torok-samuel/Digital-synthesizer-project/README.md

# Digital-synthesizer-project
Digital synthesizer project for university thesis.
