torok-samuel/Digital-synthesizer-project/freecad/8720efe9-da5f-489d-a8d7-8e3d5238dedc.91f98a0f974cae4ed9347f34f55e257e.webp

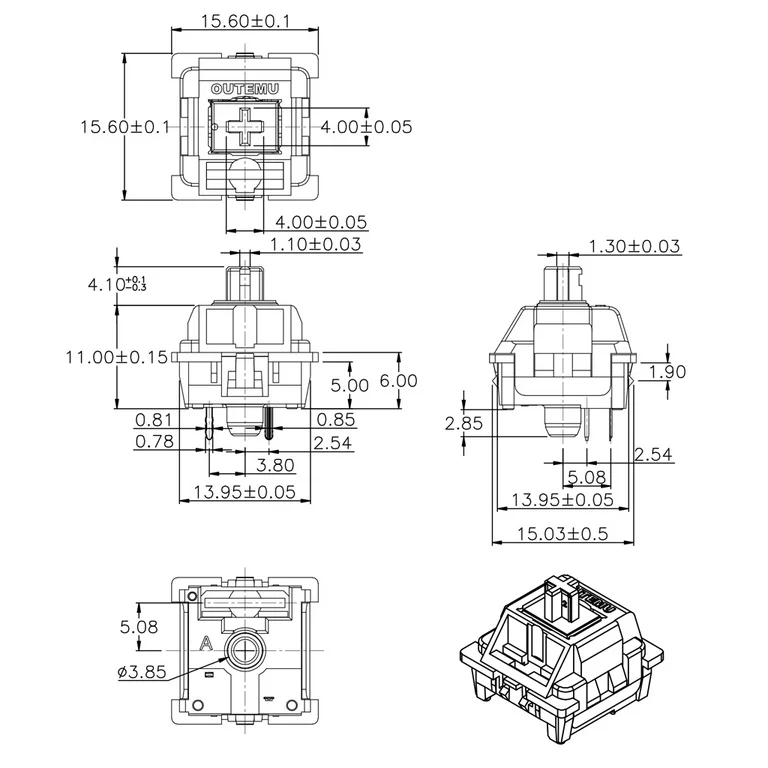
freecad/8720efe9-da5f-489d-a8d7-8e3d5238dedc.91f98a0f974cae4ed9347f34f55e257e.webp
