torok-samuel/Digital-synthesizer-project/freecad/black key/BlackKey.FCStd

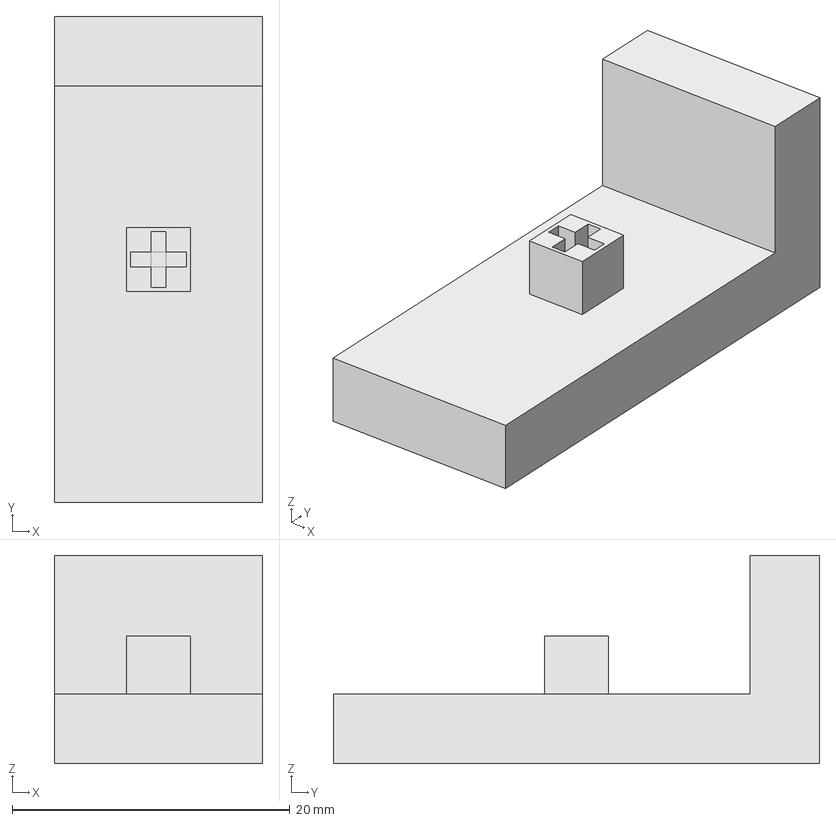
[picture p2: CAD file, 2023-10-30]
freecad/black key/BlackKey.FCStd
15.0 x 35.0 x 15.0 mm
