torok-samuel/Digital-synthesizer-project/freecad/key keyboard plate/KeyPlate.FCStd

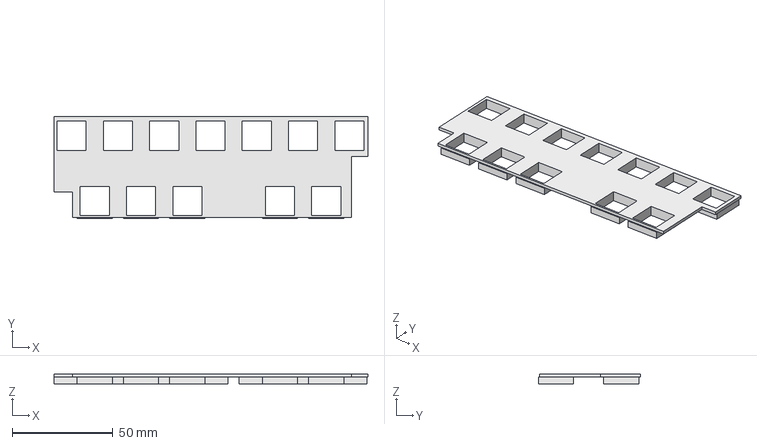
[picture p3: CAD file, 2023-11-30]
freecad/key keyboard plate/KeyPlate.FCStd
156.0 x 50.9 x 5.00 mm
