torok-samuel/Digital-synthesizer-project/freecad/pot keyboard plate/PotKeyPlate.FCStd

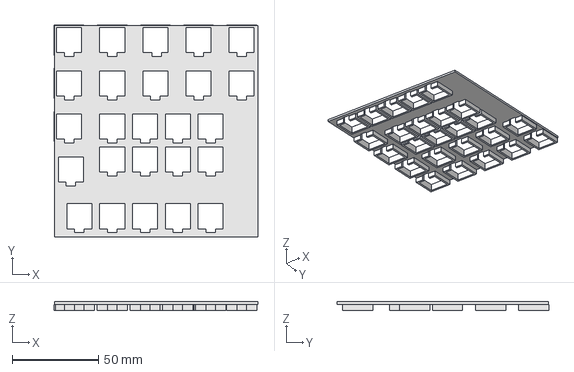
[picture p4: CAD file, 2023-11-30]
freecad/pot keyboard plate/PotKeyPlate.FCStd
118.2 x 122.7 x 5.00 mm
