torok-samuel/Digital-synthesizer-project/freecad/white key/WhiteKey-Body.stl

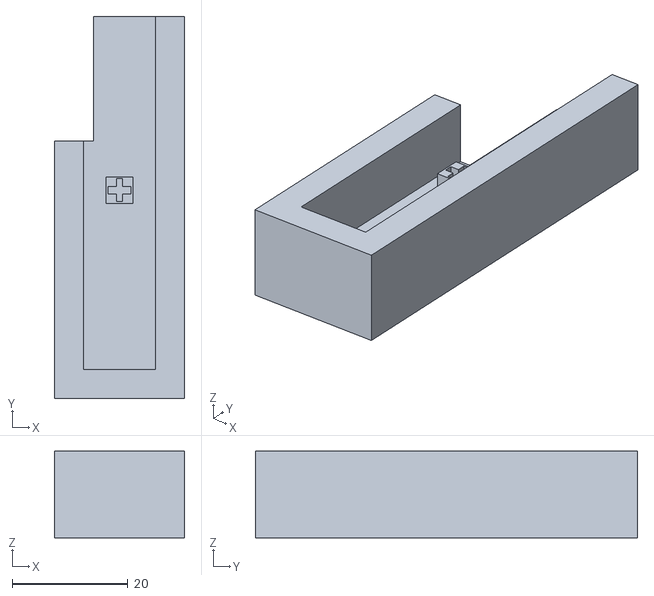
[picture p5: CAD file, 2023-10-30]
freecad/white key/WhiteKey-Body.stl
22.5 x 66.0 x 15.0
