torok-samuel/Digital-synthesizer-project/freecad/white key3/WhiteKey3.FCStd

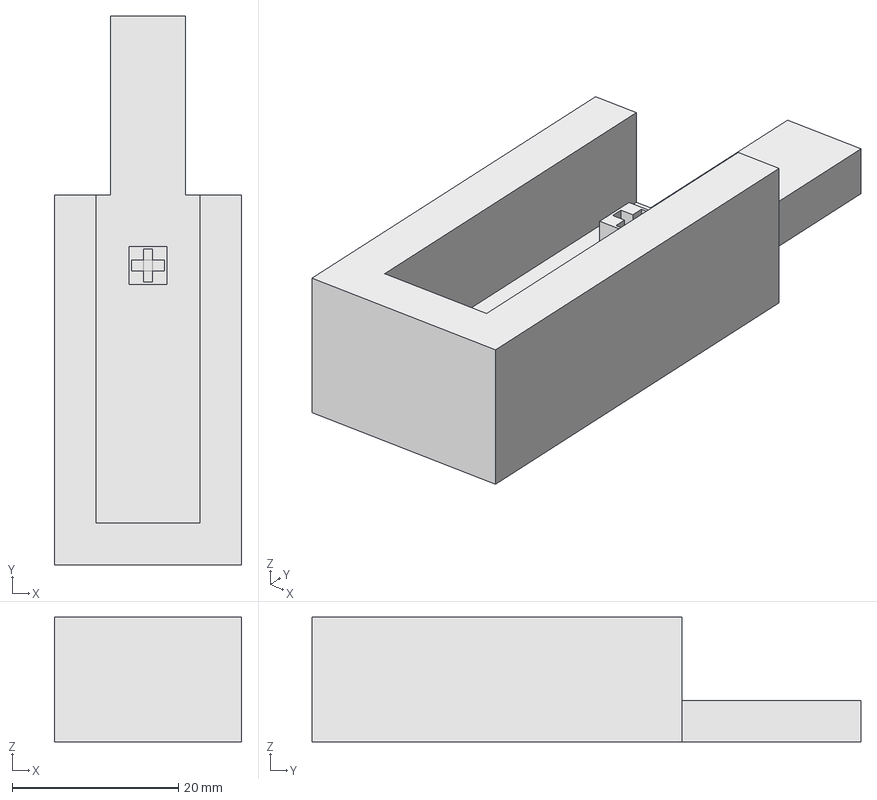
[picture p6: CAD file, 2023-10-30]
freecad/white key3/WhiteKey3.FCStd
22.5 x 66.0 x 15.0 mm
