torok-samuel/Digital-synthesizer-project/(list of files, cad)

Other CAD files:
freecad/white key2/WhiteKey2-Body.stl
freecad/black key/BlackKey-Body.stl
freecad/key keyboard plate/KeyPlate-Body.stl
freecad/pot keyboard plate/PotKeyPlate-Body.stl
freecad/white key/WhiteKey.FCStd
freecad/white key2/WhiteKey2.FCStd
freecad/white key3/WhiteKey3-Body.stl
