torok-samuel/Digital-synthesizer-project/Keyboard/keyboard/pdf/keyboard.pdf

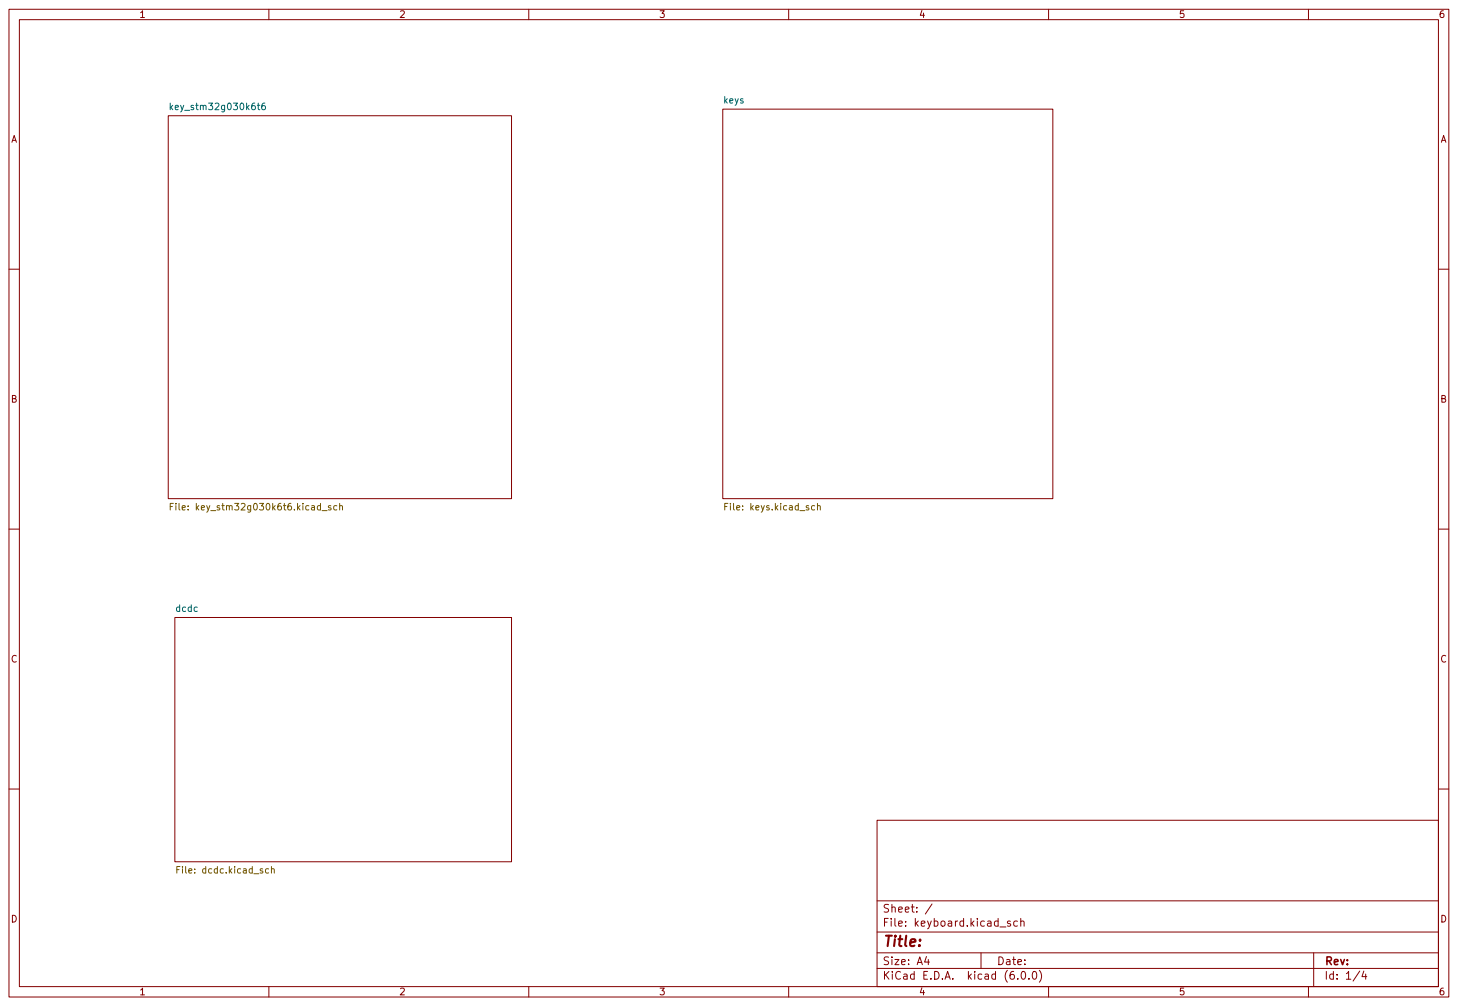
[picture p7: page 1]

File: keyboard.kicad_sch Sheet: / dcdc File: dcdc.kicad_sch

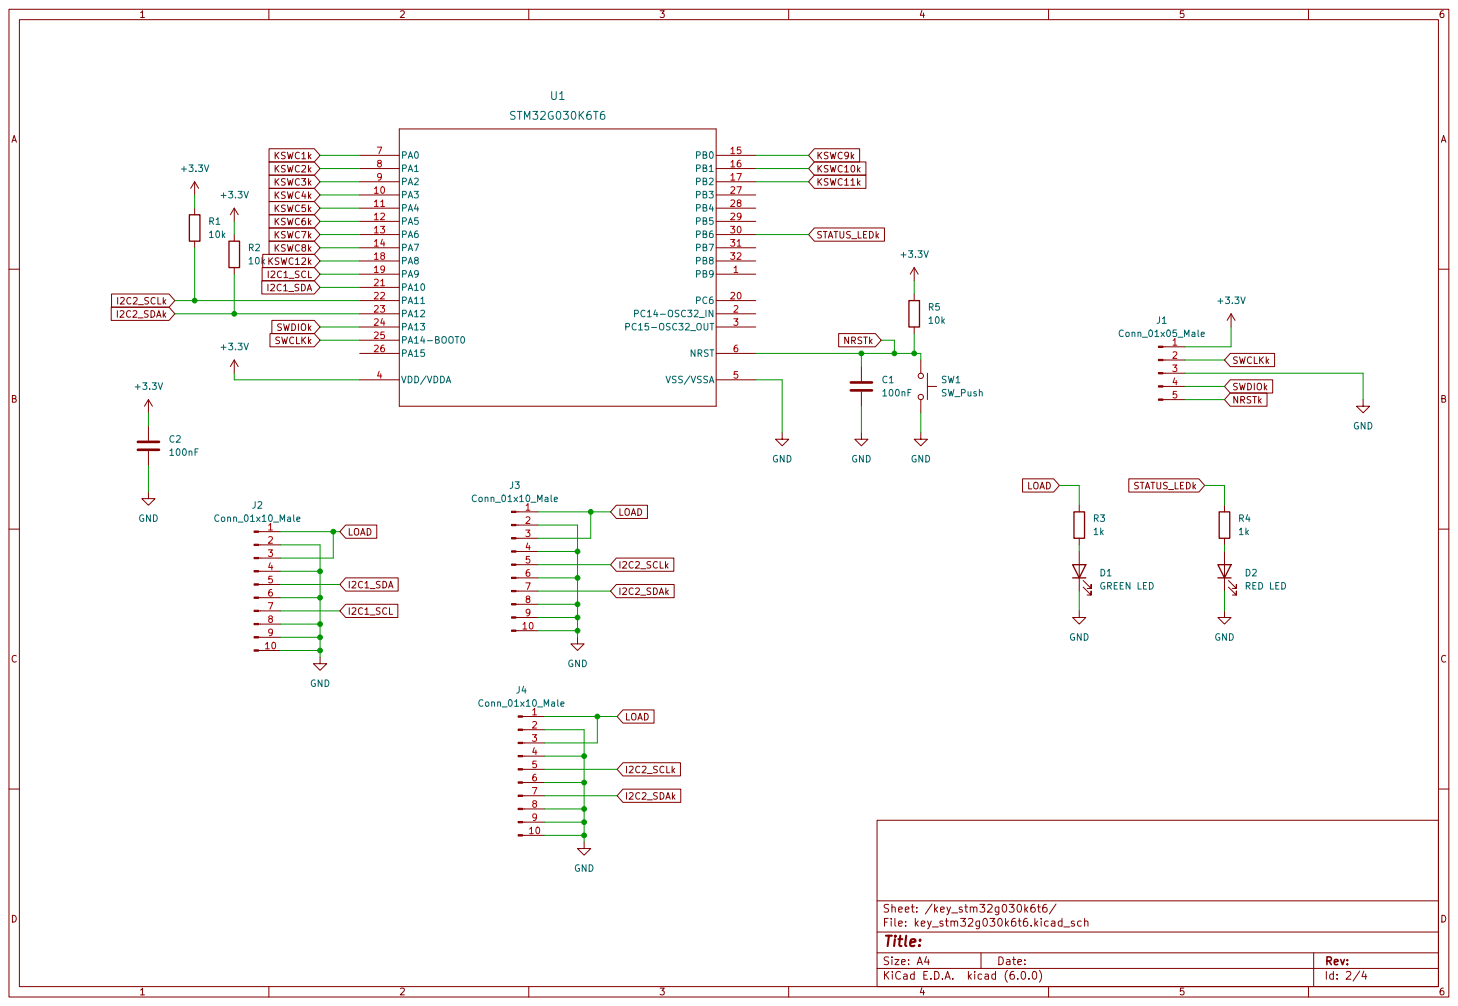
[picture p8: page 2]

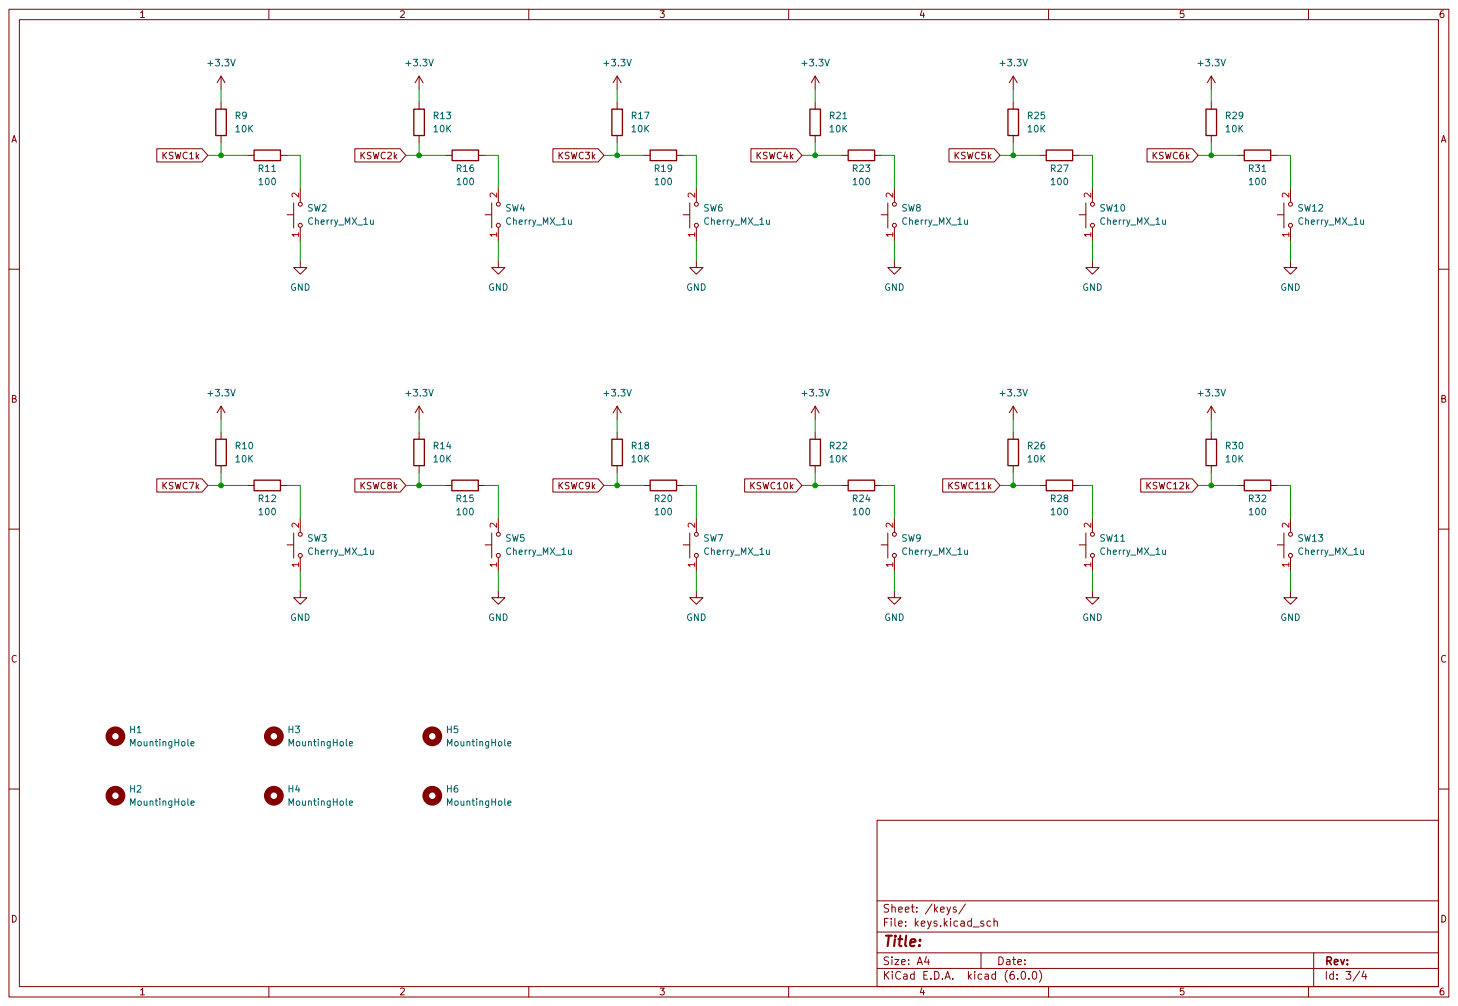
[picture p9: page 3]

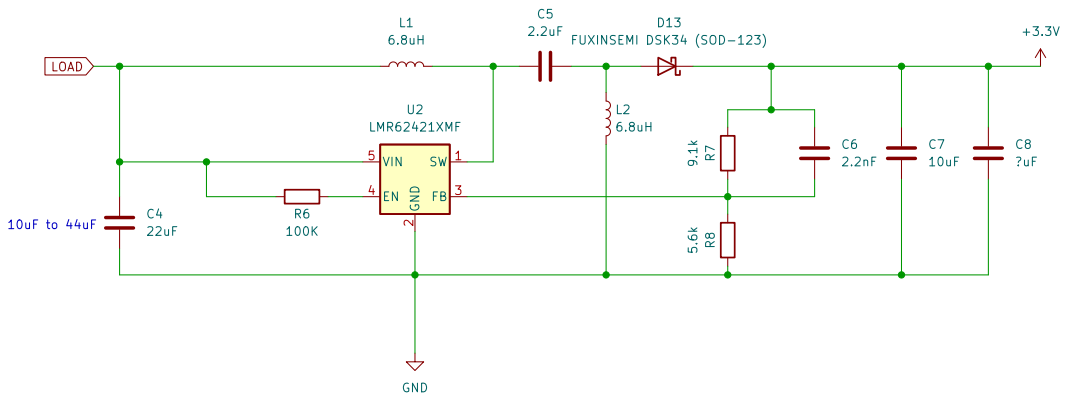
[picture p10: page 4]

File: dcdc.kicad_sch Sheet: /dcdc/
Id: 4/4 Title:
