torok-samuel/Digital-synthesizer-project/main_func/main_func/pdf/main_func.pdf

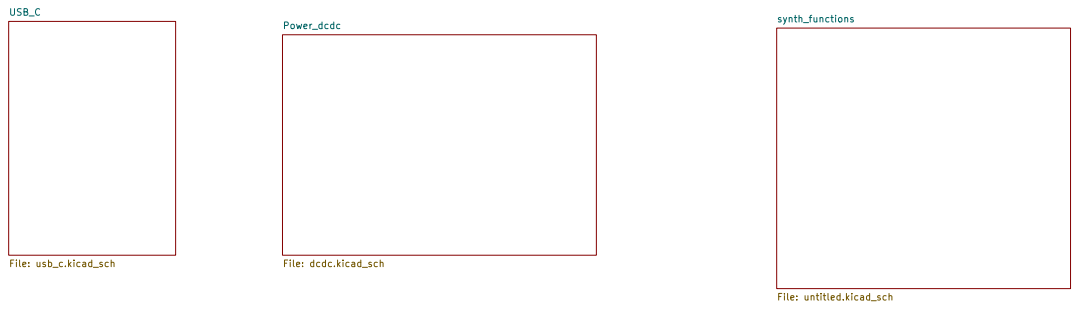
[picture p11: page 1]

synth_functions File: untitled.kicad_sch Power_dcdc File: dcdc.kicad_sch USB_C

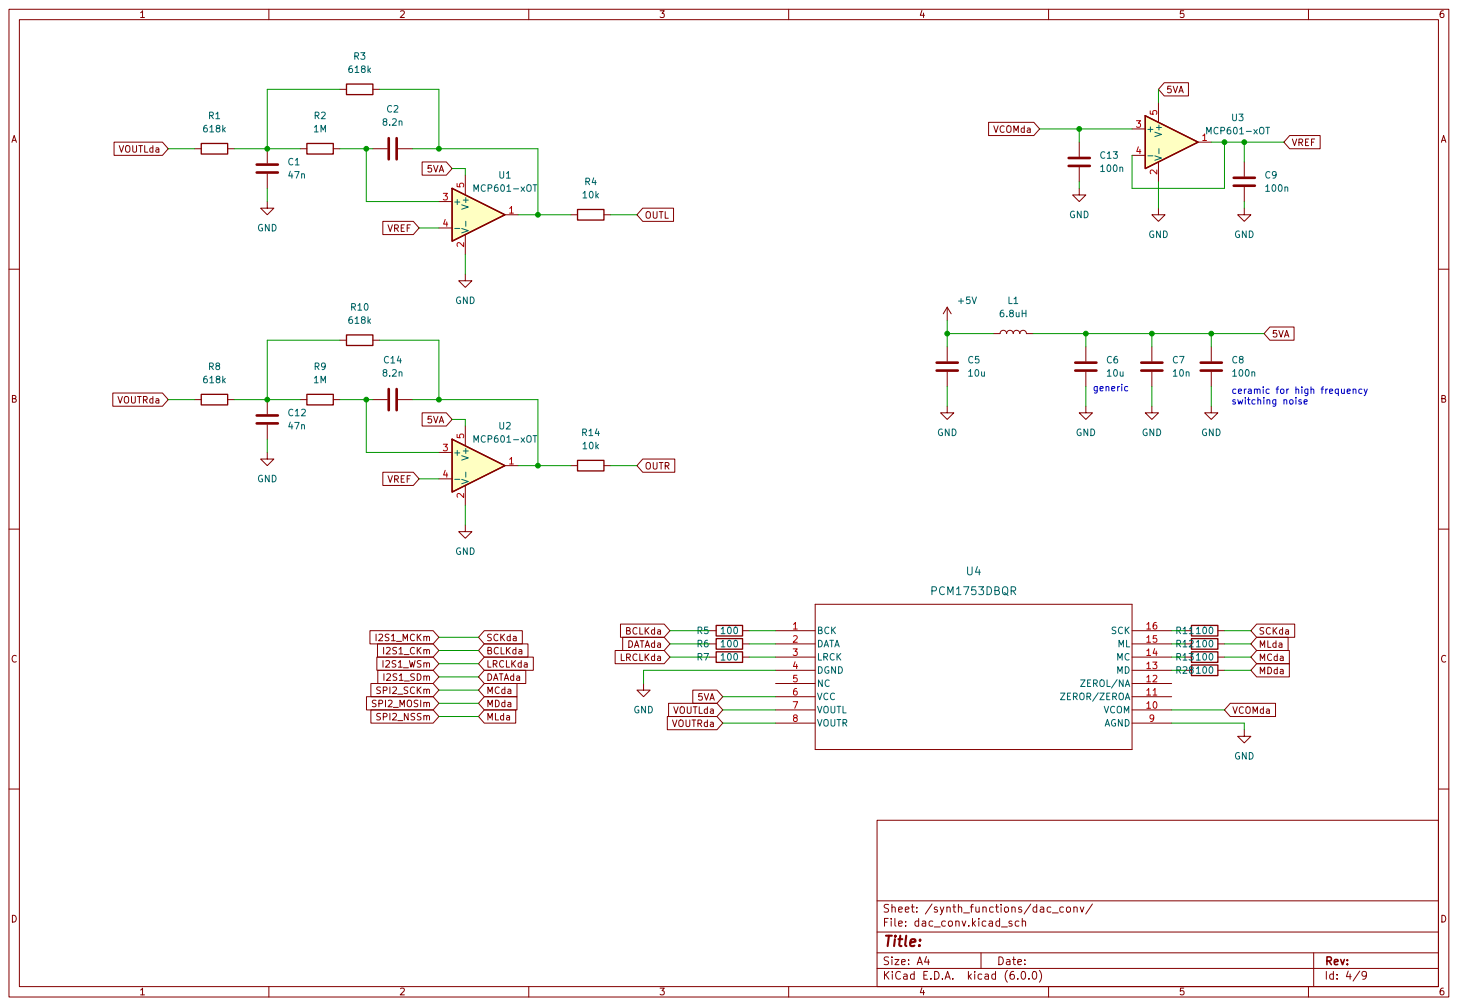
[picture p12: page 2]

ceramic for high frequency
switching noise

MDda VCOMda DATAda BCLKda VOUTRda

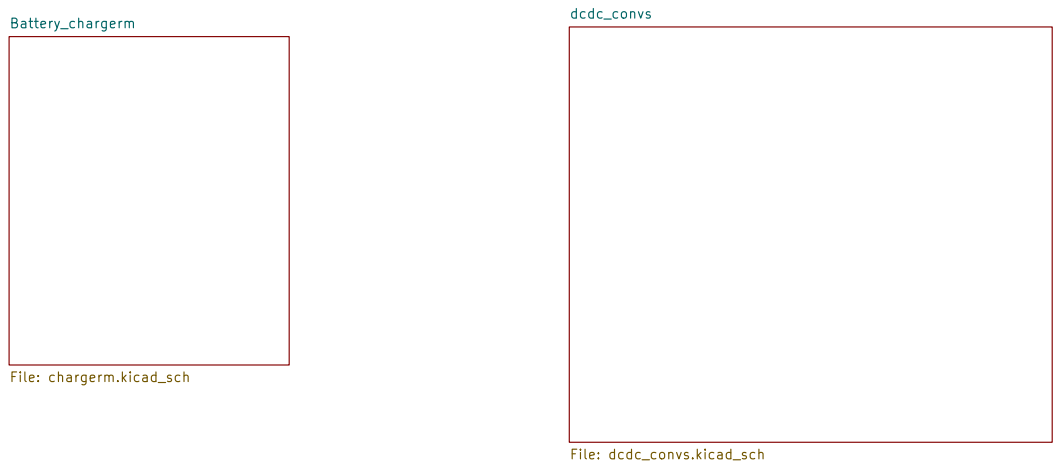
[picture p13: page 3]

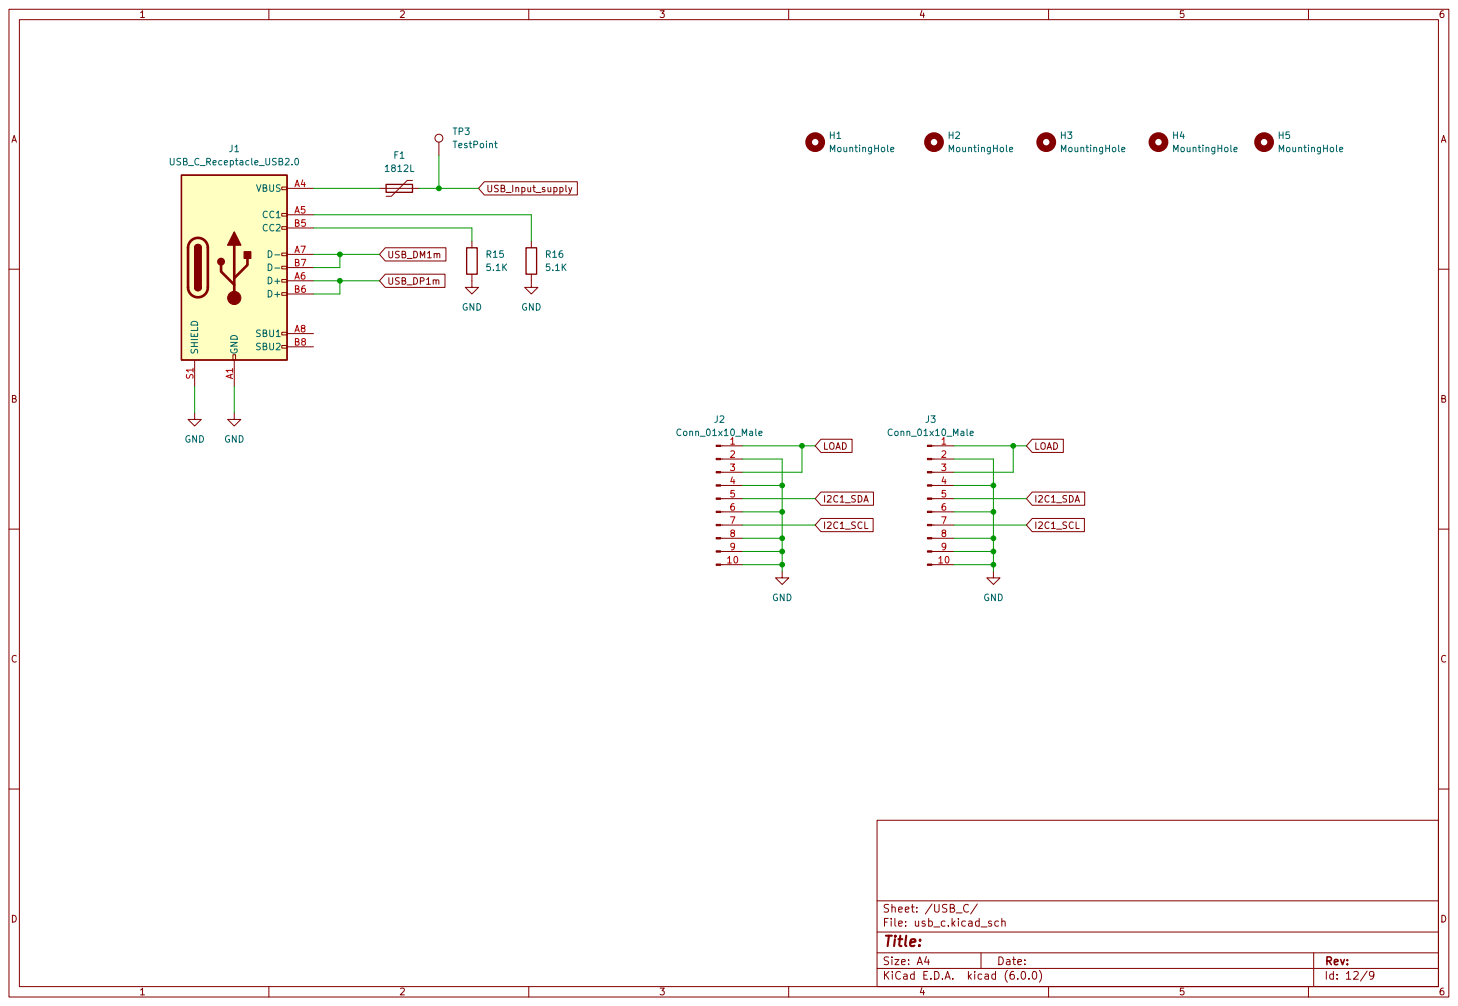
[picture p14: page 4]

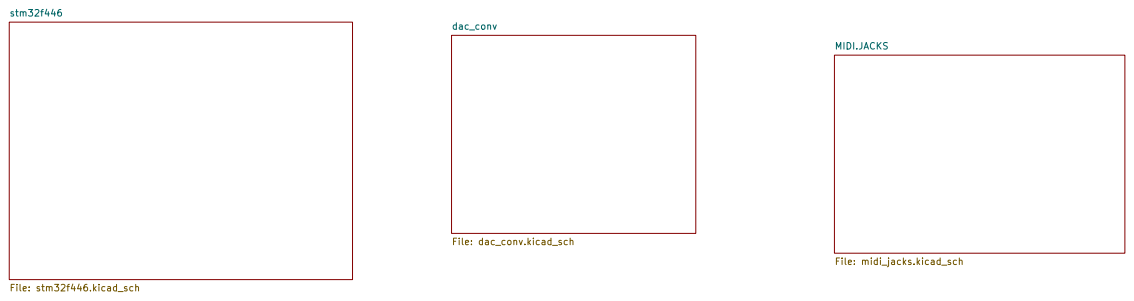
[picture p15: page 5]

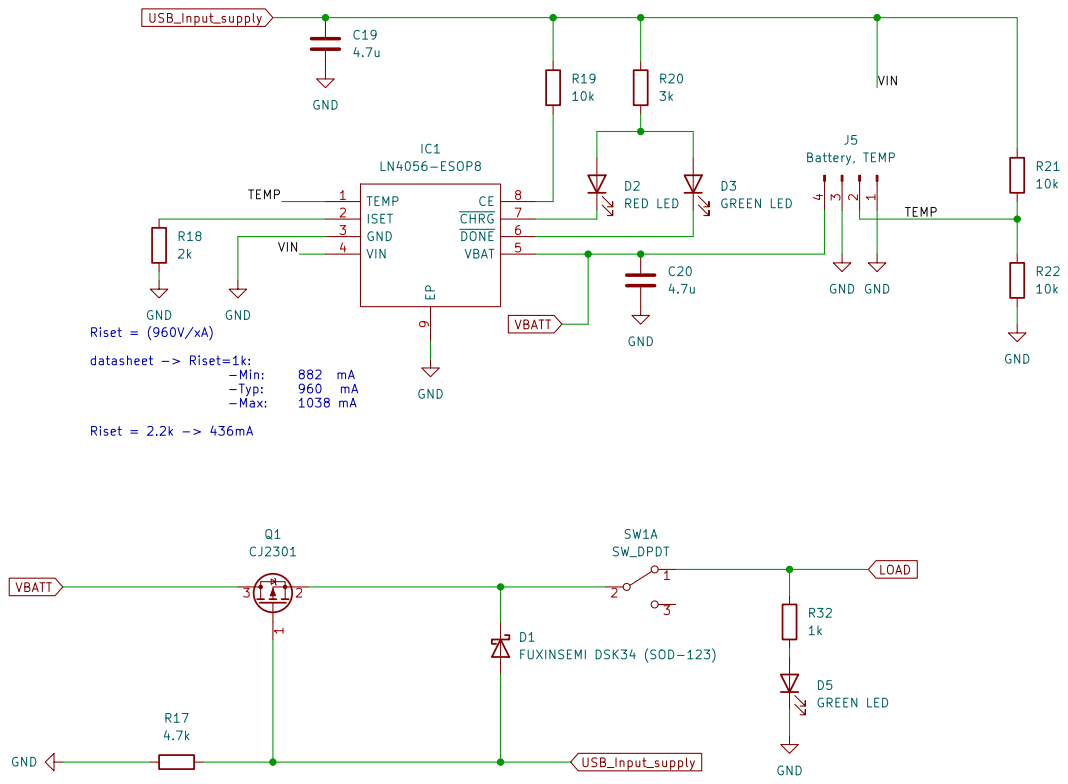
[picture p16: page 6]

TEMP Riset = (960V/xA) datasheet -> Riset=1k:

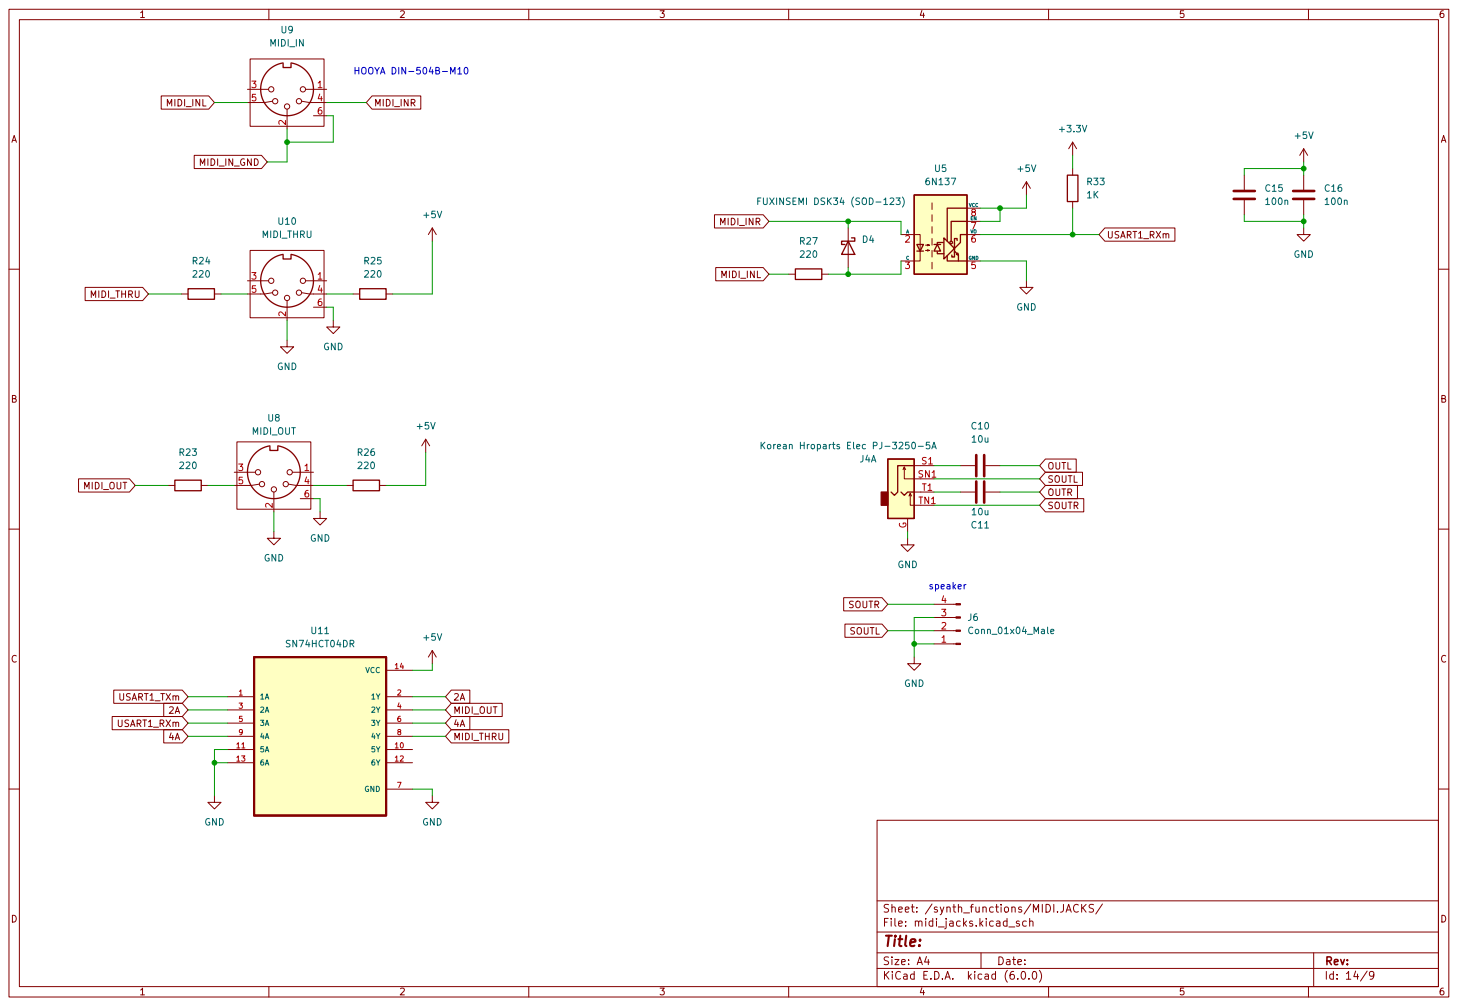
[picture p17: page 7]

Korean Hroparts Elec PJ-3250-5A GND

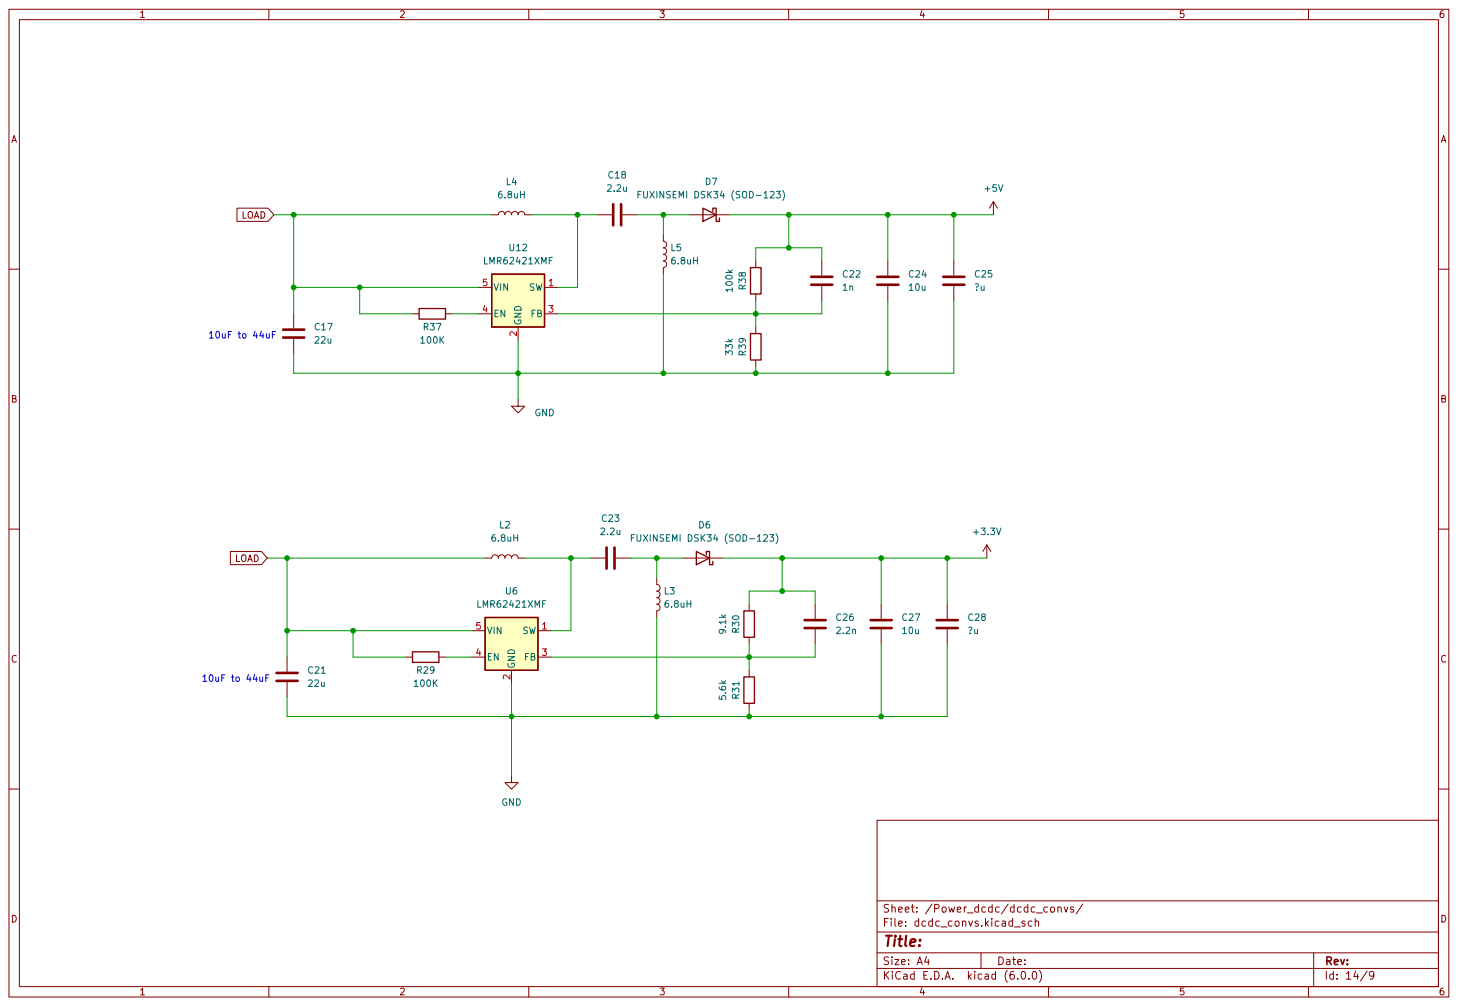
[picture p18: page 8]

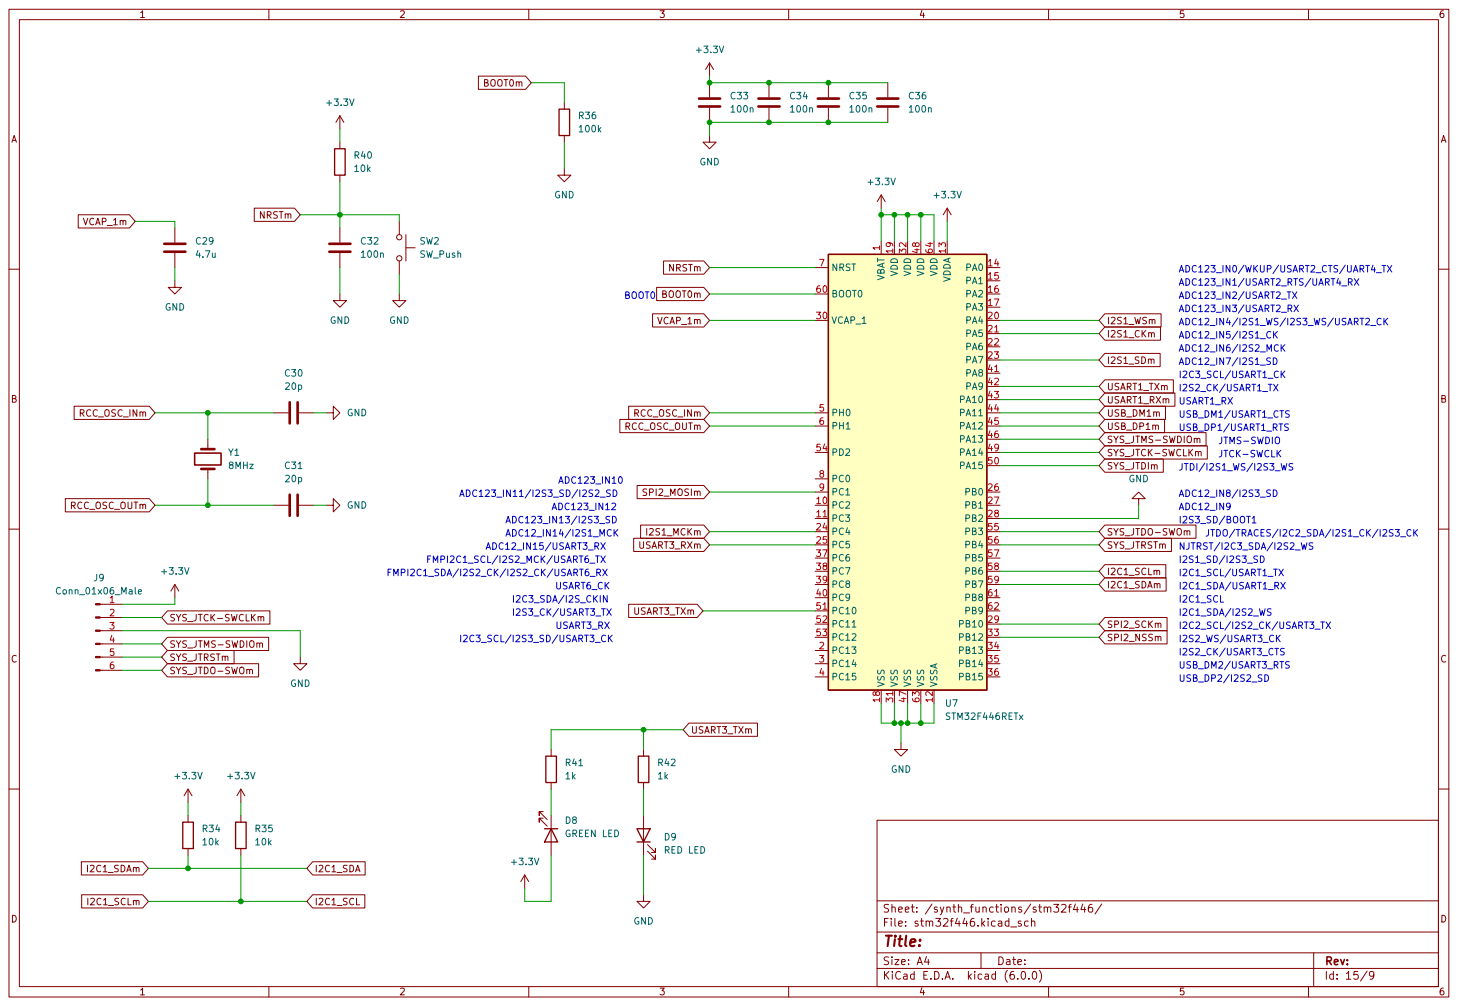
[picture p19: page 9]

1 PC2 10 PC3 11 VSSA 12 VDDA 13 PA0 14 PA1 15 PA2 16 PA3 17 VSS 18 VDD 19 PC13 2 PA4 20 PA5 21 PA6 22 PA7 23 PC4 24 PC5 25 PB0 26 PB1 27 PB2 28 PB10 29 PC14 3 VCAP_1 30 VSS 31 VDD 32 PB12 33 PB13 34 PB14 35 PB15 36 PC6 37 PC7 38 PC8 39 PC15 4 PC9 40 PA8 41 PA9 42 PA10 43 PA11 44 PA12 45 PA13 46 VSS 47 VDD 48 PA14 49 PH0 5 PA15 50 PC10 51 PC11 52 PC12 53 PD2 54 PB3 55 PB4 56 PB5 57 PB6 58 PB7 59 PH1 6 BOOT0 60 PB8 61 PB9 62 VSS 63 VDD 64 NRST 7 PC0 8 PC1 9 U7STM32F446RETx C30
