torok-samuel/Digital-synthesizer-project/Pot.butt_pcb/Pot.butt_pcb/pdf/Pot.butt_pcb.pdf

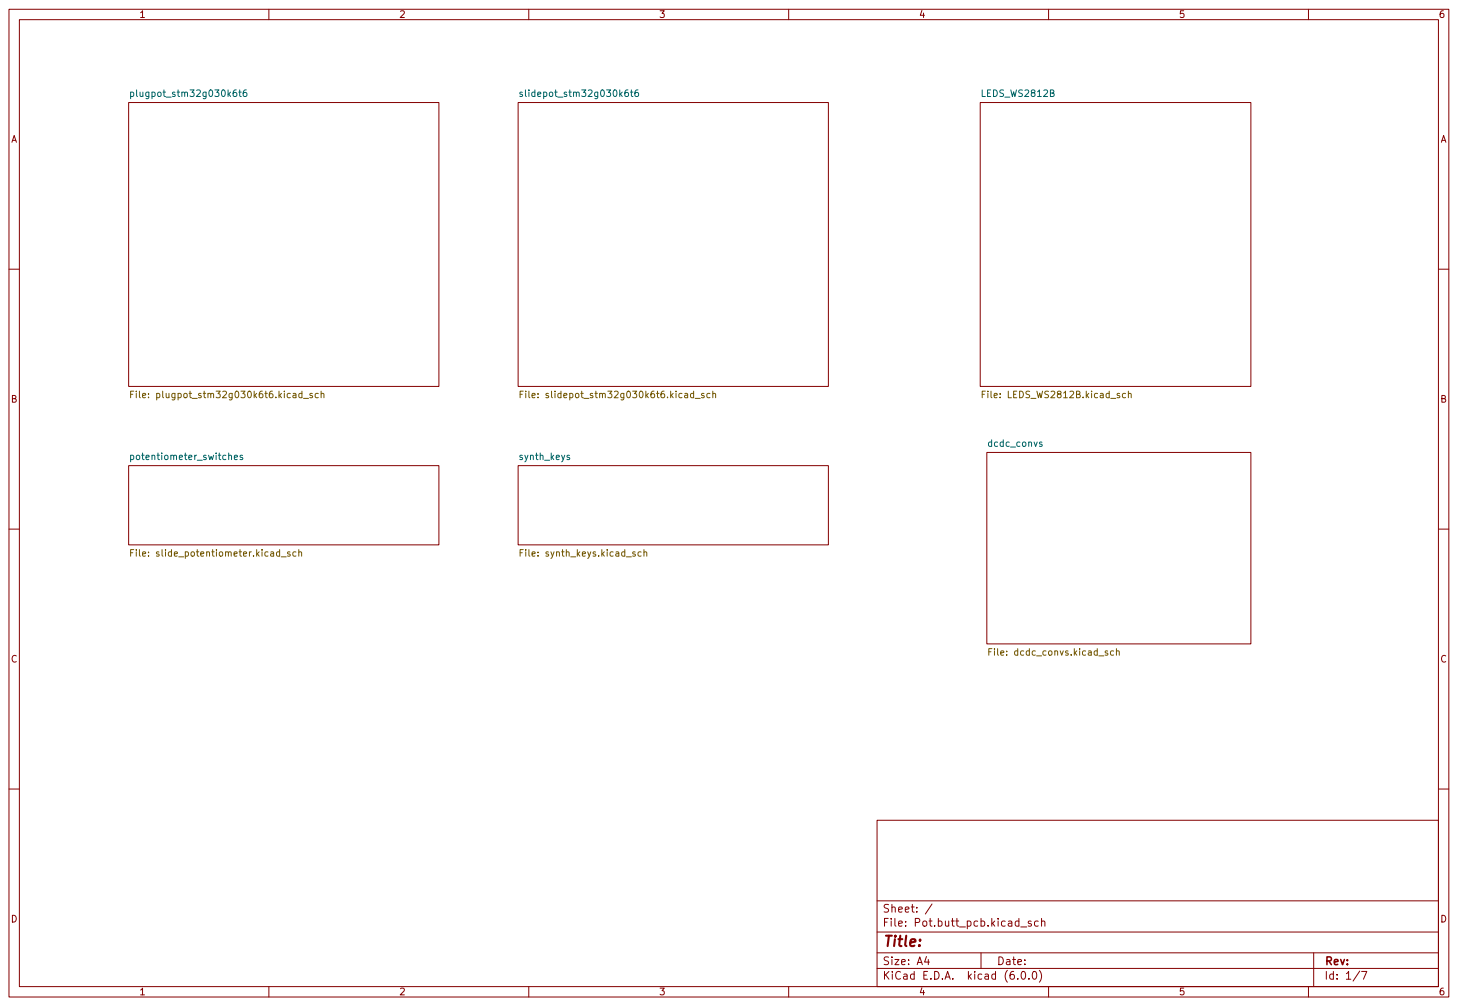
[picture p20: page 1]

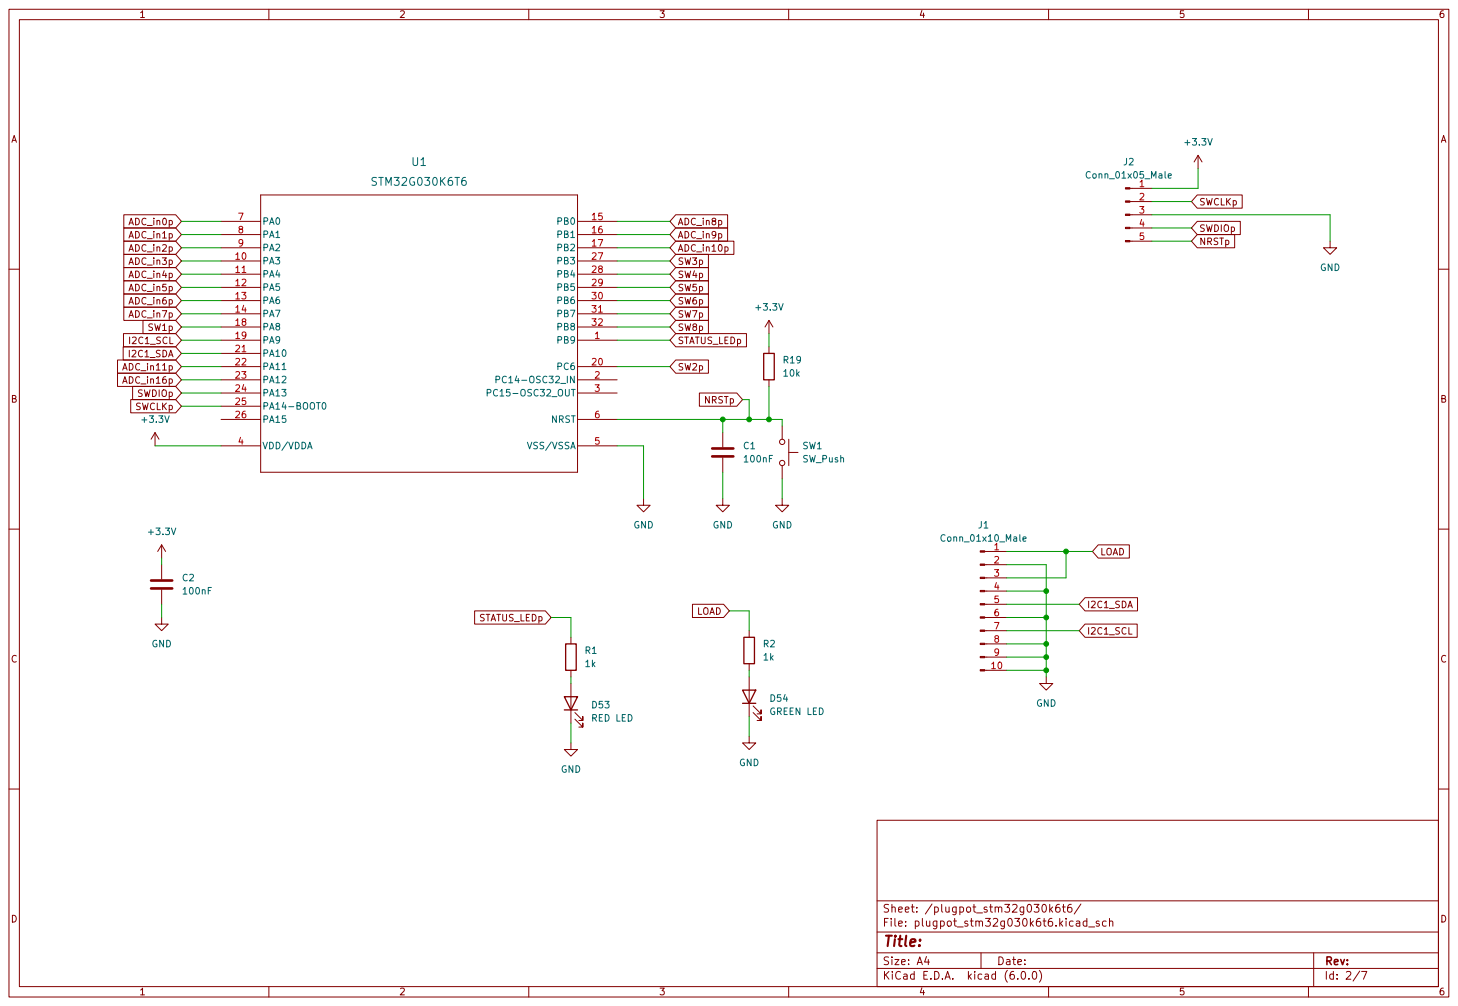
[picture p21: page 2]

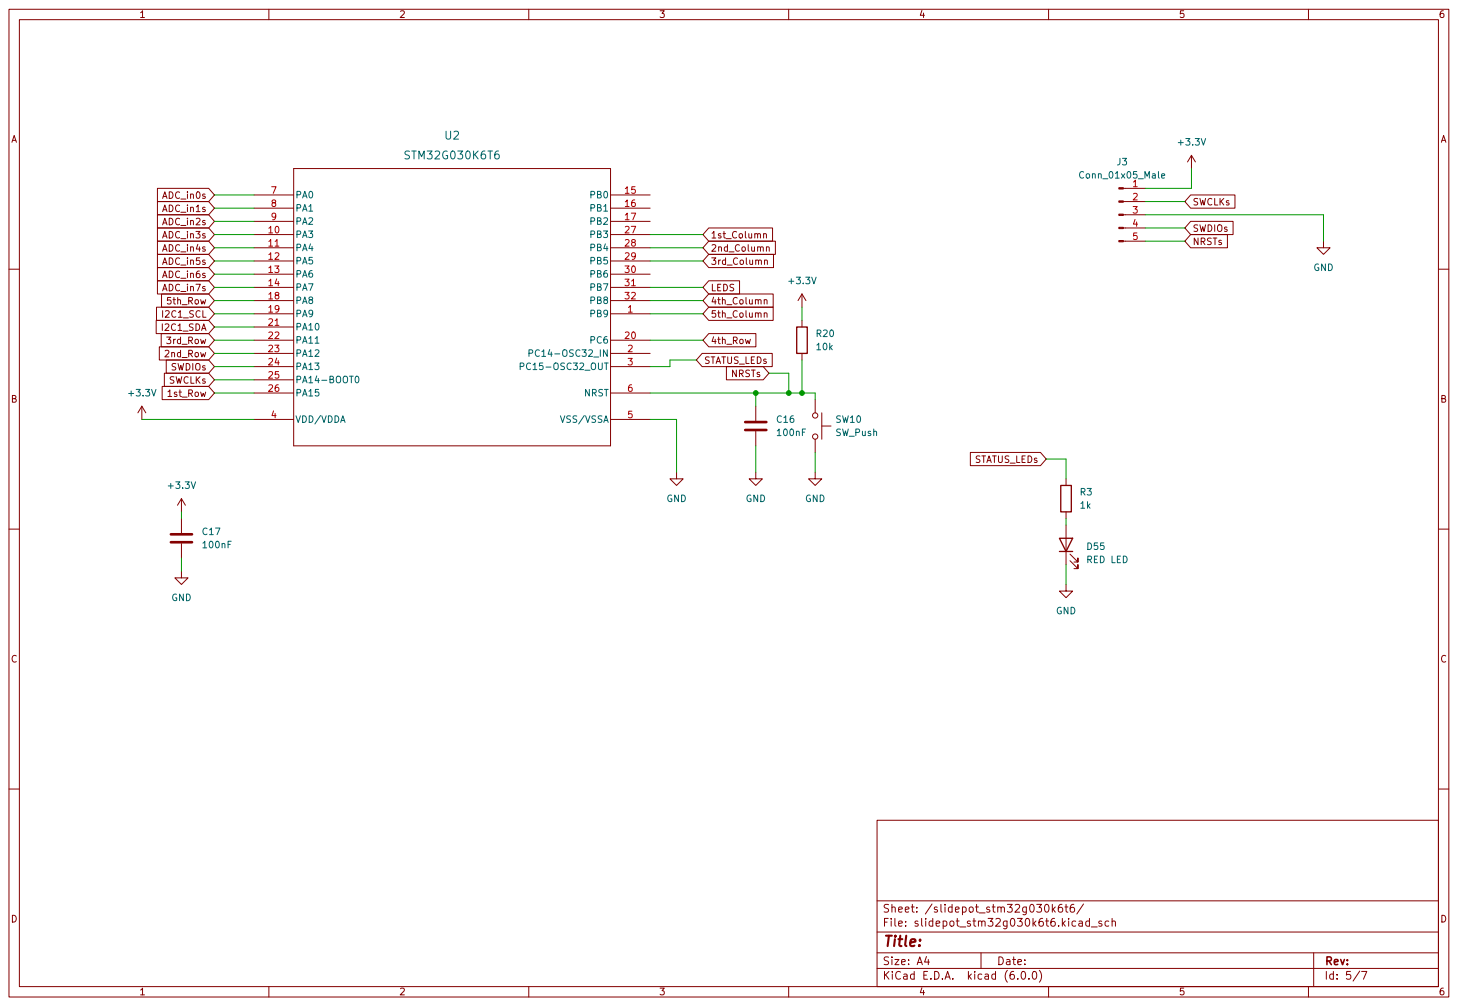
[picture p22: page 3]

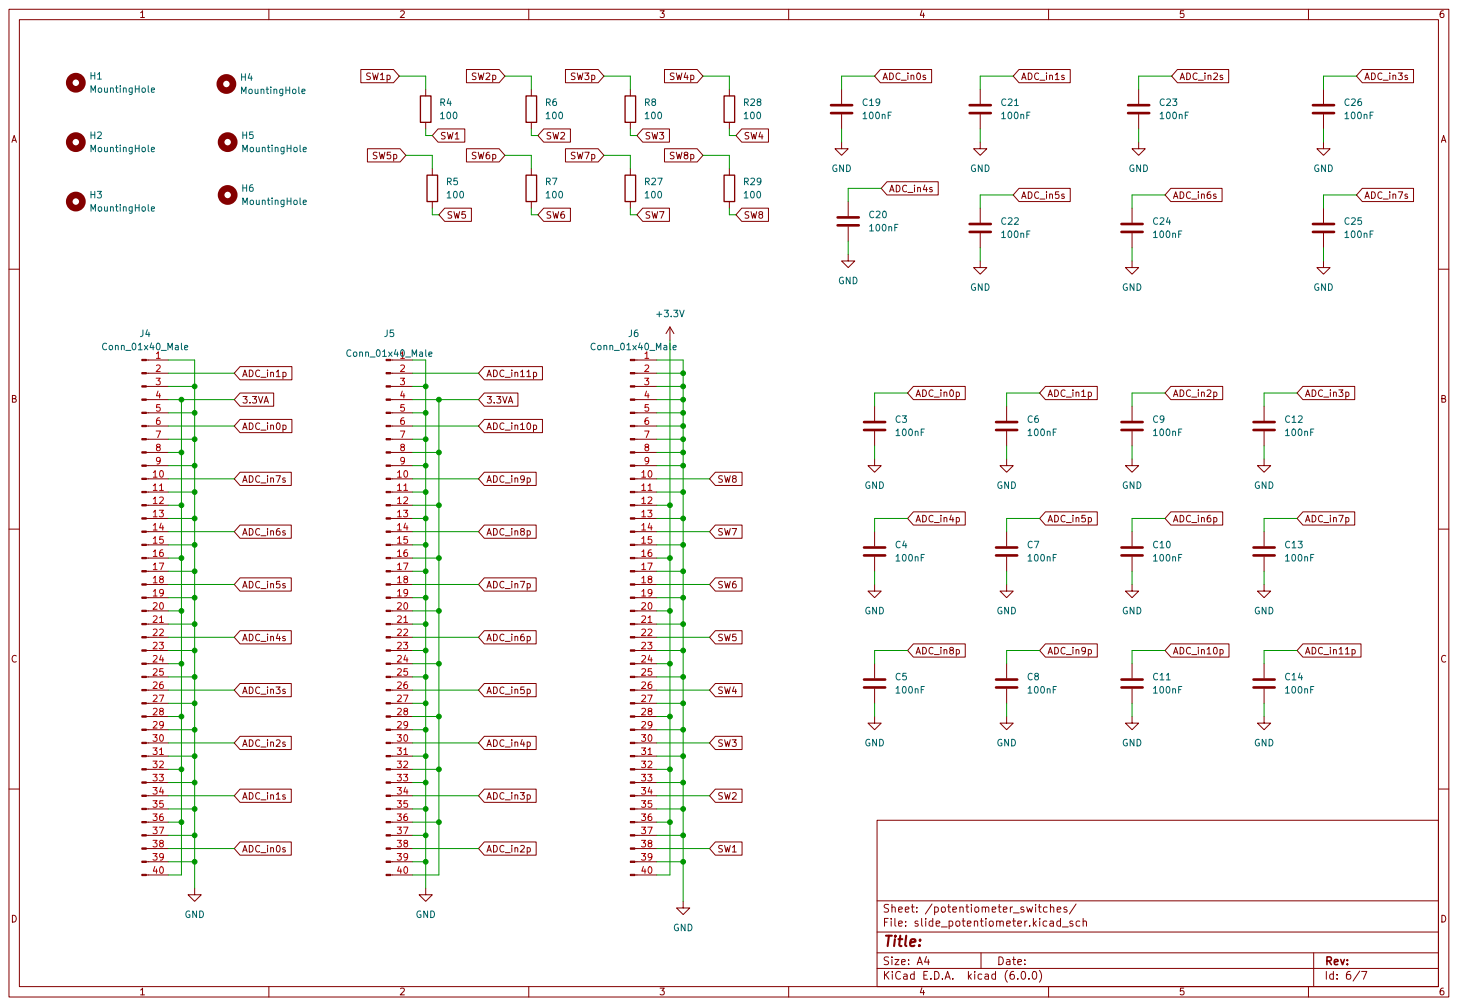
[picture p23: page 4]

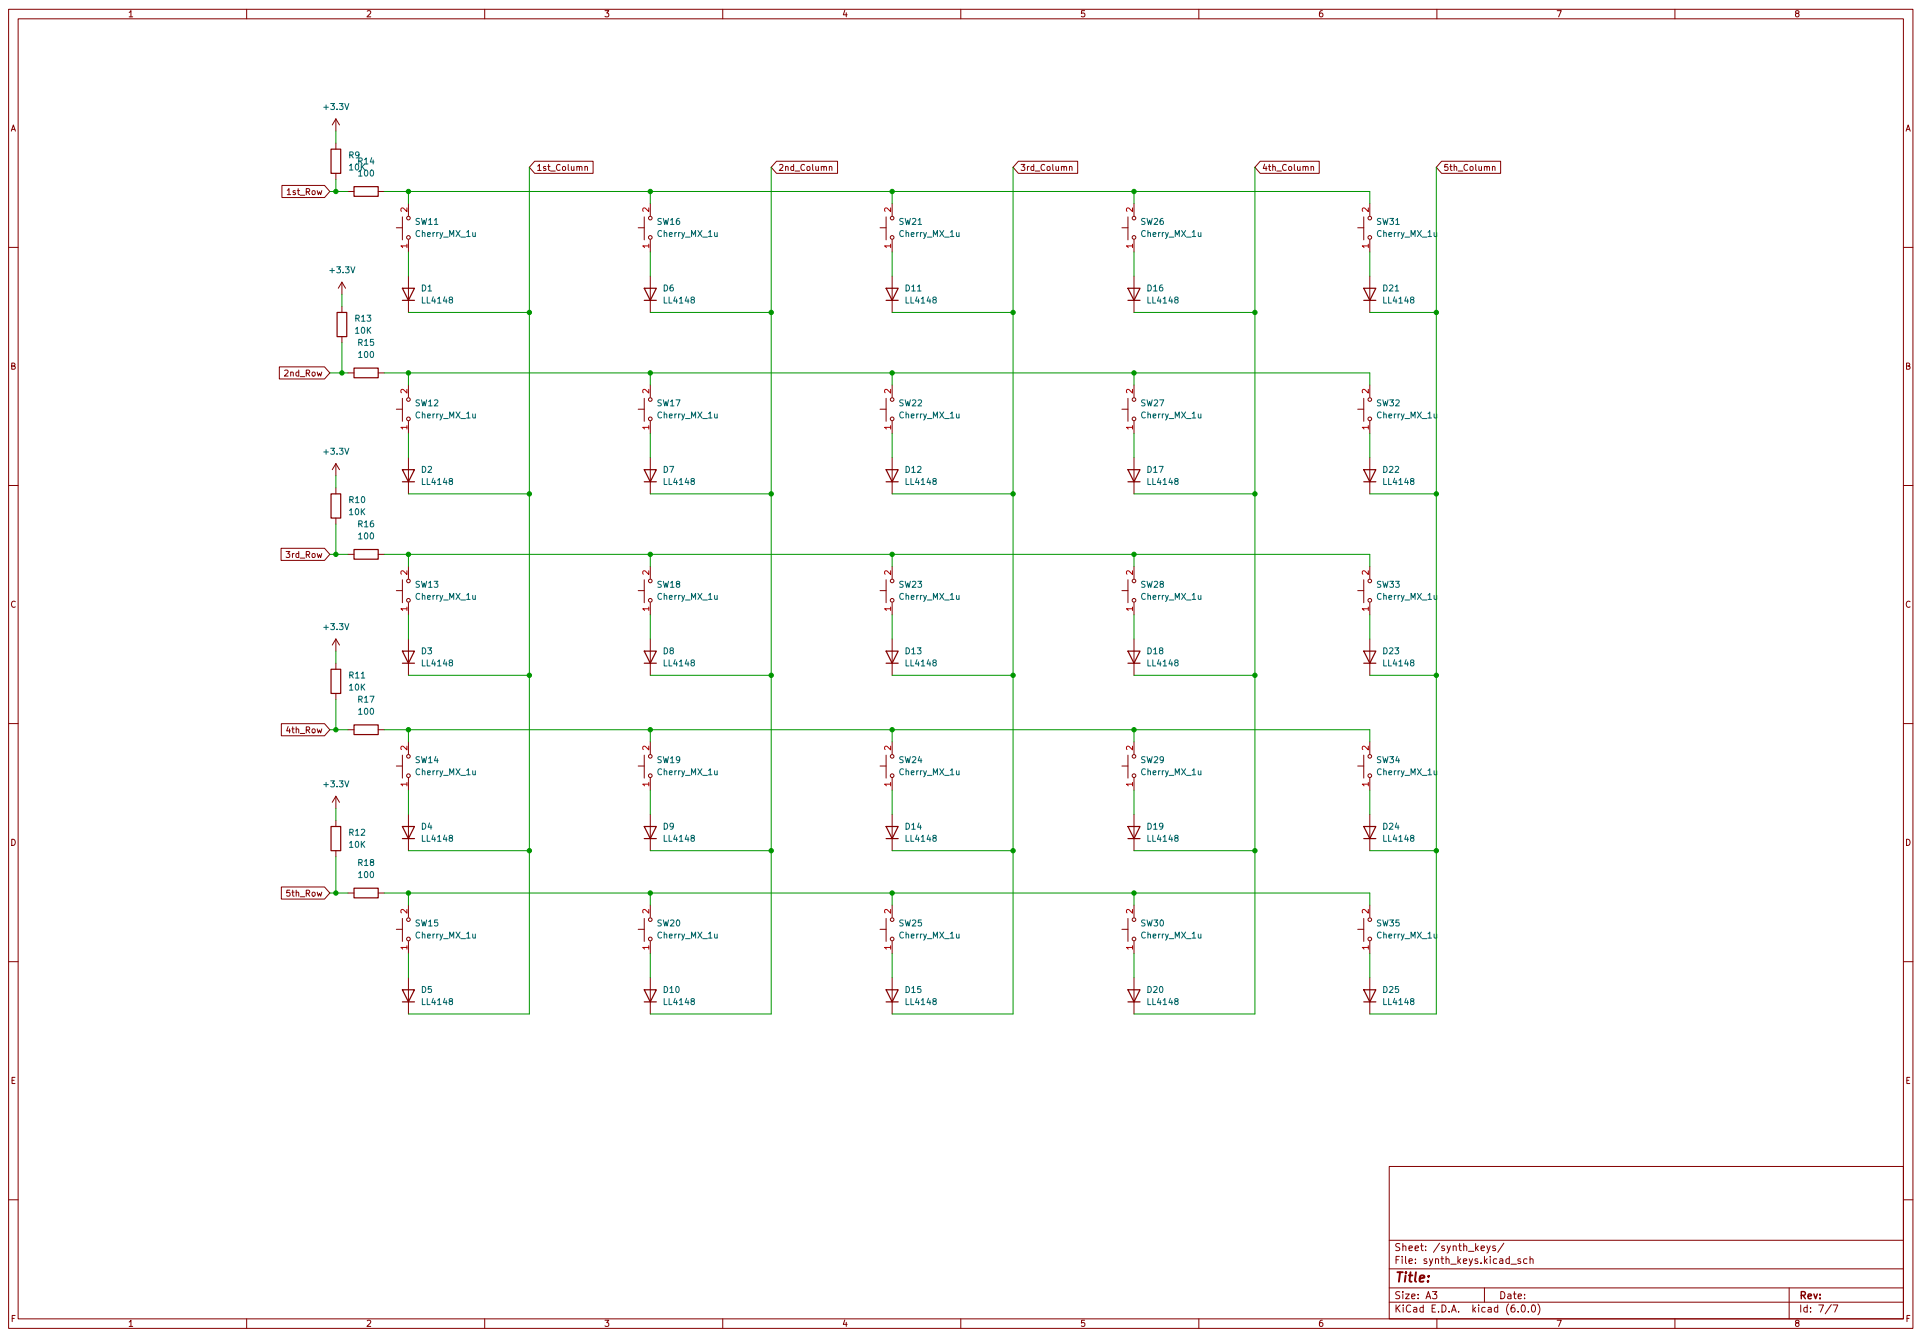
[picture p24: page 5]

Id: 7/7 Title: File: synth_keys.kicad_sch Sheet: /synth_keys/

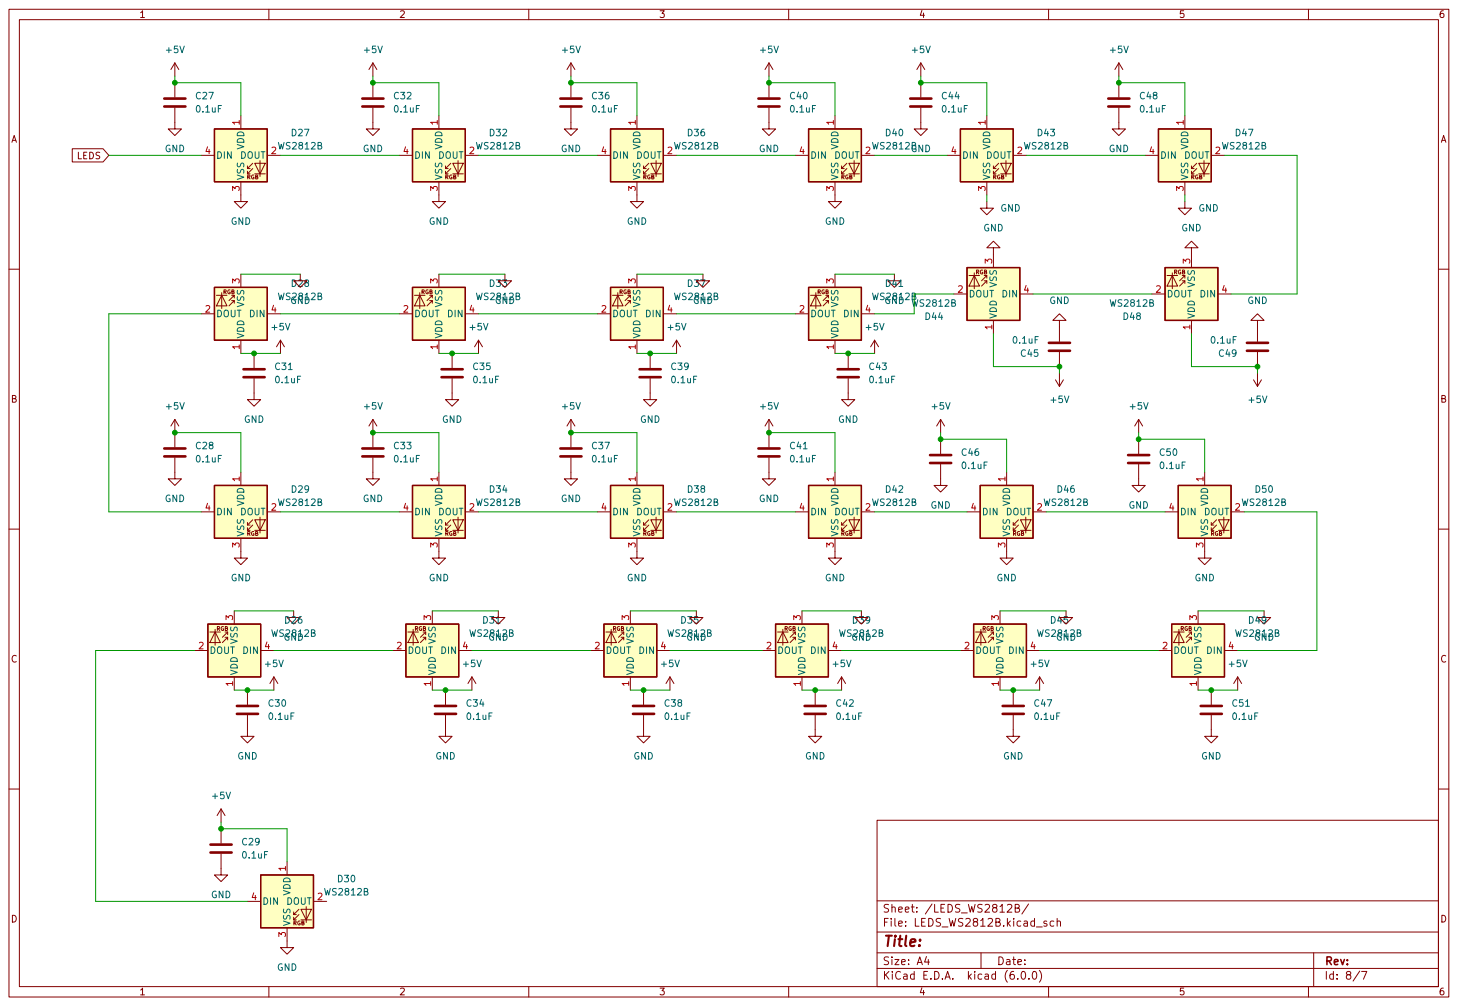
[picture p25: page 6]

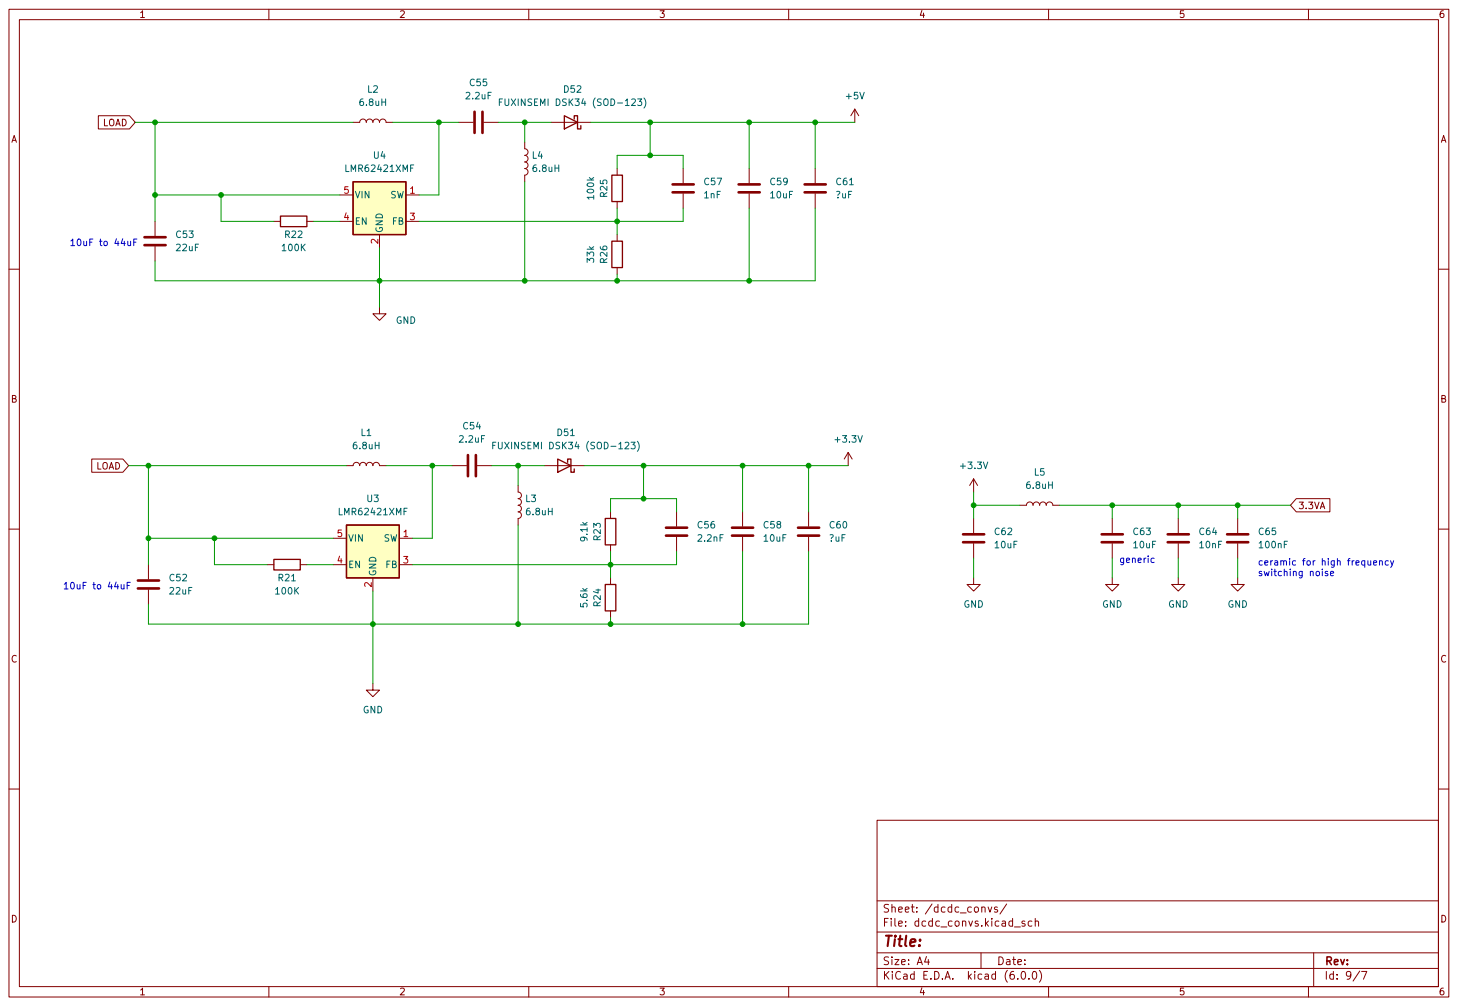
[picture p26: page 7]
