torok-samuel/Digital-synthesizer-project/Pot.butt_pcb/Pot.butt_pcb/Pot.butt_pcb.kicad_pcb

## KiCad design Pot.butt_pcb/Pot.butt_pcb/Pot.butt_pcb.kicad_pcb (2023-05-13)

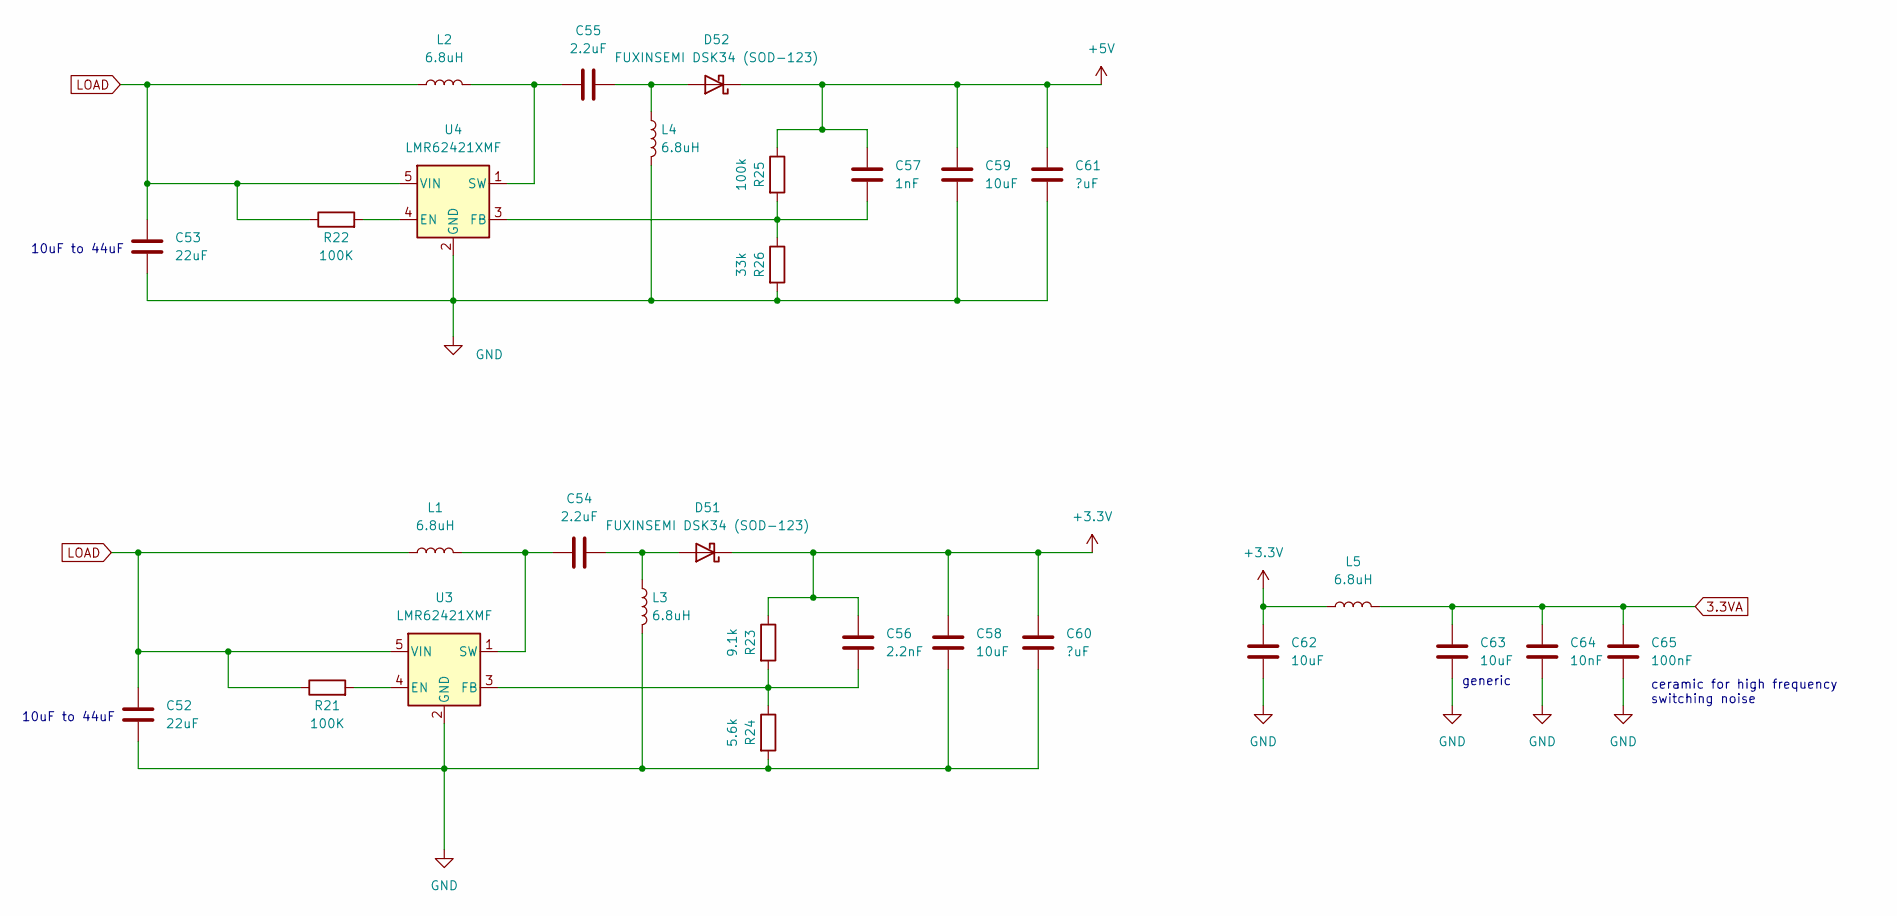
[picture p27: schematic dcdc_convs.kicad_sch]

Parts:
C52, C53: 22uF; C_0805_2012Metric_Pad1.18x1.45mm_HandSolder
C54, C55: 2.2uF; C_0805_2012Metric_Pad1.18x1.45mm_HandSolder
C56: 2.2nF; C_0805_2012Metric_Pad1.18x1.45mm_HandSolder
C57: 1nF; C_0805_2012Metric_Pad1.18x1.45mm_HandSolder
C58, C59, C62, C63: 10uF; C_0805_2012Metric_Pad1.18x1.45mm_HandSolder
C60, C61: ?uF; C_0805_2012Metric_Pad1.18x1.45mm_HandSolder
C64: 10nF; C_0805_2012Metric_Pad1.18x1.45mm_HandSolder
C65: 100nF; C_0805_2012Metric_Pad1.18x1.45mm_HandSolder
D51, D52: FUXINSEMI DSK34 (SOD-123); D_SOD-123
L1, L2, L3, L4, L5: 6.8uH; inductor_koherelec
R21, R22: 100K; R_0805_2012Metric_Pad1.20x1.40mm_HandSolder
R23: 9.1k; R_0805_2012Metric_Pad1.20x1.40mm_HandSolder
R24: 5.6k; R_0805_2012Metric_Pad1.20x1.40mm_HandSolder
R25: 100k; R_0805_2012Metric_Pad1.20x1.40mm_HandSolder
R26: 33k; R_0805_2012Metric_Pad1.20x1.40mm_HandSolder
U3, U4: LMR62421XMF; SOT-23-5

Connections:
3.3VA: C63.1, C64.1, C65.1, L5.2; also elsewhere on the board
+3V3: C56.1, C58.1, C60.1, C62.1, D51.1 (K), L5.1, R23.1; also elsewhere on the board
+5V: C57.1, C59.1, C61.1, D52.1 (K), R25.1; also elsewhere on the board
GND: C52.2, C53.2, C58.2, C59.2, C60.2, C61.2, C62.2, C63.2, C64.2, C65.2, L3.2, L4.2, R24.2, R26.2, U3.2 (GND), U4.2 (GND); also elsewhere on the board
LOAD: C52.1, C53.1, L1.1, L2.1, R21.1, R22.1, U3.5 (VIN), U4.5 (VIN); also elsewhere on the board
unnamed: C54.1, L1.2, U3.1 (SW)
unnamed: C54.2, D51.2 (A), L3.1
unnamed: C55.1, L2.2, U4.1 (SW)
unnamed: C55.2, D52.2 (A), L4.1
unnamed: C56.2, R23.2, R24.1, U3.3 (FB)
unnamed: C57.2, R25.2, R26.1, U4.3 (FB)
unnamed: R21.2, U3.4 (EN)
unnamed: R22.2, U4.4 (EN)

Notes on the sheet:
10uF to 44uF
generic
ceramic for high frequency switching noise

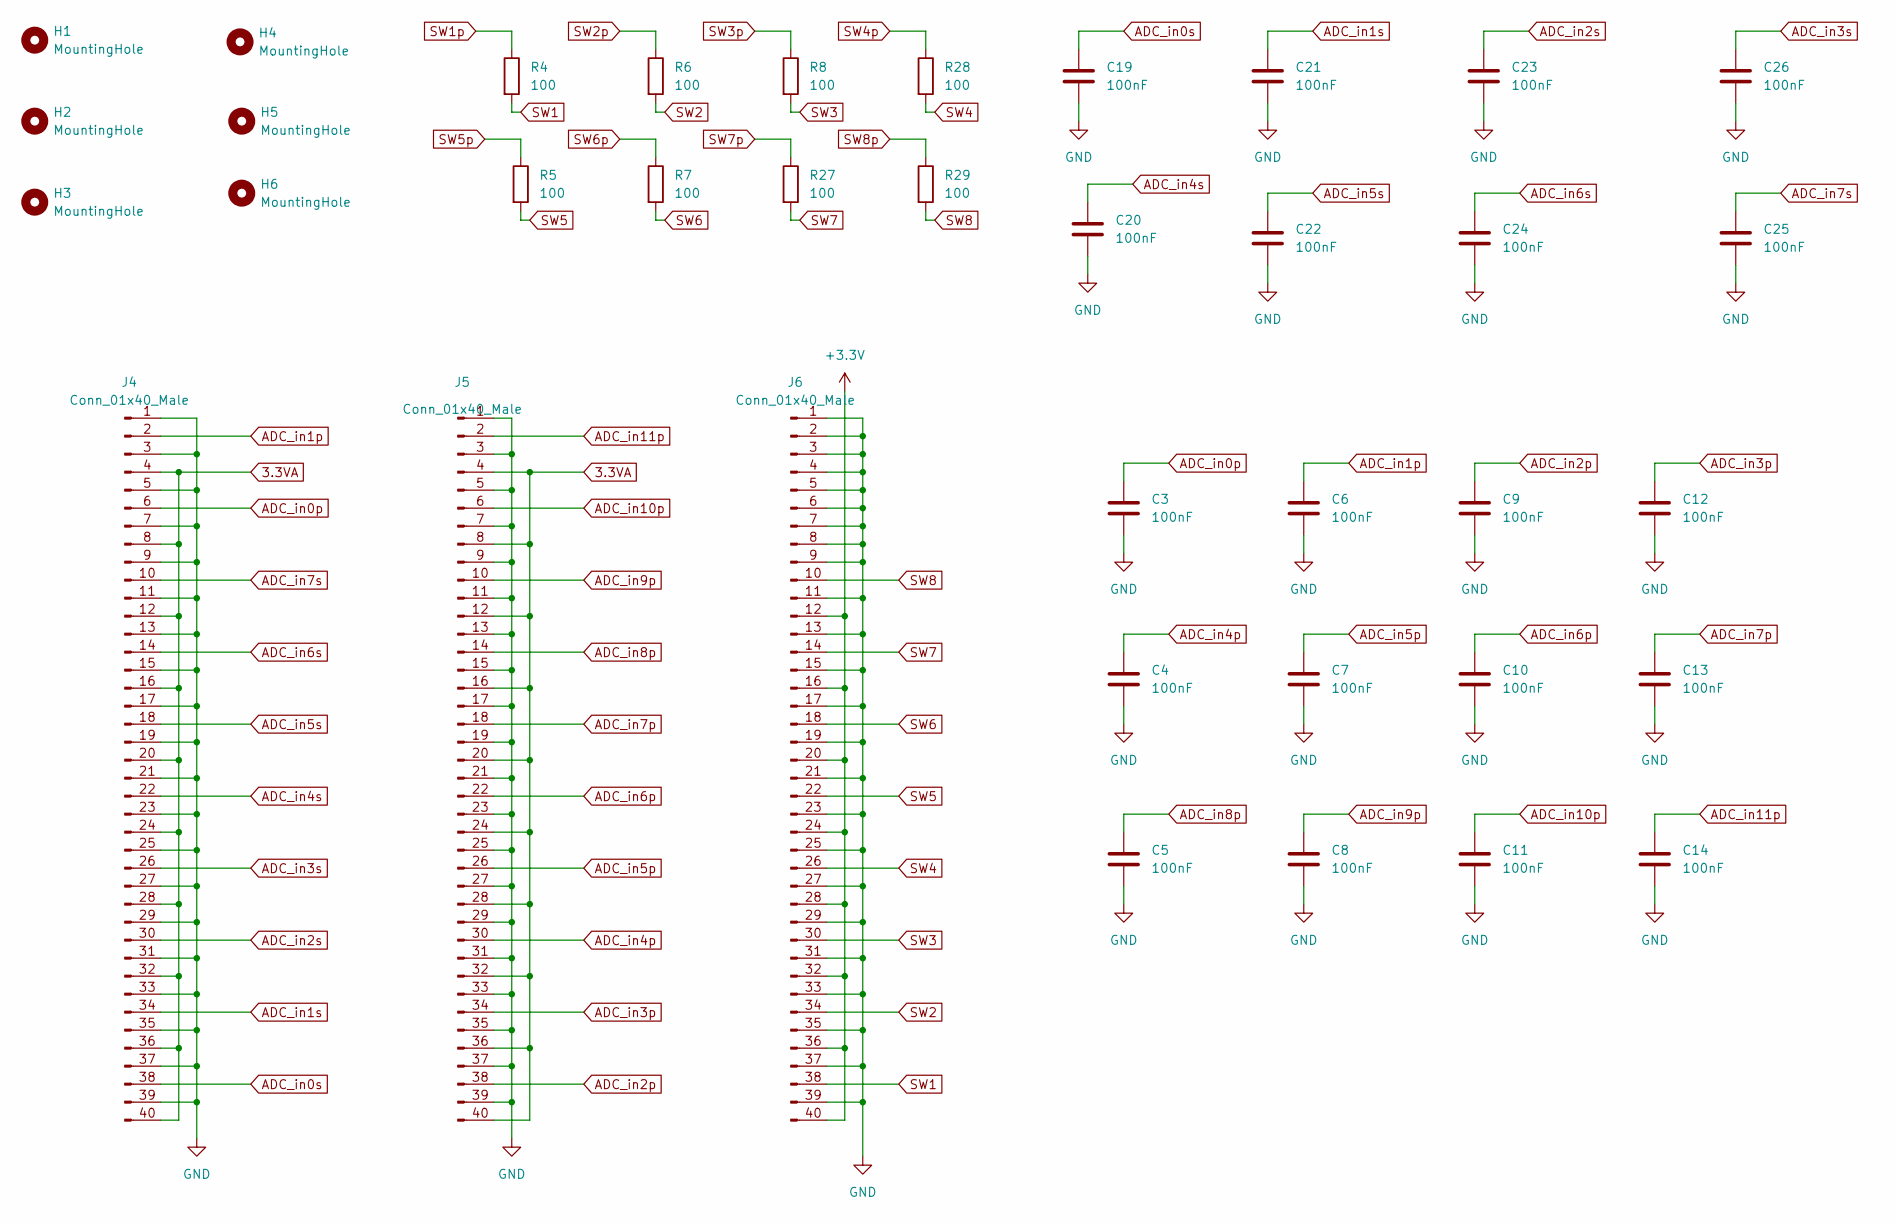
[picture p28: schematic slide_potentiometer.kicad_sch]

Parts:
C3, C4, C5, C6, C7, C8, C9, C10, C11, C12, C13, C14, C19, C20, C21, C22, C23, C24, C25, C26: 100nF; C_0805_2012Metric_Pad1.18x1.45mm_HandSolder
H1, H2, H3, H4, H5, H6: MountingHole; MountingHole_3.2mm_M3_Pad_Via
J4, J5, J6: Conn_01x40_Male; IDC-Header_2x20_P2.54mm_Vertical
R4, R5, R6, R7, R8, R27, R28, R29: 100; R_0805_2012Metric_Pad1.20x1.40mm_HandSolder

Connections:
3.3VA: J4.4, J4.8, J4.12, J4.16, J4.20, J4.24, J4.28, J4.32, J4.36, J4.40, J5.4, J5.8, J5.12, J5.16, J5.20, J5.24, J5.28, J5.32, J5.36, J5.40; also elsewhere on the board
+3V3: J6.12, J6.16, J6.20, J6.24, J6.28, J6.32, J6.36, J6.40; also elsewhere on the board
ADC_in0p: C3.1, J4.6; also elsewhere on the board
ADC_in0s: C19.1, J4.38; also elsewhere on the board
ADC_in1p: C6.1, J4.2; also elsewhere on the board
ADC_in1s: C21.1, J4.34; also elsewhere on the board
ADC_in2p: C9.1, J5.38; also elsewhere on the board
ADC_in2s: C23.1, J4.30; also elsewhere on the board
ADC_in3p: C12.1, J5.34; also elsewhere on the board
ADC_in3s: C26.1, J4.26; also elsewhere on the board
ADC_in4p: C4.1, J5.30; also elsewhere on the board
ADC_in4s: C20.1, J4.22; also elsewhere on the board
ADC_in5p: C7.1, J5.26; also elsewhere on the board
ADC_in5s: C22.1, J4.18; also elsewhere on the board
ADC_in6p: C10.1, J5.22; also elsewhere on the board
ADC_in6s: C24.1, J4.14; also elsewhere on the board
ADC_in7p: C13.1, J5.18; also elsewhere on the board
ADC_in7s: C25.1, J4.10; also elsewhere on the board
ADC_in8p: C5.1, J5.14; also elsewhere on the board
ADC_in9p: C8.1, J5.10; also elsewhere on the board
ADC_in10p: C11.1, J5.6; also elsewhere on the board
ADC_in11p: C14.1, J5.2; also elsewhere on the board
GND: C3.2, C4.2, C5.2, C6.2, C7.2, C8.2, C9.2, C10.2, C11.2, C12.2, C13.2, C14.2, C19.2, C20.2, C21.2, C22.2, C23.2, C24.2, C25.2, C26.2, J4.1, J4.3, J4.5, J4.7, J4.9, J4.11, J4.13, J4.15, J4.17, J4.19, J4.21, J4.23, J4.25, J4.27, J4.29, J4.31, J4.33, J4.35, J4.37, J4.39, J5.1, J5.3, J5.5, J5.7, J5.9, J5.11, J5.13, J5.15, J5.17, J5.19, J5.21, J5.23, J5.25, J5.27, J5.29, J5.31, J5.33, J5.35, J5.37, J5.39, J6.1, J6.2, J6.3, J6.4, J6.5, J6.6, J6.7, J6.8, J6.9, J6.11, J6.13, J6.15, J6.17, J6.19, J6.21, J6.23, J6.25, J6.27, J6.29, J6.31, J6.33, J6.35, J6.37, J6.39; also elsewhere on the board
SW1: J6.38, R4.2
SW1p: R4.1; also elsewhere on the board
SW2: J6.34, R6.2
SW2p: R6.1; also elsewhere on the board
SW3: J6.30, R8.2
SW3p: R8.1; also elsewhere on the board
SW4: J6.26, R28.2
SW4p: R28.1; also elsewhere on the board
SW5: J6.22, R5.2
SW5p: R5.1; also elsewhere on the board
SW6: J6.18, R7.2
SW6p: R7.1; also elsewhere on the board
SW7: J6.14, R27.2
SW7p: R27.1; also elsewhere on the board
SW8: J6.10, R29.2
SW8p: R29.1; also elsewhere on the board

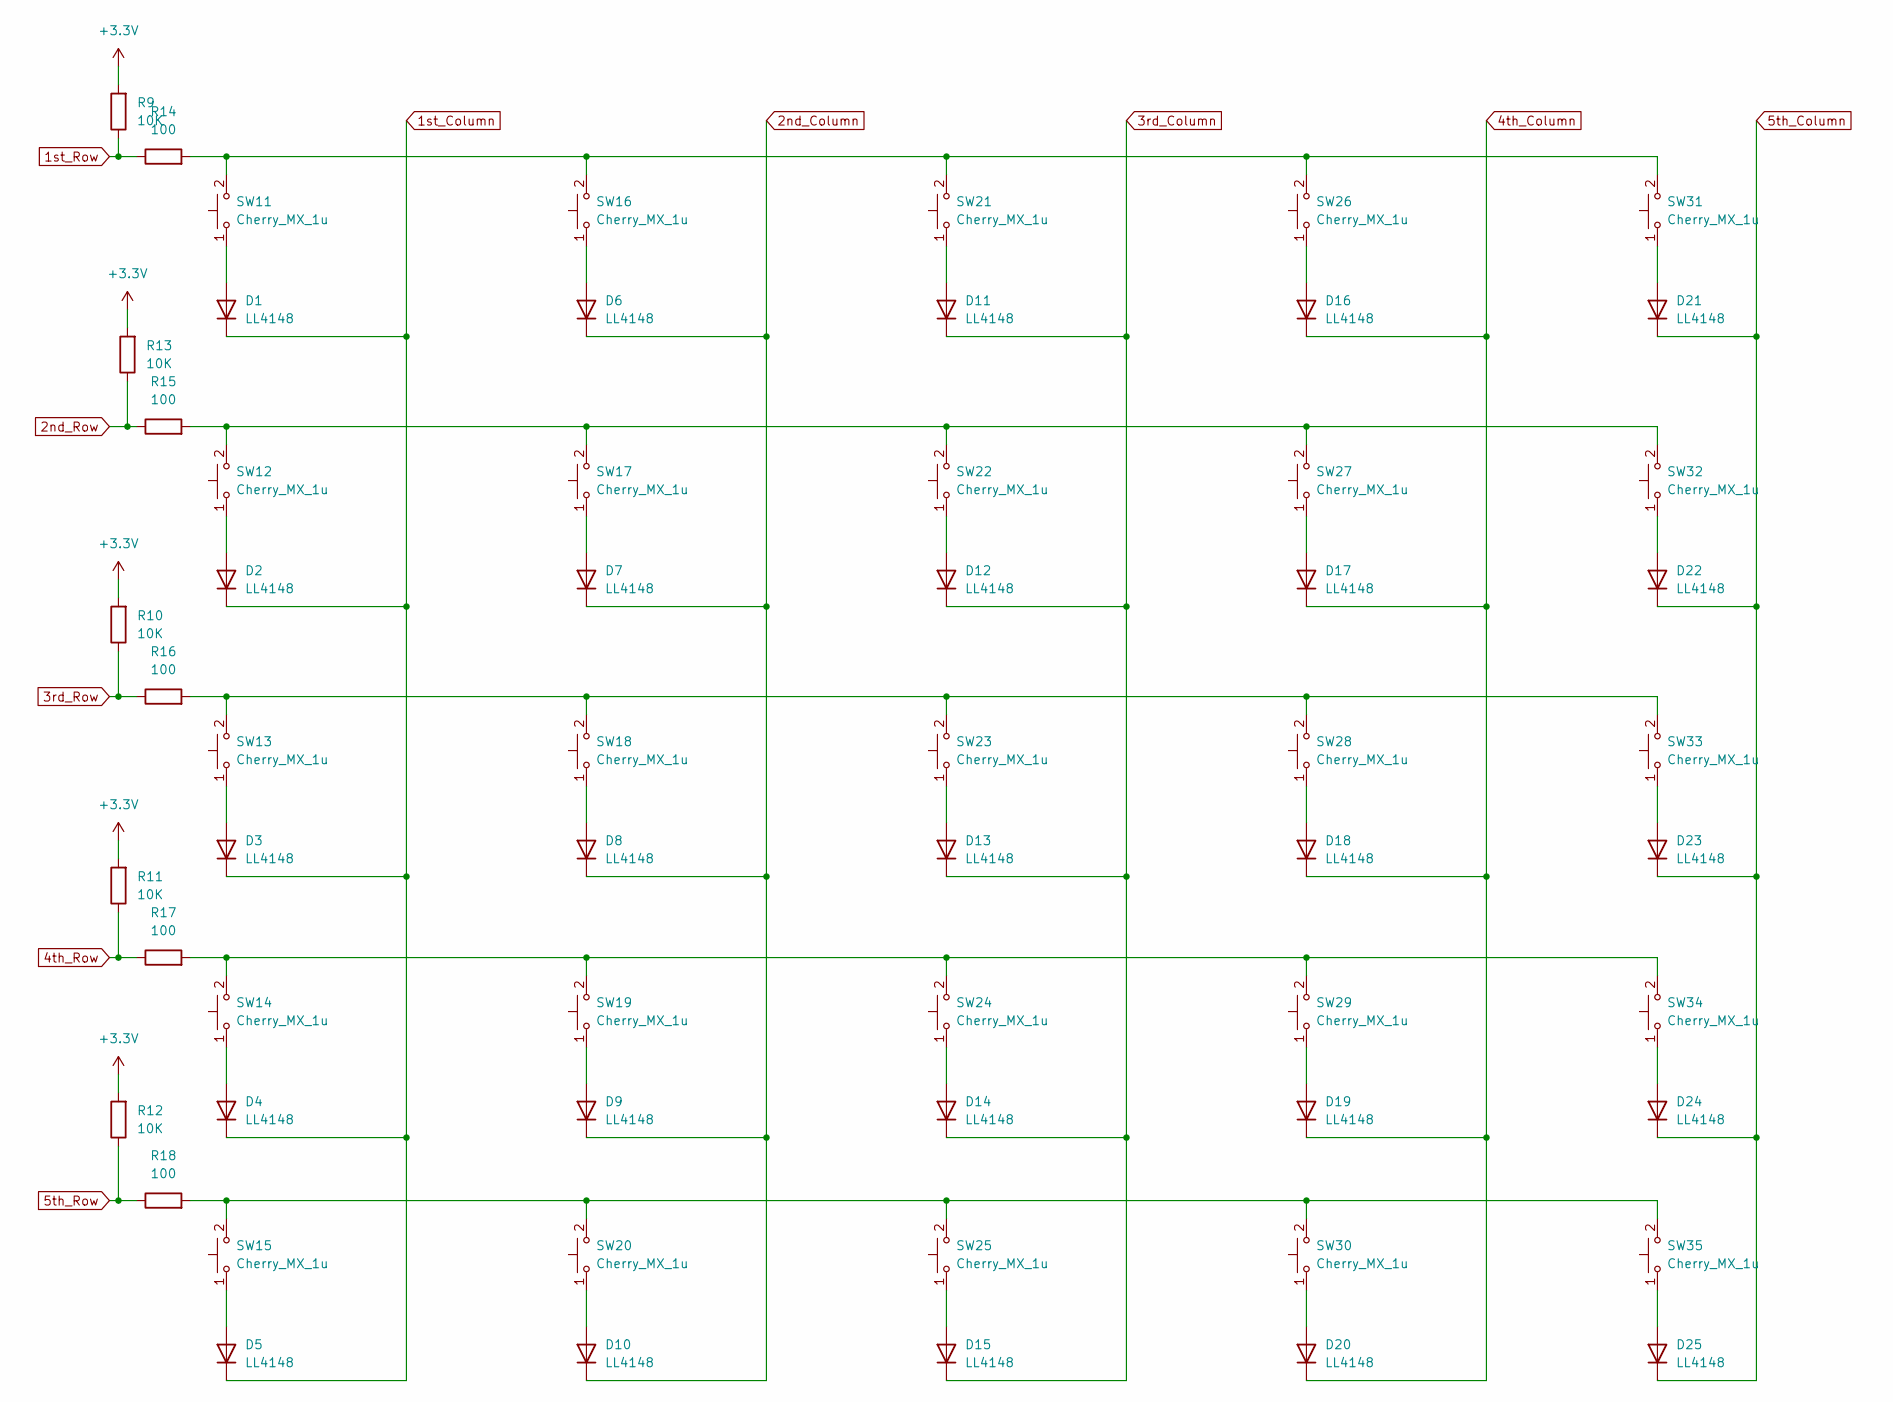
[picture p29: schematic synth_keys.kicad_sch]

Parts:
D1, D2, D3, D4, D5, D6, D7, D8, D9, D10, D11, D12, D13, D14, D15, D16, D17, D18, D19, D20, D21, D22, D23, D24, D25: LL4148; D_MiniMELF
R9, R10, R11, R12, R13: 10K; R_0805_2012Metric_Pad1.20x1.40mm_HandSolder
R14, R15, R16, R17, R18: 100; R_0805_2012Metric_Pad1.20x1.40mm_HandSolder
SW11, SW12, SW13, SW14, SW15, SW16, SW17, SW18, SW19, SW20, SW21, SW22, SW23, SW24, SW25, SW26, SW27, SW28, SW29, SW30, SW31, SW32, SW33, SW34, SW35: Cherry_MX_1u; SW_Cherry_MX_PCB_1.00u

Connections:
1st_Column: D1.1 (K), D2.1 (K), D3.1 (K), D4.1 (K), D5.1 (K); also elsewhere on the board
1st_Row: R9.1, R14.1; also elsewhere on the board
2nd_Column: D6.1 (K), D7.1 (K), D8.1 (K), D9.1 (K), D10.1 (K); also elsewhere on the board
2nd_Row: R13.1, R15.1; also elsewhere on the board
3rd_Column: D11.1 (K), D12.1 (K), D13.1 (K), D14.1 (K), D15.1 (K); also elsewhere on the board
3rd_Row: R10.1, R16.1; also elsewhere on the board
4th_Column: D16.1 (K), D17.1 (K), D18.1 (K), D19.1 (K), D20.1 (K); also elsewhere on the board
4th_Row: R11.1, R17.1; also elsewhere on the board
5th_Column: D21.1 (K), D22.1 (K), D23.1 (K), D24.1 (K), D25.1 (K); also elsewhere on the board
5th_Row: R12.1, R18.1; also elsewhere on the board
+3V3: R9.2, R10.2, R11.2, R12.2, R13.2; also elsewhere on the board
unnamed: D1.2 (A), SW11.1
unnamed: D2.2 (A), SW12.1
unnamed: D3.2 (A), SW13.1
unnamed: D4.2 (A), SW14.1
unnamed: D5.2 (A), SW15.1
unnamed: D6.2 (A), SW16.1
unnamed: D7.2 (A), SW17.1
unnamed: D8.2 (A), SW18.1
unnamed: D9.2 (A), SW19.1
unnamed: D10.2 (A), SW20.1
unnamed: D11.2 (A), SW21.1
unnamed: D12.2 (A), SW22.1
unnamed: D13.2 (A), SW23.1
unnamed: D14.2 (A), SW24.1
unnamed: D15.2 (A), SW25.1
unnamed: D16.2 (A), SW26.1
unnamed: D17.2 (A), SW27.1
unnamed: D18.2 (A), SW28.1
unnamed: D19.2 (A), SW29.1
unnamed: D20.2 (A), SW30.1
unnamed: D21.2 (A), SW31.1
unnamed: D22.2 (A), SW32.1
unnamed: D23.2 (A), SW33.1
unnamed: D24.2 (A), SW34.1
unnamed: D25.2 (A), SW35.1
unnamed: R14.2, SW11.2, SW16.2, SW21.2, SW26.2, SW31.2
unnamed: R15.2, SW12.2, SW17.2, SW22.2, SW27.2, SW32.2
unnamed: R16.2, SW13.2, SW18.2, SW23.2, SW28.2, SW33.2
unnamed: R17.2, SW14.2, SW19.2, SW24.2, SW29.2, SW34.2
unnamed: R18.2, SW15.2, SW20.2, SW25.2, SW30.2, SW35.2

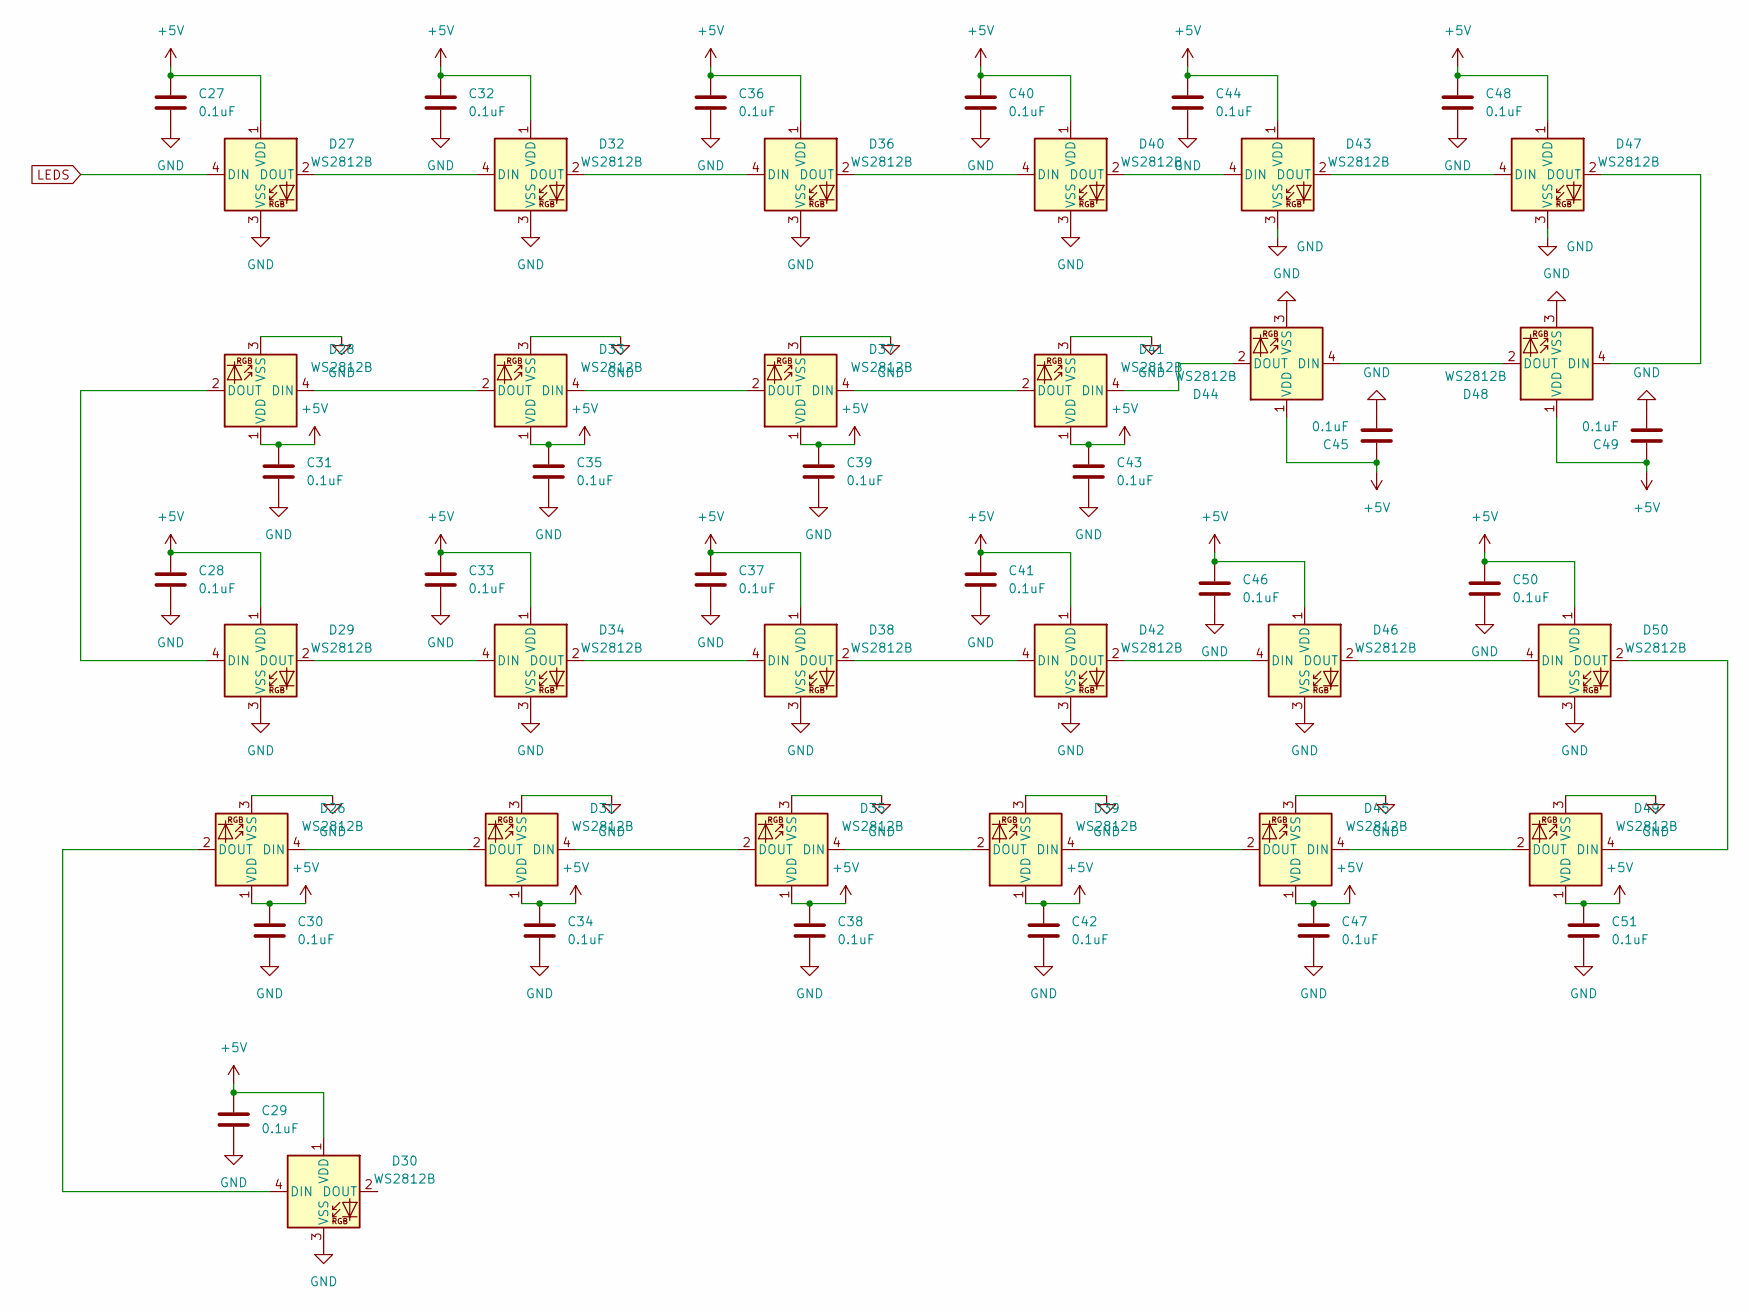
[picture p30: schematic LEDS_WS2812B.kicad_sch]

Parts:
C27, C28, C29, C30, C31, C32, C33, C34, C35, C36, C37, C38, C39, C40, C41, C42, C43, C44, C45, C46, C47, C48, C49, C50, C51: 0.1uF; C_0805_2012Metric_Pad1.18x1.45mm_HandSolder
D26, D27, D28, D29, D30, D31, D32, D33, D34, D35, D36, D37, D38, D39, D40, D41, D42, D43, D44, D45, D46, D47, D48, D49, D50: WS2812B; LED_WS2812B_PLCC4_5.0x5.0mm_P3.2mm

Connections:
+5V: C27.1, C28.1, C29.1, C30.1, C31.1, C32.1, C33.1, C34.1, C35.1, C36.1, C37.1, C38.1, C39.1, C40.1, C41.1, C42.1, C43.1, C44.1, C45.1, C46.1, C47.1, C48.1, C49.1, C50.1, C51.1, D26.1 (VDD), D27.1 (VDD), D28.1 (VDD), D29.1 (VDD), D30.1 (VDD), D31.1 (VDD), D32.1 (VDD), D33.1 (VDD), D34.1 (VDD), D35.1 (VDD), D36.1 (VDD), D37.1 (VDD), D38.1 (VDD), D39.1 (VDD), D40.1 (VDD), D41.1 (VDD), D42.1 (VDD), D43.1 (VDD), D44.1 (VDD), D45.1 (VDD), D46.1 (VDD), D47.1 (VDD), D48.1 (VDD), D49.1 (VDD), D50.1 (VDD); also elsewhere on the board
GND: C27.2, C28.2, C29.2, C30.2, C31.2, C32.2, C33.2, C34.2, C35.2, C36.2, C37.2, C38.2, C39.2, C40.2, C41.2, C42.2, C43.2, C44.2, C45.2, C46.2, C47.2, C48.2, C49.2, C50.2, C51.2, D26.3 (VSS), D27.3 (VSS), D28.3 (VSS), D29.3 (VSS), D30.3 (VSS), D31.3 (VSS), D32.3 (VSS), D33.3 (VSS), D34.3 (VSS), D35.3 (VSS), D36.3 (VSS), D37.3 (VSS), D38.3 (VSS), D39.3 (VSS), D40.3 (VSS), D41.3 (VSS), D42.3 (VSS), D43.3 (VSS), D44.3 (VSS), D45.3 (VSS), D46.3 (VSS), D47.3 (VSS), D48.3 (VSS), D49.3 (VSS), D50.3 (VSS); also elsewhere on the board
LEDS: D27.4 (DIN); also elsewhere on the board
unnamed: D26.2 (DOUT), D30.4 (DIN)
unnamed: D26.4 (DIN), D31.2 (DOUT)
unnamed: D27.2 (DOUT), D32.4 (DIN)
unnamed: D28.2 (DOUT), D29.4 (DIN)
unnamed: D28.4 (DIN), D33.2 (DOUT)
unnamed: D29.2 (DOUT), D34.4 (DIN)
unnamed: D31.4 (DIN), D35.2 (DOUT)
unnamed: D32.2 (DOUT), D36.4 (DIN)
unnamed: D33.4 (DIN), D37.2 (DOUT)
unnamed: D34.2 (DOUT), D38.4 (DIN)
unnamed: D35.4 (DIN), D39.2 (DOUT)
unnamed: D36.2 (DOUT), D40.4 (DIN)
unnamed: D37.4 (DIN), D41.2 (DOUT)
unnamed: D38.2 (DOUT), D42.4 (DIN)
unnamed: D39.4 (DIN), D45.2 (DOUT)
unnamed: D40.2 (DOUT), D43.4 (DIN)
unnamed: D41.4 (DIN), D44.2 (DOUT)
unnamed: D42.2 (DOUT), D46.4 (DIN)
unnamed: D43.2 (DOUT), D47.4 (DIN)
unnamed: D44.4 (DIN), D48.2 (DOUT)
unnamed: D45.4 (DIN), D49.2 (DOUT)
unnamed: D46.2 (DOUT), D50.4 (DIN)
unnamed: D47.2 (DOUT), D48.4 (DIN)
unnamed: D49.4 (DIN), D50.2 (DOUT)

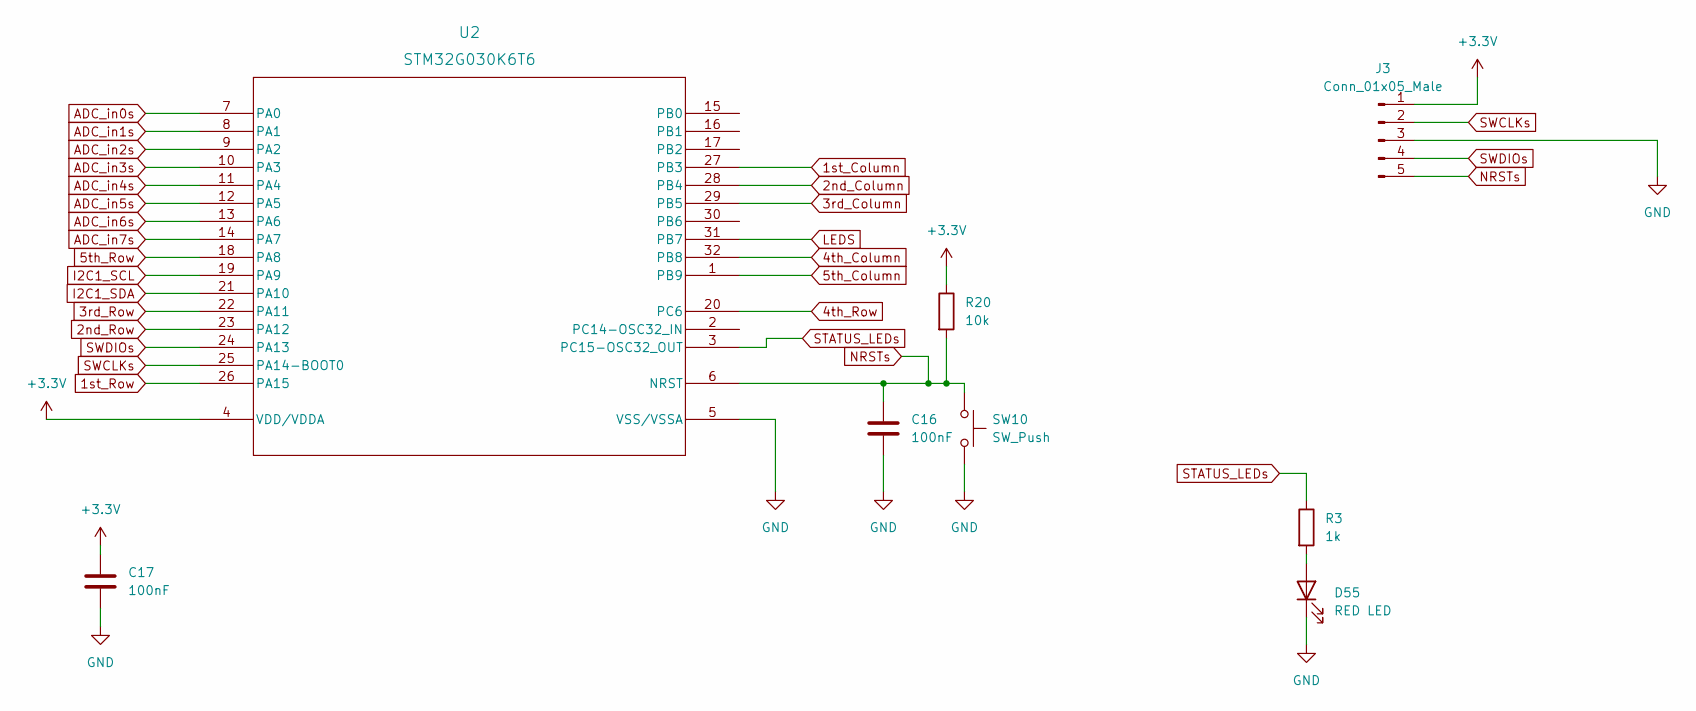
[picture p31: schematic slidepot_stm32g030k6t6.kicad_sch]

Parts:
C16, C17: 100nF; C_0805_2012Metric_Pad1.18x1.45mm_HandSolder
D55: RED LED; LED_0805_2012Metric_Pad1.15x1.40mm_HandSolder
J3: Conn_01x05_Male; PinSocket_1x05_P2.54mm_Horizontal
R3: 1k; R_0805_2012Metric_Pad1.20x1.40mm_HandSolder
R20: 10k; R_0805_2012Metric_Pad1.20x1.40mm_HandSolder
SW10: SW_Push; ROCPU Switches TP10721645
U2: STM32G030K6T6; LQFP-32

Connections:
1st_Column: U2.27 (PB3); also elsewhere on the board
1st_Row: U2.26 (PA15); also elsewhere on the board
2nd_Column: U2.28 (PB4); also elsewhere on the board
2nd_Row: U2.23 (PA12); also elsewhere on the board
3rd_Column: U2.29 (PB5); also elsewhere on the board
3rd_Row: U2.22 (PA11); also elsewhere on the board
4th_Column: U2.32 (PB8); also elsewhere on the board
4th_Row: U2.20 (PC6); also elsewhere on the board
5th_Column: U2.1 (PB9); also elsewhere on the board
5th_Row: U2.18 (PA8); also elsewhere on the board
+3V3: C17.1, J3.1, R20.1, U2.4 (VDD/VDDA); also elsewhere on the board
ADC_in0s: U2.7 (PA0); also elsewhere on the board
ADC_in1s: U2.8 (PA1); also elsewhere on the board
ADC_in2s: U2.9 (PA2); also elsewhere on the board
ADC_in3s: U2.10 (PA3); also elsewhere on the board
ADC_in4s: U2.11 (PA4); also elsewhere on the board
ADC_in5s: U2.12 (PA5); also elsewhere on the board
ADC_in6s: U2.13 (PA6); also elsewhere on the board
ADC_in7s: U2.14 (PA7); also elsewhere on the board
GND: C16.2, C17.2, D55.1 (K), J3.3, SW10.2, U2.5 (VSS/VSSA); also elsewhere on the board
I2C1_SCL: U2.19 (PA9); also elsewhere on the board
I2C1_SDA: U2.21 (PA10); also elsewhere on the board
LEDS: U2.31 (PB7); also elsewhere on the board
NRSTs: C16.1, J3.5, R20.2, SW10.1, U2.6 (NRST)
unnamed: D55.2 (A), R3.2
STATUS_LEDs: R3.1, U2.3 (PC15-OSC32_OUT)
SWCLKs: J3.2, U2.25 (PA14-BOOT0)
SWDIOs: J3.4, U2.24 (PA13)

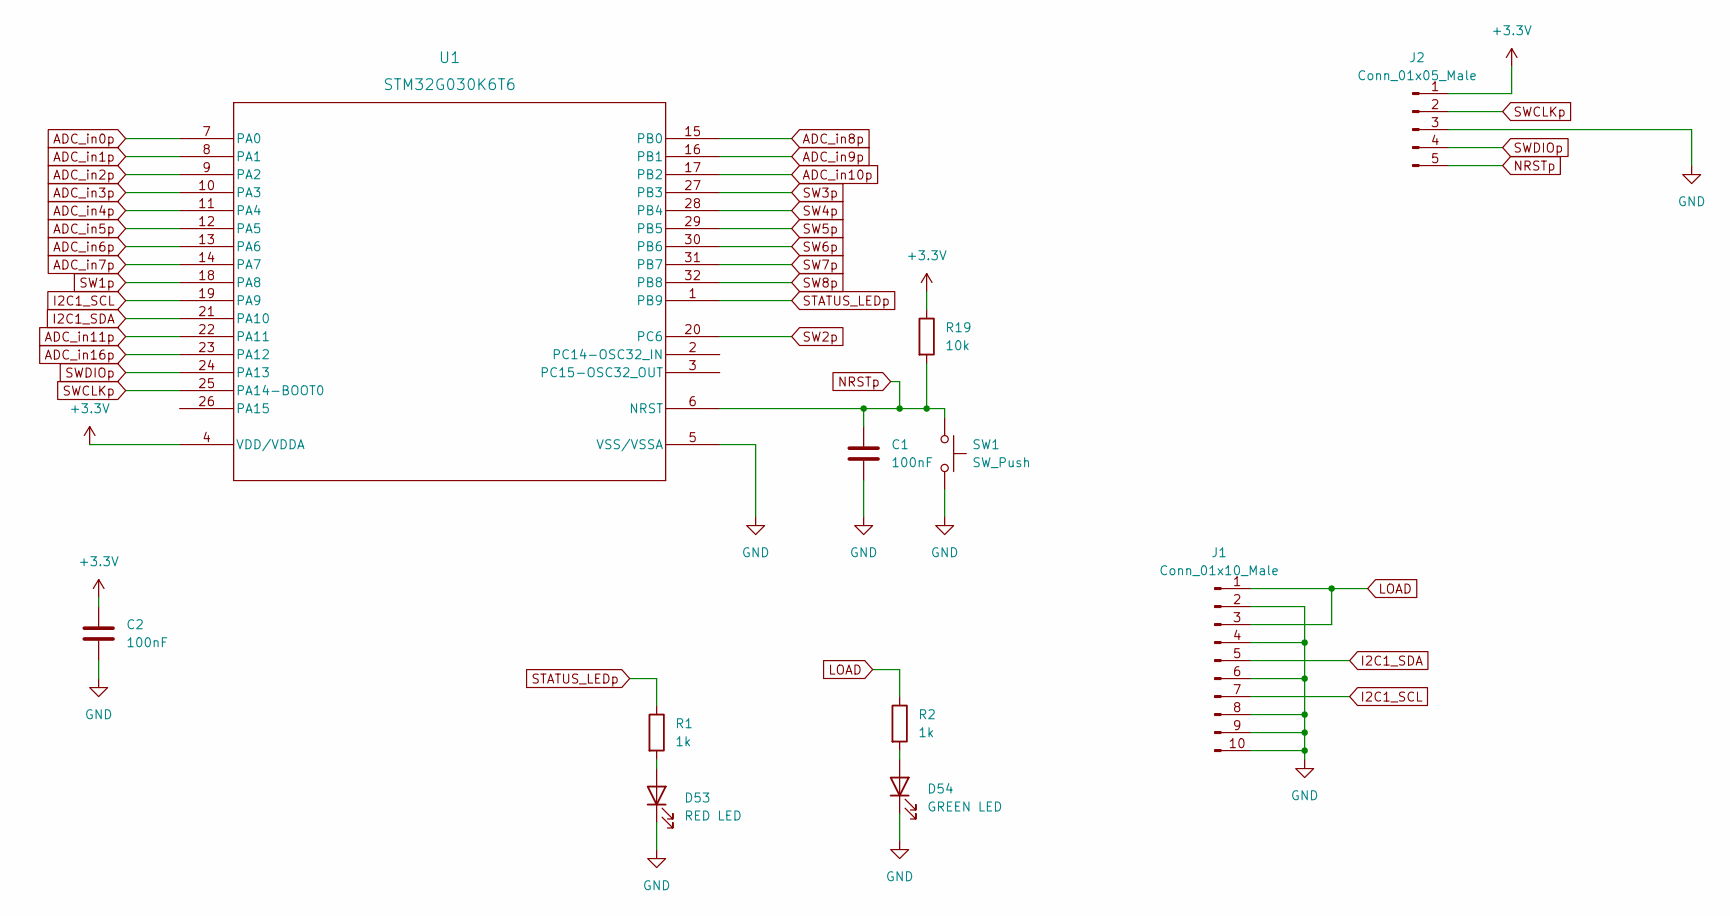
[picture p32: schematic plugpot_stm32g030k6t6.kicad_sch]

Parts:
C1, C2: 100nF; C_0805_2012Metric_Pad1.18x1.45mm_HandSolder
D53: RED LED; LED_0805_2012Metric_Pad1.15x1.40mm_HandSolder
D54: GREEN LED; LED_0805_2012Metric_Pad1.15x1.40mm_HandSolder
J1: Conn_01x10_Male; IDC-Header_2x05_P2.54mm_Horizontal
J2: Conn_01x05_Male; PinSocket_1x05_P2.54mm_Horizontal
R1, R2: 1k; R_0805_2012Metric_Pad1.20x1.40mm_HandSolder
R19: 10k; R_0805_2012Metric_Pad1.20x1.40mm_HandSolder
SW1: SW_Push; ROCPU Switches TP10721645
U1: STM32G030K6T6; LQFP-32

Connections:
+3V3: C2.1, J2.1, R19.1, U1.4 (VDD/VDDA); also elsewhere on the board
ADC_in0p: U1.7 (PA0); also elsewhere on the board
ADC_in1p: U1.8 (PA1); also elsewhere on the board
ADC_in2p: U1.9 (PA2); also elsewhere on the board
ADC_in3p: U1.10 (PA3); also elsewhere on the board
ADC_in4p: U1.11 (PA4); also elsewhere on the board
ADC_in5p: U1.12 (PA5); also elsewhere on the board
ADC_in6p: U1.13 (PA6); also elsewhere on the board
ADC_in7p: U1.14 (PA7); also elsewhere on the board
ADC_in8p: U1.15 (PB0); also elsewhere on the board
ADC_in9p: U1.16 (PB1); also elsewhere on the board
ADC_in10p: U1.17 (PB2); also elsewhere on the board
ADC_in11p: U1.22 (PA11); also elsewhere on the board
ADC_in16p: U1.23 (PA12)
GND: C1.2, C2.2, D53.1 (K), D54.1 (K), J1.2, J1.4, J1.6, J1.8, J1.9, J1.10, J2.3, SW1.2, U1.5 (VSS/VSSA); also elsewhere on the board
I2C1_SCL: J1.7, U1.19 (PA9); also elsewhere on the board
I2C1_SDA: J1.5, U1.21 (PA10); also elsewhere on the board
LOAD: J1.1, J1.3, R2.1; also elsewhere on the board
NRSTp: C1.1, J2.5, R19.2, SW1.1, U1.6 (NRST)
unnamed: D53.2 (A), R1.2
unnamed: D54.2 (A), R2.2
STATUS_LEDp: R1.1, U1.1 (PB9)
SW1p: U1.18 (PA8); also elsewhere on the board
SW2p: U1.20 (PC6); also elsewhere on the board
SW3p: U1.27 (PB3); also elsewhere on the board
SW4p: U1.28 (PB4); also elsewhere on the board
SW5p: U1.29 (PB5); also elsewhere on the board
SW6p: U1.30 (PB6); also elsewhere on the board
SW7p: U1.31 (PB7); also elsewhere on the board
SW8p: U1.32 (PB8); also elsewhere on the board
SWCLKp: J2.2, U1.25 (PA14-BOOT0)
SWDIOp: J2.4, U1.24 (PA13)

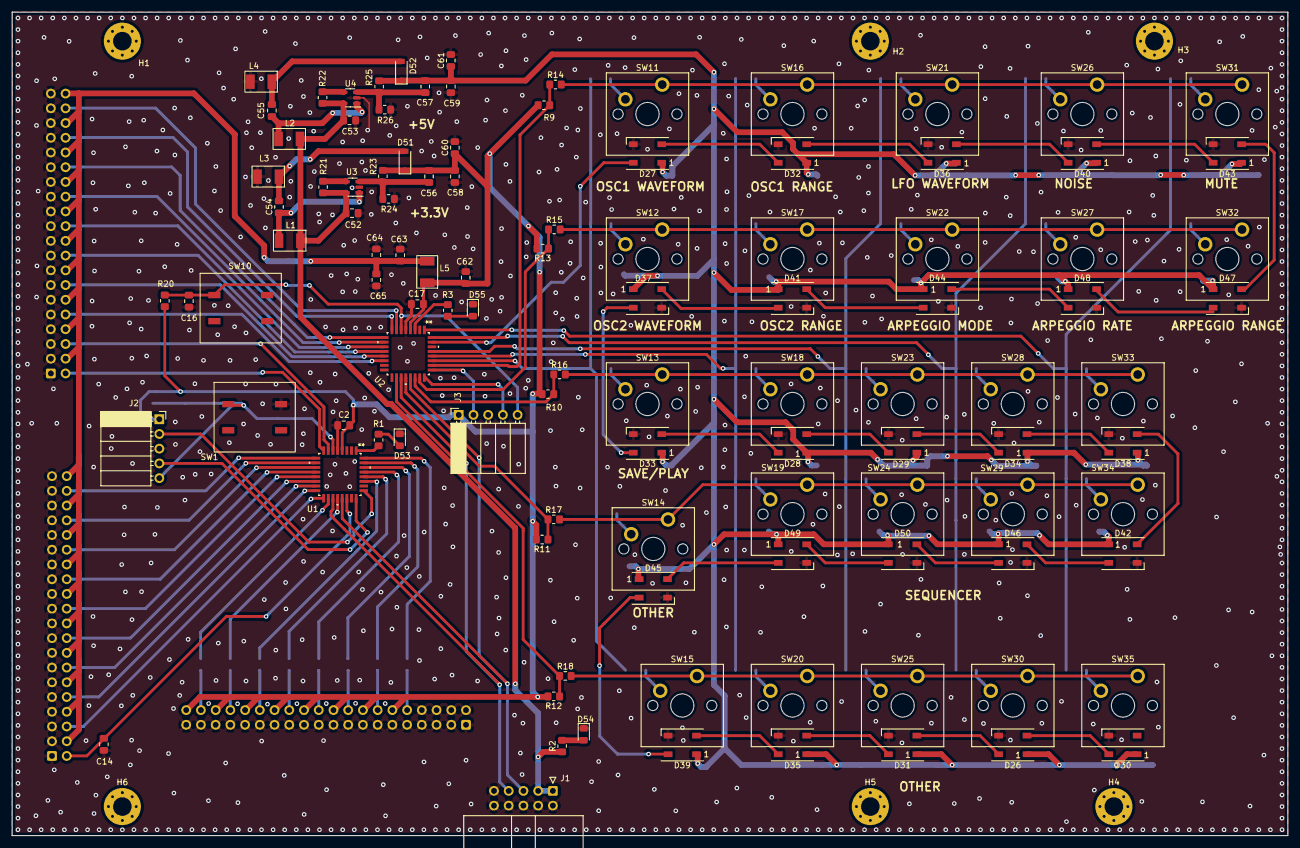
[picture p33: board Pot.butt_pcb.kicad_pcb from above]

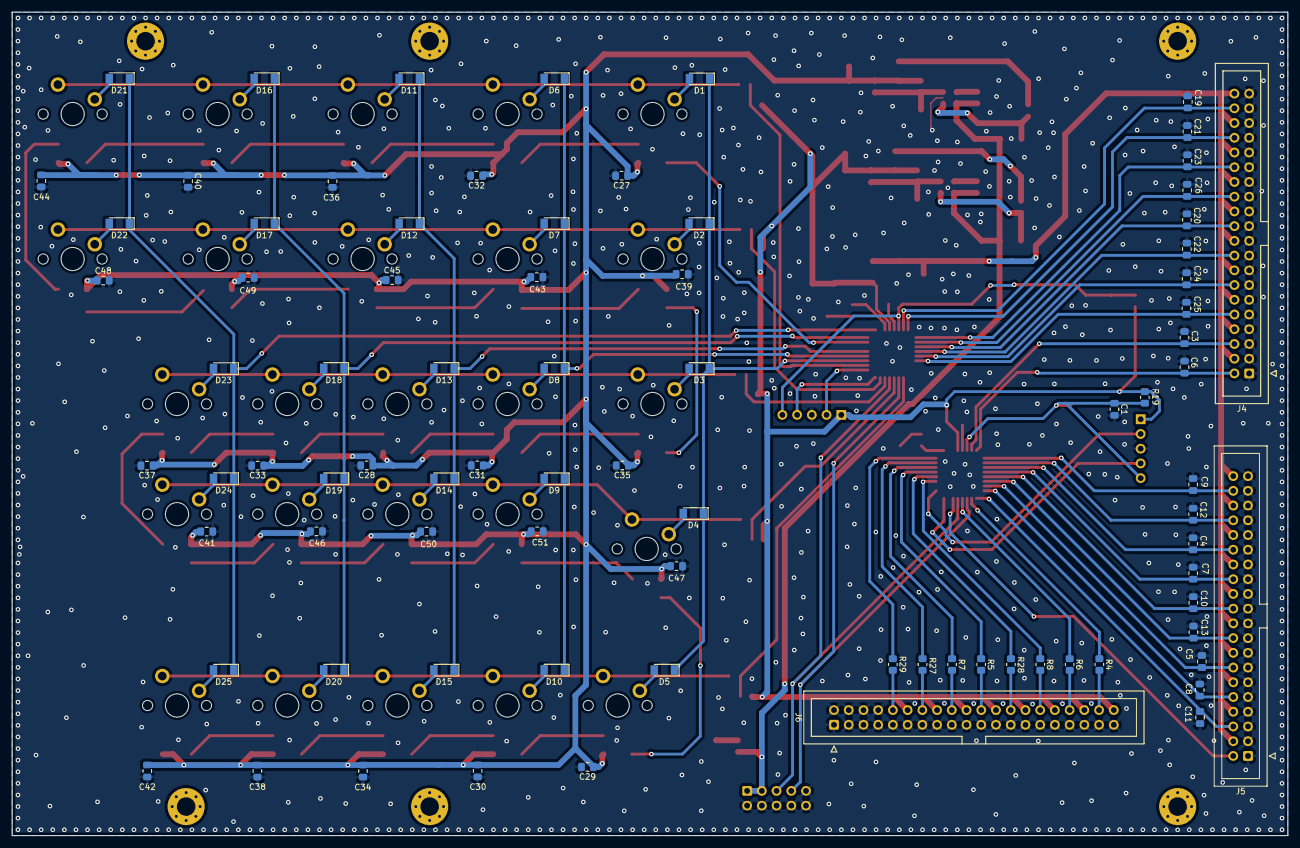
[picture p34: board Pot.butt_pcb.kicad_pcb from below]

Board: 2 copper layers, 220.0 x 142.0 mm, 195 parts (82 on the bottom side), 127 nets.
