torok-samuel/Digital-synthesizer-project/main_func/main_func/main_func.kicad_pcb

## KiCad design main_func/main_func/main_func.kicad_pcb (2023-05-13)

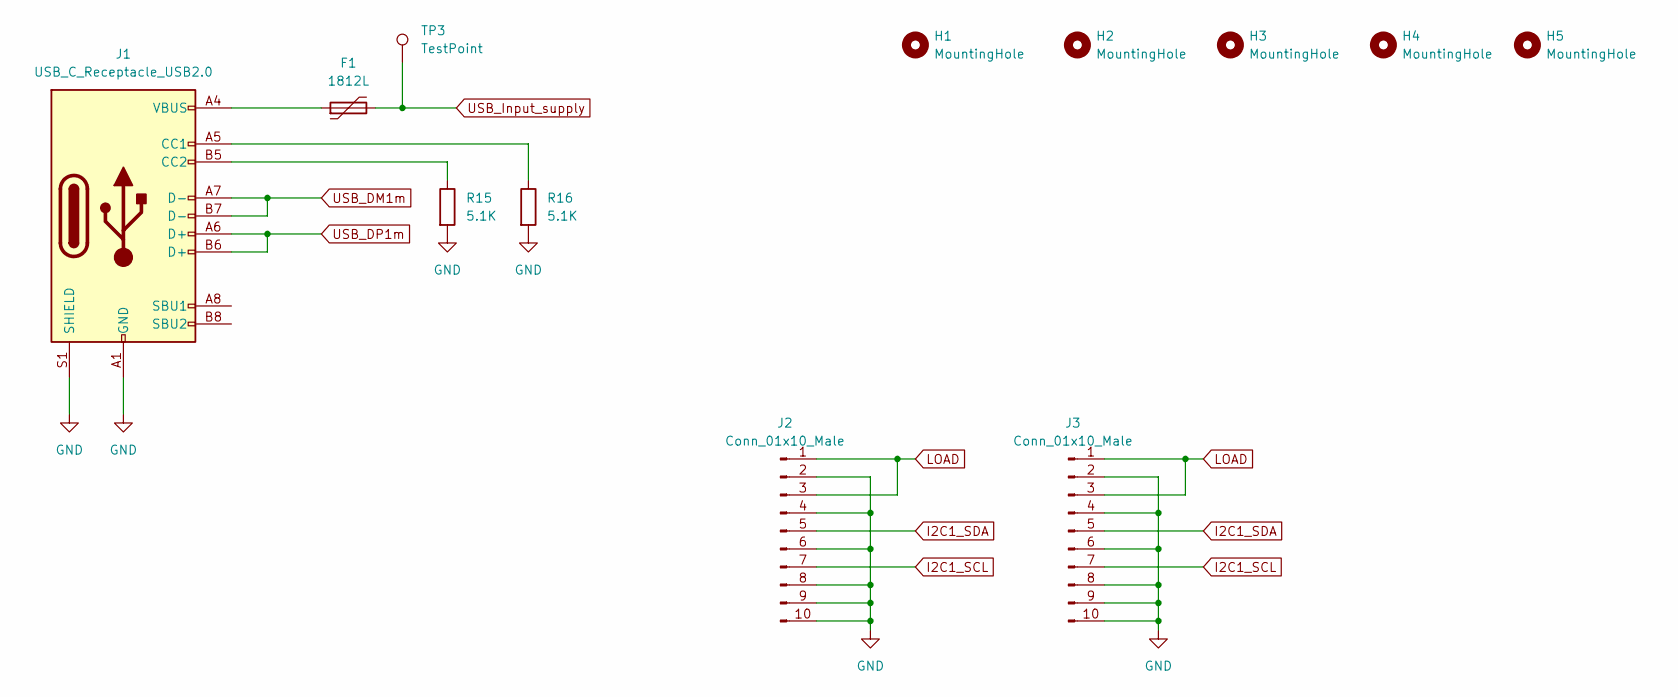
[picture p35: schematic usb_c.kicad_sch]

Parts:
F1: 1812L; FUSM4632X200N
H1, H2, H3, H4, H5: MountingHole; MountingHole_3.2mm_M3_Pad_Via
J1: USB_C_Receptacle_USB2.0; USB_C_Receptacle_HRO_TYPE-C-31-M-12
J2, J3: Conn_01x10_Male; IDC-Header_2x05_P2.54mm_Horizontal
R15, R16: 5.1K; R_0805_2012Metric_Pad1.20x1.40mm_HandSolder
TP3: TestPoint; TestPoint_Keystone_5010-5014_Multipurpose

Connections:
GND: J1.A1 (GND), J1.A12 (GND), J1.B1 (GND), J1.B12 (GND), J1.S1 (SHIELD), J2.2, J2.4, J2.6, J2.8, J2.9, J2.10, J3.2, J3.4, J3.6, J3.8, J3.9, J3.10, R15.2, R16.2; also elsewhere on the board
I2C1_SCL: J2.7, J3.7; also elsewhere on the board
I2C1_SDA: J2.5, J3.5; also elsewhere on the board
LOAD: J2.1, J2.3, J3.1, J3.3; also elsewhere on the board
unnamed: F1.1, J1.A4 (VBUS), J1.A9 (VBUS), J1.B4 (VBUS), J1.B9 (VBUS)
unnamed: J1.A5 (CC1), R16.1
unnamed: J1.B5 (CC2), R15.1
USB_DM1m: J1.A7 (D-), J1.B7 (D-); also elsewhere on the board
USB_DP1m: J1.A6 (D+), J1.B6 (D+); also elsewhere on the board
USB_Input_supply: F1.2, TP3.1; also elsewhere on the board

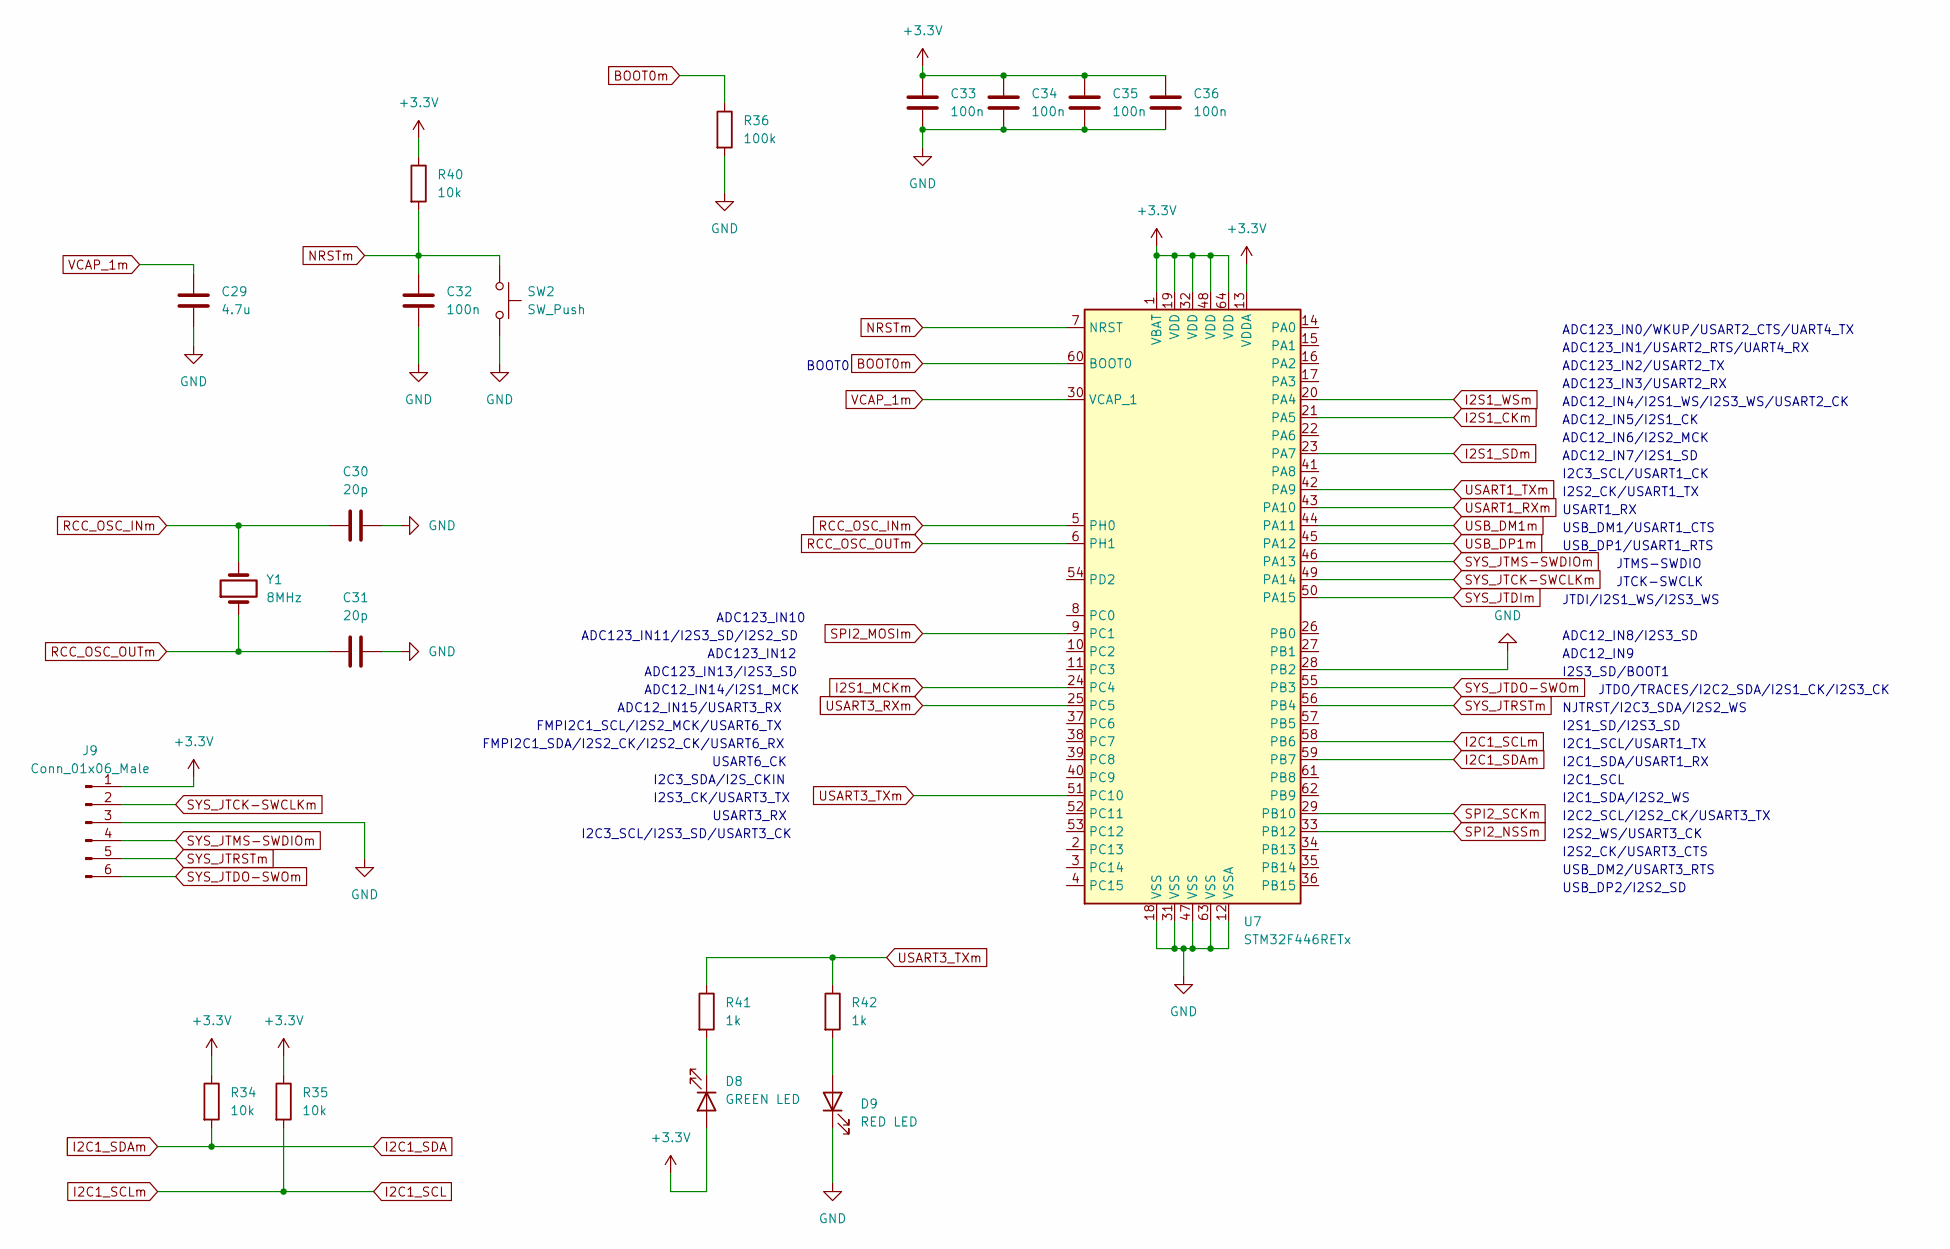
[picture p36: schematic stm32f446.kicad_sch]

Parts:
C29: 4.7u; C_0805_2012Metric_Pad1.18x1.45mm_HandSolder
C30, C31: 20p; C_0805_2012Metric_Pad1.18x1.45mm_HandSolder
C32, C33, C34, C35, C36: 100n; C_0805_2012Metric_Pad1.18x1.45mm_HandSolder
D8: GREEN LED; LED_0805_2012Metric_Pad1.15x1.40mm_HandSolder
D9: RED LED; LED_0805_2012Metric_Pad1.15x1.40mm_HandSolder
J9: Conn_01x06_Male; PinSocket_1x06_P2.54mm_Horizontal
R34, R35, R40: 10k; R_0805_2012Metric_Pad1.20x1.40mm_HandSolder
R36: 100k; R_0805_2012Metric_Pad1.20x1.40mm_HandSolder
R41, R42: 1k; R_0805_2012Metric_Pad1.20x1.40mm_HandSolder
SW2: SW_Push; ROCPU Switches TP10721645
U7: STM32F446RETx; LQFP-64_10x10mm_P0.5mm
Y1: 8MHz; Crystal_SMD_HC49-SD_HandSoldering

Connections:
+3V3: C33.1, C34.1, C35.1, C36.1, D8.2 (A), J9.1, R34.1, R35.1, R40.1, U7.1 (VBAT), U7.13 (VDDA), U7.19 (VDD), U7.32 (VDD), U7.48 (VDD), U7.64 (VDD); also elsewhere on the board
BCLKda: U7.21 (PA5); also elsewhere on the board
BOOT0m: R36.1, U7.60 (BOOT0)
DATAda: U7.23 (PA7); also elsewhere on the board
GND: C29.2, C30.2, C31.2, C32.2, C33.2, C34.2, C35.2, C36.2, D9.1 (K), J9.3, R36.2, SW2.2, U7.12 (VSSA), U7.18 (VSS), U7.28 (PB2), U7.31 (VSS), U7.47 (VSS), U7.63 (VSS); also elsewhere on the board
I2C1_SCL: R35.2, U7.58 (PB6); also elsewhere on the board
I2C1_SDA: R34.2, U7.59 (PB7); also elsewhere on the board
I2S1_MCKm: U7.24 (PC4); also elsewhere on the board
I2S1_WSm: U7.20 (PA4); also elsewhere on the board
MCda: U7.29 (PB10); also elsewhere on the board
MDda: U7.9 (PC1); also elsewhere on the board
MLda: U7.33 (PB12); also elsewhere on the board
NRSTm: C32.1, R40.2, SW2.1, U7.7 (NRST)
unnamed: D8.1 (K), R41.2
unnamed: D9.2 (A), R42.2
RCC_OSC_INm: C30.1, U7.5 (PH0), Y1.2
RCC_OSC_OUTm: C31.1, U7.6 (PH1), Y1.1
SYS_JTCK-SWCLKm: J9.2, U7.49 (PA14)
SYS_JTDIm: U7.50 (PA15)
SYS_JTDO-SWOm: J9.6, U7.55 (PB3)
SYS_JTMS-SWDIOm: J9.4, U7.46 (PA13)
SYS_JTRSTm: J9.5, U7.56 (PB4)
USART1_RXm: U7.43 (PA10); also elsewhere on the board
USART1_TXm: U7.42 (PA9); also elsewhere on the board
USART3_RXm: U7.25 (PC5)
USART3_TXm: R41.1, R42.1, U7.51 (PC10)
USB_DM1m: U7.44 (PA11); also elsewhere on the board
USB_DP1m: U7.45 (PA12); also elsewhere on the board
VCAP_1m: C29.1, U7.30 (VCAP_1)

Notes on the sheet:
ADC123_IN3/USART2_RX
I2S2_CK/USART3_CTS
FMPI2C1_SDA/I2S2_CK/I2S2_CK/USART6_RX
ADC12_IN4/I2S1_WS/I2S3_WS/USART2_CK
USB_DP2/I2S2_SD
I2C1_SCL
I2C1_SDA/USART1_RX
ADC12_IN7/I2S1_SD
ADC123_IN12
USART1_RX
FMPI2C1_SCL/I2S2_MCK/USART6_TX
I2C3_SDA/I2S_CKIN
I2C1_SCL/USART1_TX
USART6_CK
ADC123_IN0/WKUP/USART2_CTS/UART4_TX
I2S2_WS/USART3_CK
JTCK-SWCLK
JTMS-SWDIO
I2C3_SCL/USART1_CK
ADC123_IN10
NJTRST/I2C3_SDA/I2S2_WS
ADC123_IN2/USART2_TX
USB_DM1/USART1_CTS
I2C1_SDA/I2S2_WS
BOOT0
USART3_RX
ADC12_IN5/I2S1_CK
ADC12_IN14/I2S1_MCK
ADC123_IN13/I2S3_SD
ADC12_IN15/USART3_RX
I2C3_SCL/I2S3_SD/USART3_CK
ADC12_IN8/I2S3_SD
I2C2_SCL/I2S2_CK/USART3_TX
USB_DM2/USART3_RTS
ADC12_IN9
I2S3_CK/USART3_TX
ADC123_IN1/USART2_RTS/UART4_RX
JTDO/TRACES/I2C2_SDA/I2S1_CK/I2S3_CK
I2S1_SD/I2S3_SD
I2S3_SD/BOOT1
JTDI/I2S1_WS/I2S3_WS
USB_DP1/USART1_RTS
ADC12_IN6/I2S2_MCK
I2S2_CK/USART1_TX
ADC123_IN11/I2S3_SD/I2S2_SD

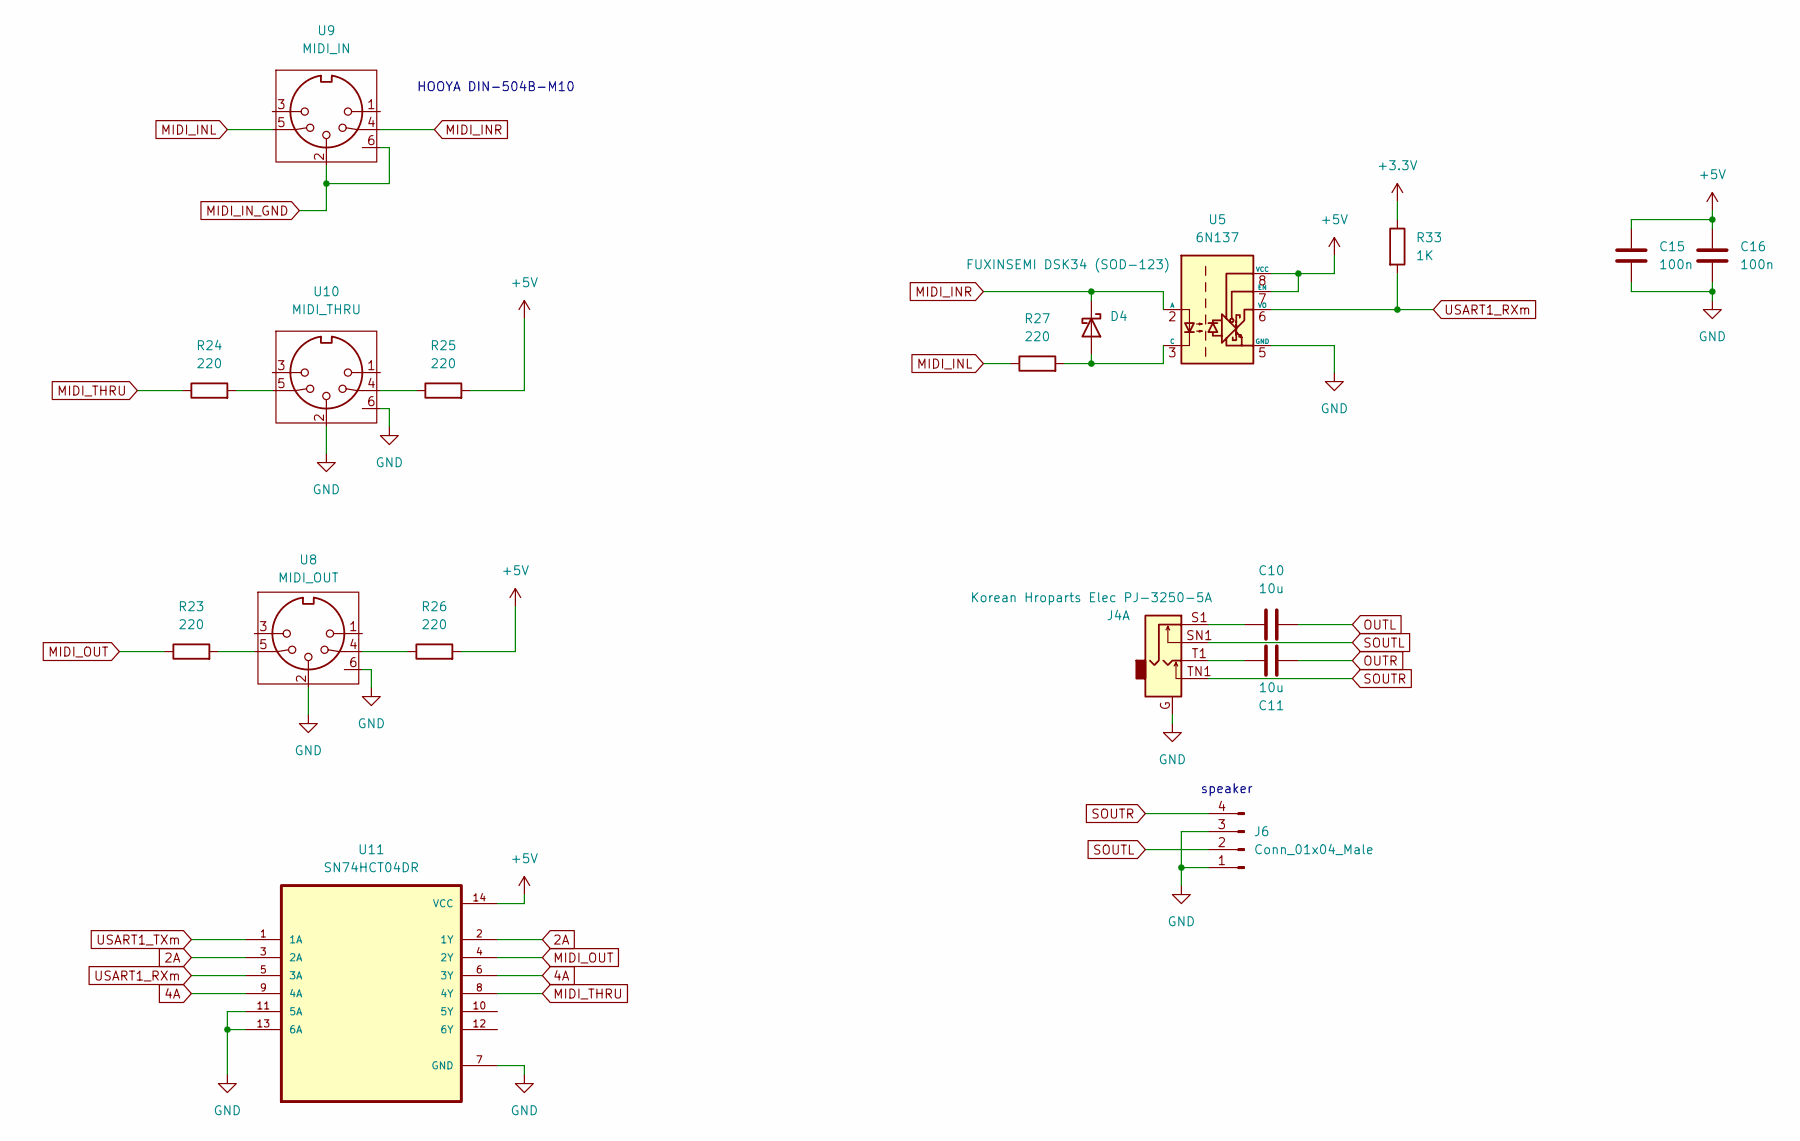
[picture p37: schematic midi_jacks.kicad_sch]

Parts:
C10, C11: 10u; C_Rect_L33.0mm_W15.0mm_P27.50mm_MKS4
C15, C16: 100n; C_0805_2012Metric_Pad1.18x1.45mm_HandSolder
D4: FUXINSEMI DSK34 (SOD-123); D_SOD-123
J4: Korean Hroparts Elec PJ-3250-5A
J6: Conn_01x04_Male; PinHeader_1x04_P2.54mm_Vertical
R23, R24, R25, R26, R27: 220; R_0805_2012Metric_Pad1.20x1.40mm_HandSolder
R33: 1K; R_0805_2012Metric_Pad1.20x1.40mm_HandSolder
U5: 6N137; DIP-8_W7.62mm
U8: MIDI_OUT; midi_7pin
U9: MIDI_IN; midi_7pin
U10: MIDI_THRU; midi_7pin
U11: SN74HCT04DR; SOIC-14_3.9x8.7mm_P1.27mm

Connections:
2A: U11.2 (1Y), U11.3 (2A)
4A: U11.6 (3Y), U11.9 (4A)
+3V3: R33.1; also elsewhere on the board
+5V: C15.1, C16.1, R25.2, R26.2, U5.7 (EN), U5.8 (VCC), U11.14 (VCC); also elsewhere on the board
GND: C15.2, C16.2, J4.G, J6.1, J6.3, U5.5 (GND), U8.2, U8.6, U10.2, U10.6, U11.7 (GND), U11.11 (5A), U11.13 (6A); also elsewhere on the board
MIDI_INL: R27.1, U9.5
MIDI_INR: D4.1 (K), U5.2 (A), U9.4
MIDI_IN_GND: U9.2, U9.6
MIDI_OUT: R23.1, U11.4 (2Y)
MIDI_THRU: R24.1, U11.8 (4Y)
unnamed: C10.1, J4.S1
unnamed: C11.1, J4.T1
unnamed: D4.2 (A), R27.2, U5.3 (C)
unnamed: R23.2, U8.5
unnamed: R24.2, U10.5
unnamed: R25.1, U10.4
unnamed: R26.1, U8.4
OUTL: C10.2; also elsewhere on the board
OUTR: C11.2; also elsewhere on the board
SOUTL: J4.SN1, J6.2
SOUTR: J4.TN1, J6.4
USART1_RXm: R33.2, U5.6 (VO), U11.5 (3A); also elsewhere on the board
USART1_TXm: U11.1 (1A); also elsewhere on the board

Notes on the sheet:
speaker
HOOYA DIN-504B-M10

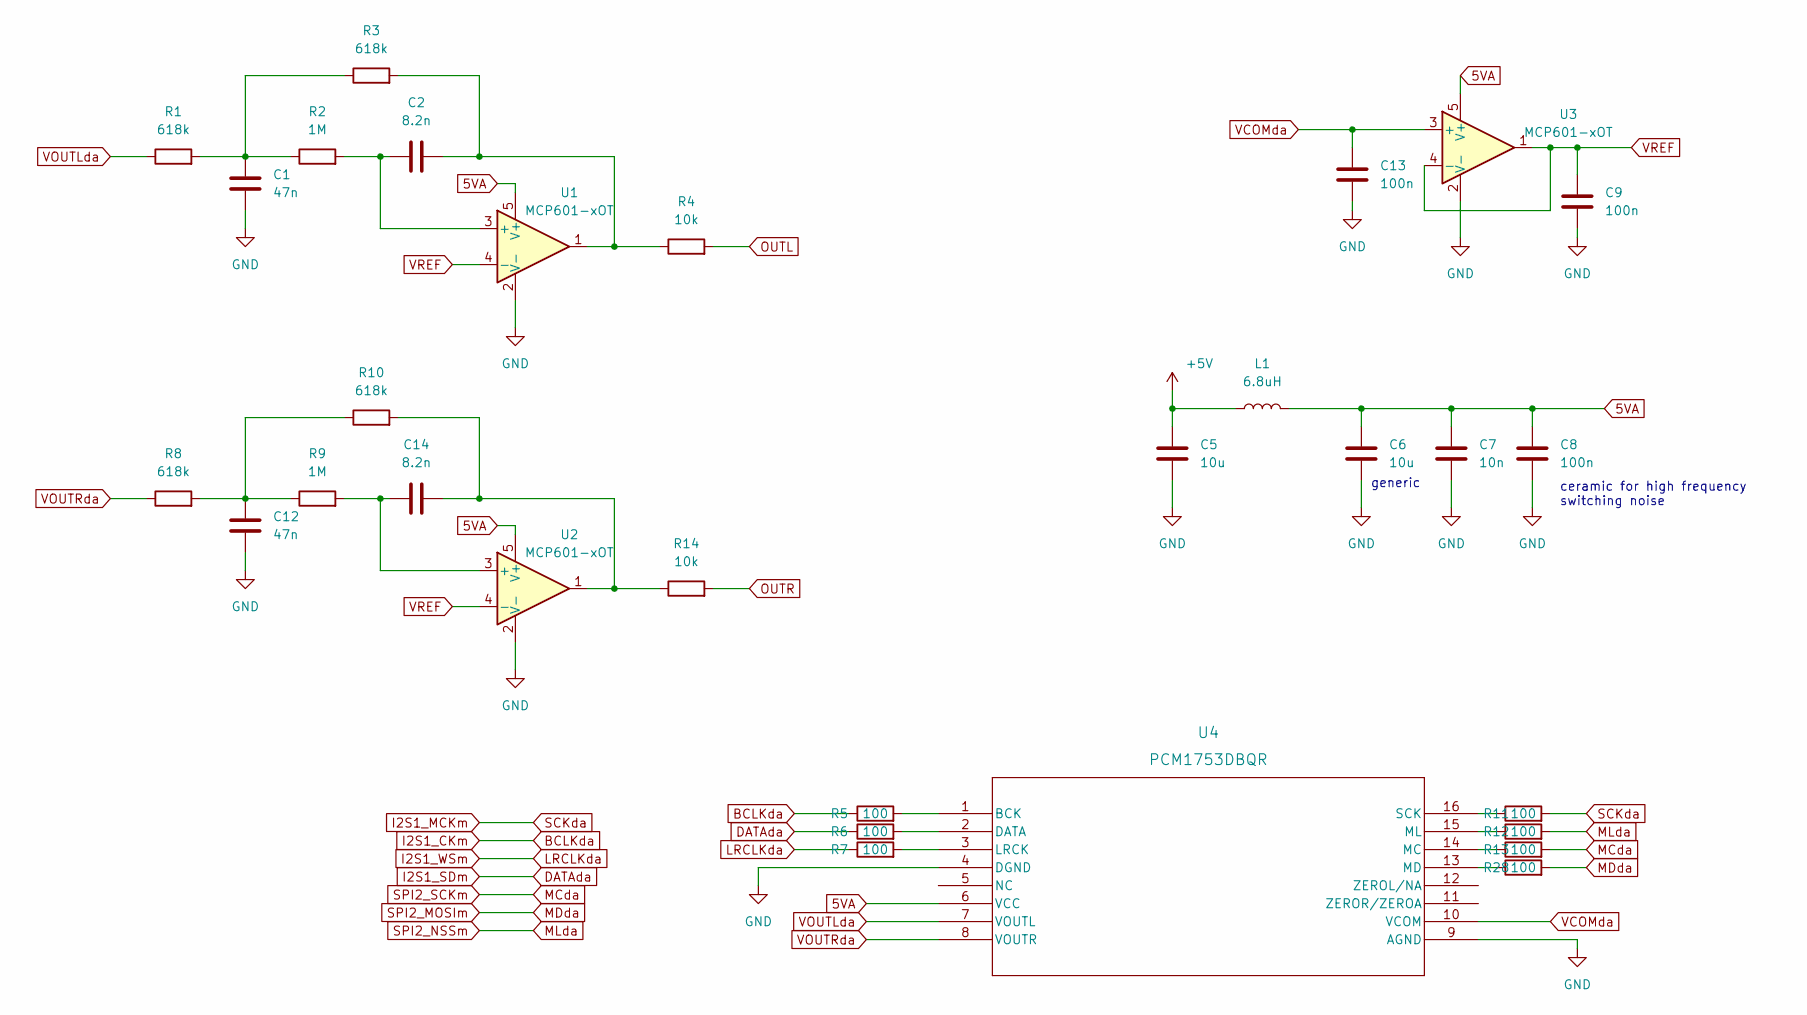
[picture p38: schematic dac_conv.kicad_sch]

Parts:
C1, C12: 47n; C_0805_2012Metric_Pad1.18x1.45mm_HandSolder
C2, C14: 8.2n; C_0805_2012Metric_Pad1.18x1.45mm_HandSolder
C5, C6: 10u; C_0805_2012Metric_Pad1.18x1.45mm_HandSolder
C7: 10n; C_0805_2012Metric_Pad1.18x1.45mm_HandSolder
C8, C9, C13: 100n; C_0805_2012Metric_Pad1.18x1.45mm_HandSolder
L1: 6.8uH; inductor_koherelec
R1, R3, R8, R10: 618k; R_0805_2012Metric_Pad1.20x1.40mm_HandSolder
R2, R9: 1M; R_0805_2012Metric_Pad1.20x1.40mm_HandSolder
R4, R14: 10k; R_0805_2012Metric_Pad1.20x1.40mm_HandSolder
R5, R6, R7, R11, R12, R13, R28: 100; R_0805_2012Metric_Pad1.20x1.40mm_HandSolder
U1, U2, U3: MCP601-xOT; SOT-23-5
U4: PCM1753DBQR; DBQ16

Connections:
5VA: C6.1, C7.1, C8.1, L1.2, U1.5 (V+), U2.5 (V+), U3.5 (V+), U4.6 (VCC)
+5V: C5.1, L1.1; also elsewhere on the board
BCLKda: R5.1; also elsewhere on the board
DATAda: R6.1; also elsewhere on the board
GND: C1.2, C5.2, C6.2, C7.2, C8.2, C9.2, C12.2, C13.2, U1.2 (V-), U2.2 (V-), U3.2 (V-), U4.4 (DGND), U4.9 (AGND); also elsewhere on the board
I2S1_MCKm: R11.2; also elsewhere on the board
I2S1_WSm: R7.1; also elsewhere on the board
MCda: R13.2; also elsewhere on the board
MDda: R28.2; also elsewhere on the board
MLda: R12.2; also elsewhere on the board
unnamed: C1.1, R1.2, R2.1, R3.1
unnamed: C2.1, R2.2, U1.3 (+)
unnamed: C2.2, R3.2, R4.1, U1.1
unnamed: C12.1, R8.2, R9.1, R10.1
unnamed: C14.1, R9.2, U2.3 (+)
unnamed: C14.2, R10.2, R14.1, U2.1
unnamed: R5.2, U4.1 (BCK)
unnamed: R6.2, U4.2 (DATA)
unnamed: R7.2, U4.3 (LRCK)
unnamed: R11.1, U4.16 (SCK)
unnamed: R12.1, U4.15 (ML)
unnamed: R13.1, U4.14 (MC)
unnamed: R28.1, U4.13 (MD)
OUTL: R4.2; also elsewhere on the board
OUTR: R14.2; also elsewhere on the board
VCOMda: C13.1, U3.3 (+), U4.10 (VCOM)
VOUTLda: R1.1, U4.7 (VOUTL)
VOUTRda: R8.1, U4.8 (VOUTR)
VREF: C9.1, U1.4 (-), U2.4 (-), U3.1, U3.4 (-)

Notes on the sheet:
generic
ceramic for high frequency switching noise

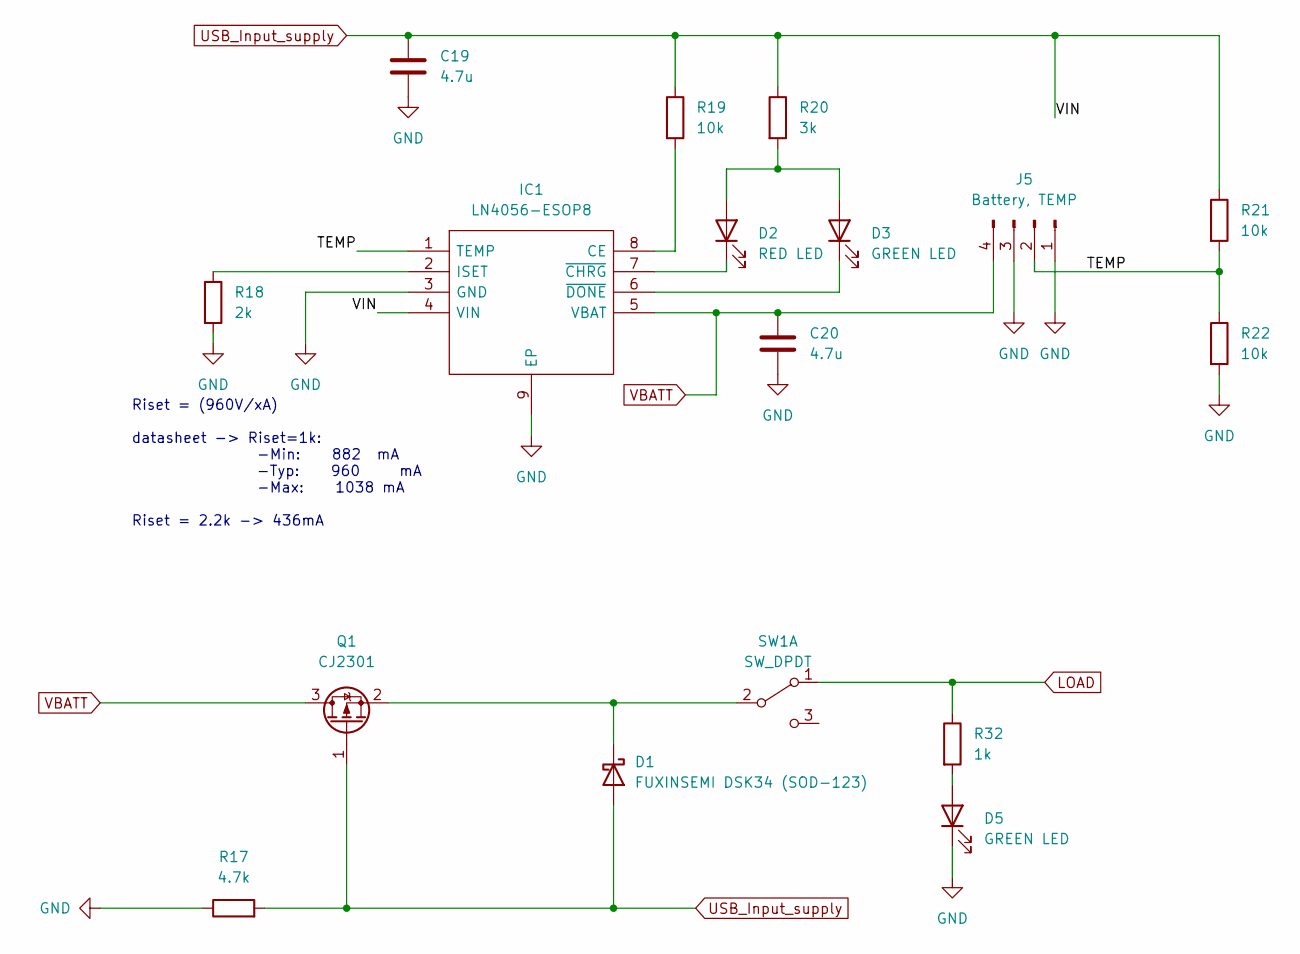
[picture p39: schematic chargerm.kicad_sch]

Parts:
C19, C20: 4.7u; C_0805_2012Metric_Pad1.18x1.45mm_HandSolder
D1: FUXINSEMI DSK34 (SOD-123); D_SOD-123
D2: RED LED; LED_0805_2012Metric_Pad1.15x1.40mm_HandSolder
D3, D5: GREEN LED; LED_0805_2012Metric_Pad1.15x1.40mm_HandSolder
IC1: LN4056-ESOP8; SOIC127P600X175-9N; Manufacturer_Part_Number TP4056-42-ESOP8
J5: Battery, TEMP; PinHeader_1x04_P2.54mm_Horizontal
Q1: CJ2301; SOT-23_Handsoldering
R17: 4.7k; R_0805_2012Metric_Pad1.20x1.40mm_HandSolder
R18: 2k; R_0805_2012Metric_Pad1.20x1.40mm_HandSolder
R19, R21, R22: 10k; R_0805_2012Metric_Pad1.20x1.40mm_HandSolder
R20: 3k; R_0805_2012Metric_Pad1.20x1.40mm_HandSolder
R32: 1k; R_0805_2012Metric_Pad1.20x1.40mm_HandSolder
SW1: SW_DPDT; PinHeader_1x03_P2.54mm_Horizontal

Connections:
/Power_dcdc/Battery_chargerm/TEMP: IC1.1 (TEMP), J5.2, R21.2, R22.1
GND: C19.2, C20.2, D5.1 (K), IC1.3 (GND), IC1.9 (EP), J5.1, J5.3, R17.1, R18.2, R22.2; also elsewhere on the board
LOAD: R32.1, SW1.1 (A); also elsewhere on the board
unnamed: D1.1 (K), Q1.2 (S), SW1.2 (B)
unnamed: D2.1 (K), IC1.7 (~CHRG)
unnamed: D2.2 (A), D3.2 (A), R20.2
unnamed: D3.1 (K), IC1.6 (~DONE)
unnamed: D5.2 (A), R32.2
unnamed: IC1.2 (ISET), R18.1
unnamed: IC1.8 (CE), R19.2
USB_Input_supply: C19.1, D1.2 (A), IC1.4 (VIN), Q1.1 (G), R17.2, R19.1, R20.1, R21.1; also elsewhere on the board
VBATT: C20.1, IC1.5 (VBAT), J5.4, Q1.3 (D)

Notes on the sheet:
Riset = (960V/xA) datasheet -> Riset=1k: -Min: 882 mA -Typ: 960 mA -Max: 1038 mA Riset = 2.2k -> 436mA

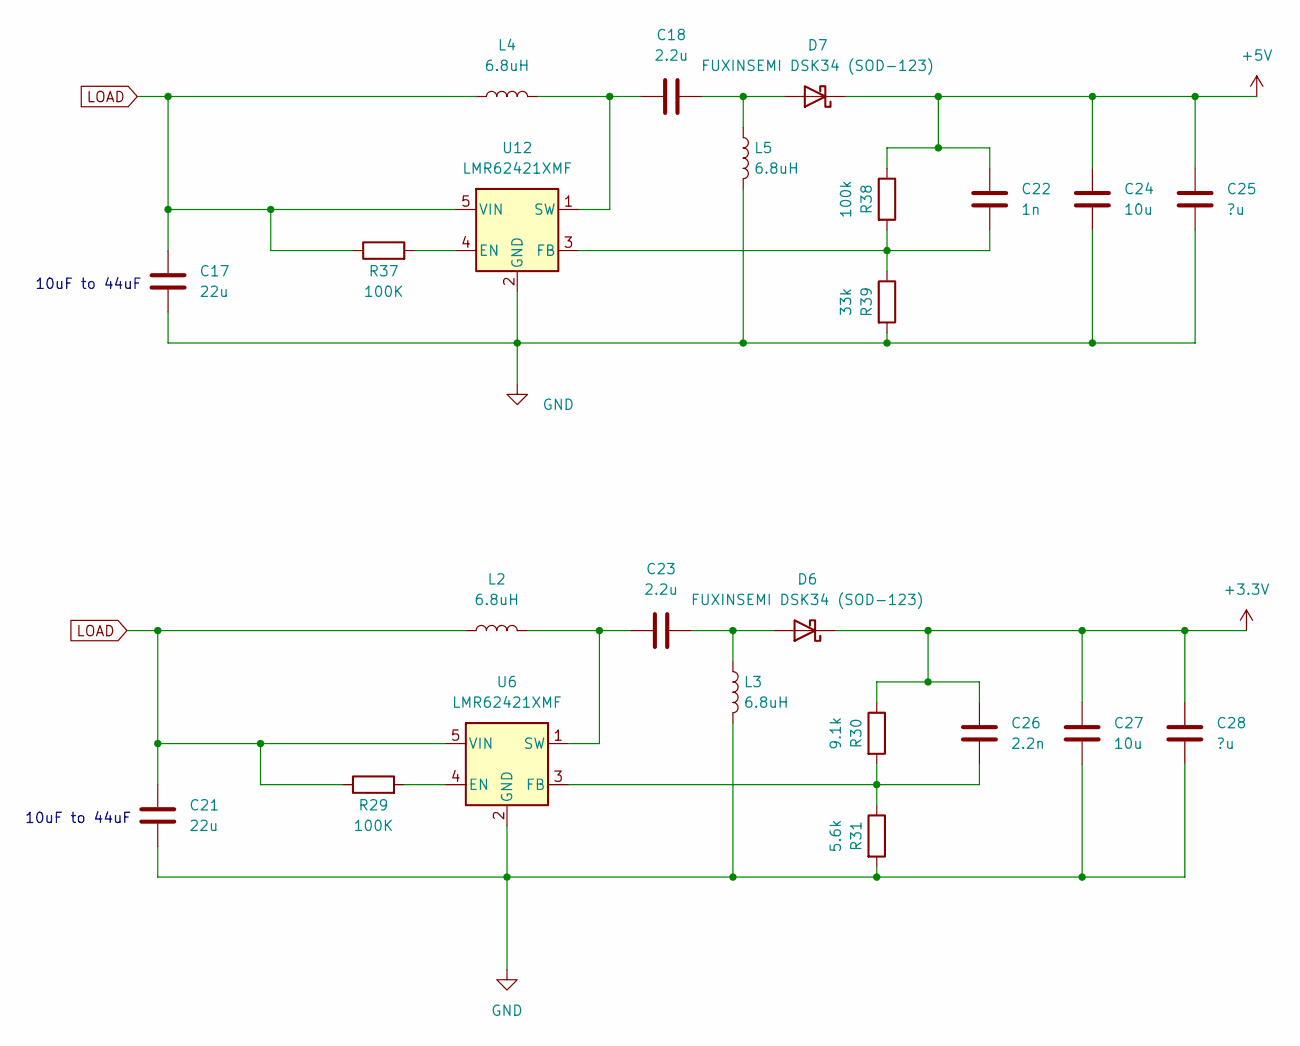
[picture p40: schematic dcdc_convs.kicad_sch]

Parts:
C17, C21: 22u; C_0805_2012Metric_Pad1.18x1.45mm_HandSolder
C18, C23: 2.2u; C_0805_2012Metric_Pad1.18x1.45mm_HandSolder
C22: 1n; C_0805_2012Metric_Pad1.18x1.45mm_HandSolder
C24, C27: 10u; C_0805_2012Metric_Pad1.18x1.45mm_HandSolder
C25, C28: ?u; C_0805_2012Metric_Pad1.18x1.45mm_HandSolder
C26: 2.2n; C_0805_2012Metric_Pad1.18x1.45mm_HandSolder
D6, D7: FUXINSEMI DSK34 (SOD-123); D_SOD-123
L2, L3, L4, L5: 6.8uH; inductor_koherelec
R29, R37: 100K; R_0805_2012Metric_Pad1.20x1.40mm_HandSolder
R30: 9.1k; R_0805_2012Metric_Pad1.20x1.40mm_HandSolder
R31: 5.6k; R_0805_2012Metric_Pad1.20x1.40mm_HandSolder
R38: 100k; R_0805_2012Metric_Pad1.20x1.40mm_HandSolder
R39: 33k; R_0805_2012Metric_Pad1.20x1.40mm_HandSolder
U6, U12: LMR62421XMF; SOT-23-5

Connections:
+3V3: C26.1, C27.1, C28.1, D6.1 (K), R30.1; also elsewhere on the board
+5V: C22.1, C24.1, C25.1, D7.1 (K), R38.1; also elsewhere on the board
GND: C17.2, C21.2, C24.2, C25.2, C27.2, C28.2, L3.2, L5.2, R31.2, R39.2, U6.2 (GND), U12.2 (GND); also elsewhere on the board
LOAD: C17.1, C21.1, L2.1, L4.1, R29.1, R37.1, U6.5 (VIN), U12.5 (VIN); also elsewhere on the board
unnamed: C18.1, L4.2, U12.1 (SW)
unnamed: C18.2, D7.2 (A), L5.1
unnamed: C22.2, R38.2, R39.1, U12.3 (FB)
unnamed: C23.1, L2.2, U6.1 (SW)
unnamed: C23.2, D6.2 (A), L3.1
unnamed: C26.2, R30.2, R31.1, U6.3 (FB)
unnamed: R29.2, U6.4 (EN)
unnamed: R37.2, U12.4 (EN)

Notes on the sheet:
10uF to 44uF

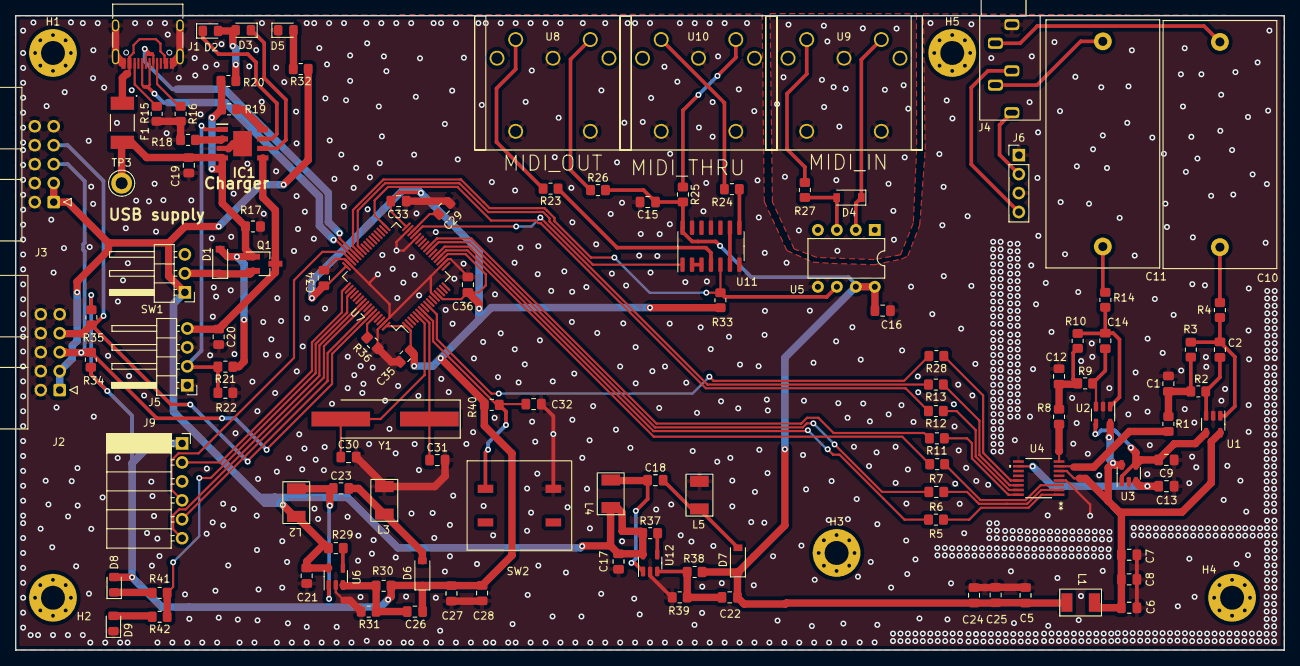
[picture p41: board main_func.kicad_pcb from above]

Board: 2 copper layers, 170.0 x 85.0 mm, 121 parts (0 on the bottom side), 86 nets.
