torok-samuel/Digital-synthesizer-project/Keyboard/keyboard/dcdc.kicad_sch

## KiCad design Keyboard/keyboard/dcdc.kicad_sch (2023-04-26)

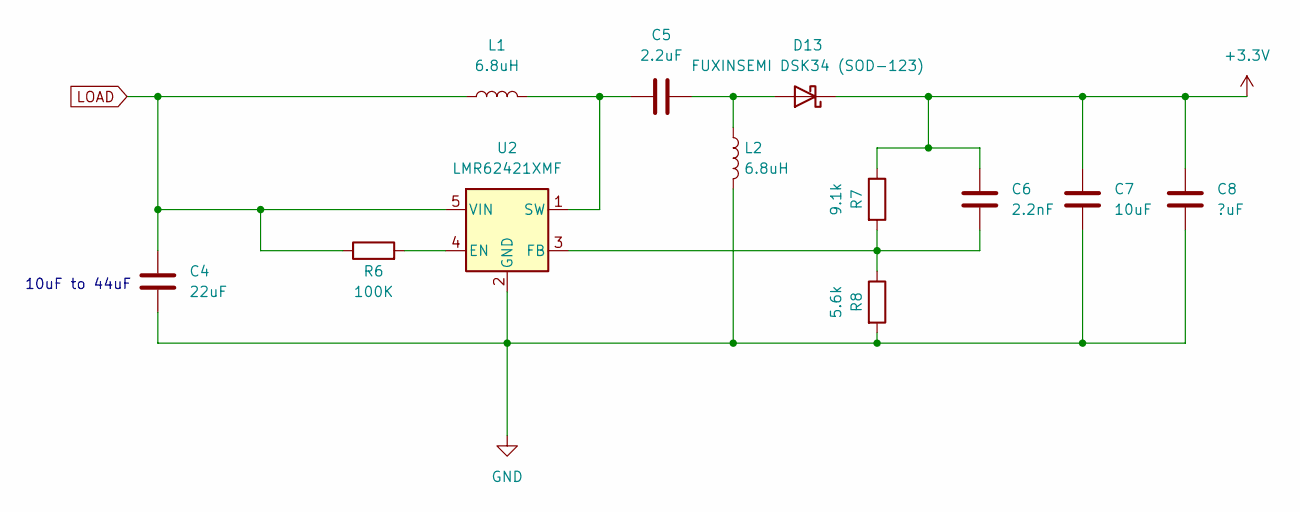
[picture p42: schematic dcdc.kicad_sch]

Parts:
C4: 22uF; C_0805_2012Metric_Pad1.18x1.45mm_HandSolder
C5: 2.2uF; C_0805_2012Metric_Pad1.18x1.45mm_HandSolder
C6: 2.2nF; C_0805_2012Metric_Pad1.18x1.45mm_HandSolder
C7: 10uF; C_0805_2012Metric_Pad1.18x1.45mm_HandSolder
C8: ?uF; C_0805_2012Metric_Pad1.18x1.45mm_HandSolder
D13: FUXINSEMI DSK34 (SOD-123); D_SOD-123
L1, L2: 6.8uH; inductor_koherelec
R6: 100K; R_0805_2012Metric_Pad1.20x1.40mm_HandSolder
R7: 9.1k; R_0805_2012Metric_Pad1.20x1.40mm_HandSolder
R8: 5.6k; R_0805_2012Metric_Pad1.20x1.40mm_HandSolder
U2: LMR62421XMF; SOT-23-5

Connections:
+3.3V: C6.1, C7.1, C8.1, D13.1 (K), R7.1
GND: C4.2, C7.2, C8.2, L2.2, R8.2, U2.2 (GND)
LOAD: C4.1, L1.1, R6.1, U2.5 (VIN)
unnamed: C5.1, L1.2, U2.1 (SW)
unnamed: C5.2, D13.2 (A), L2.1
unnamed: C6.2, R7.2, R8.1, U2.3 (FB)
unnamed: R6.2, U2.4 (EN)

Notes on the sheet:
10uF to 44uF
