torok-samuel/Digital-synthesizer-project/Keyboard/keyboard/key_stm32g030k6t6.kicad_sch

## KiCad design Keyboard/keyboard/key_stm32g030k6t6.kicad_sch (2023-05-13)

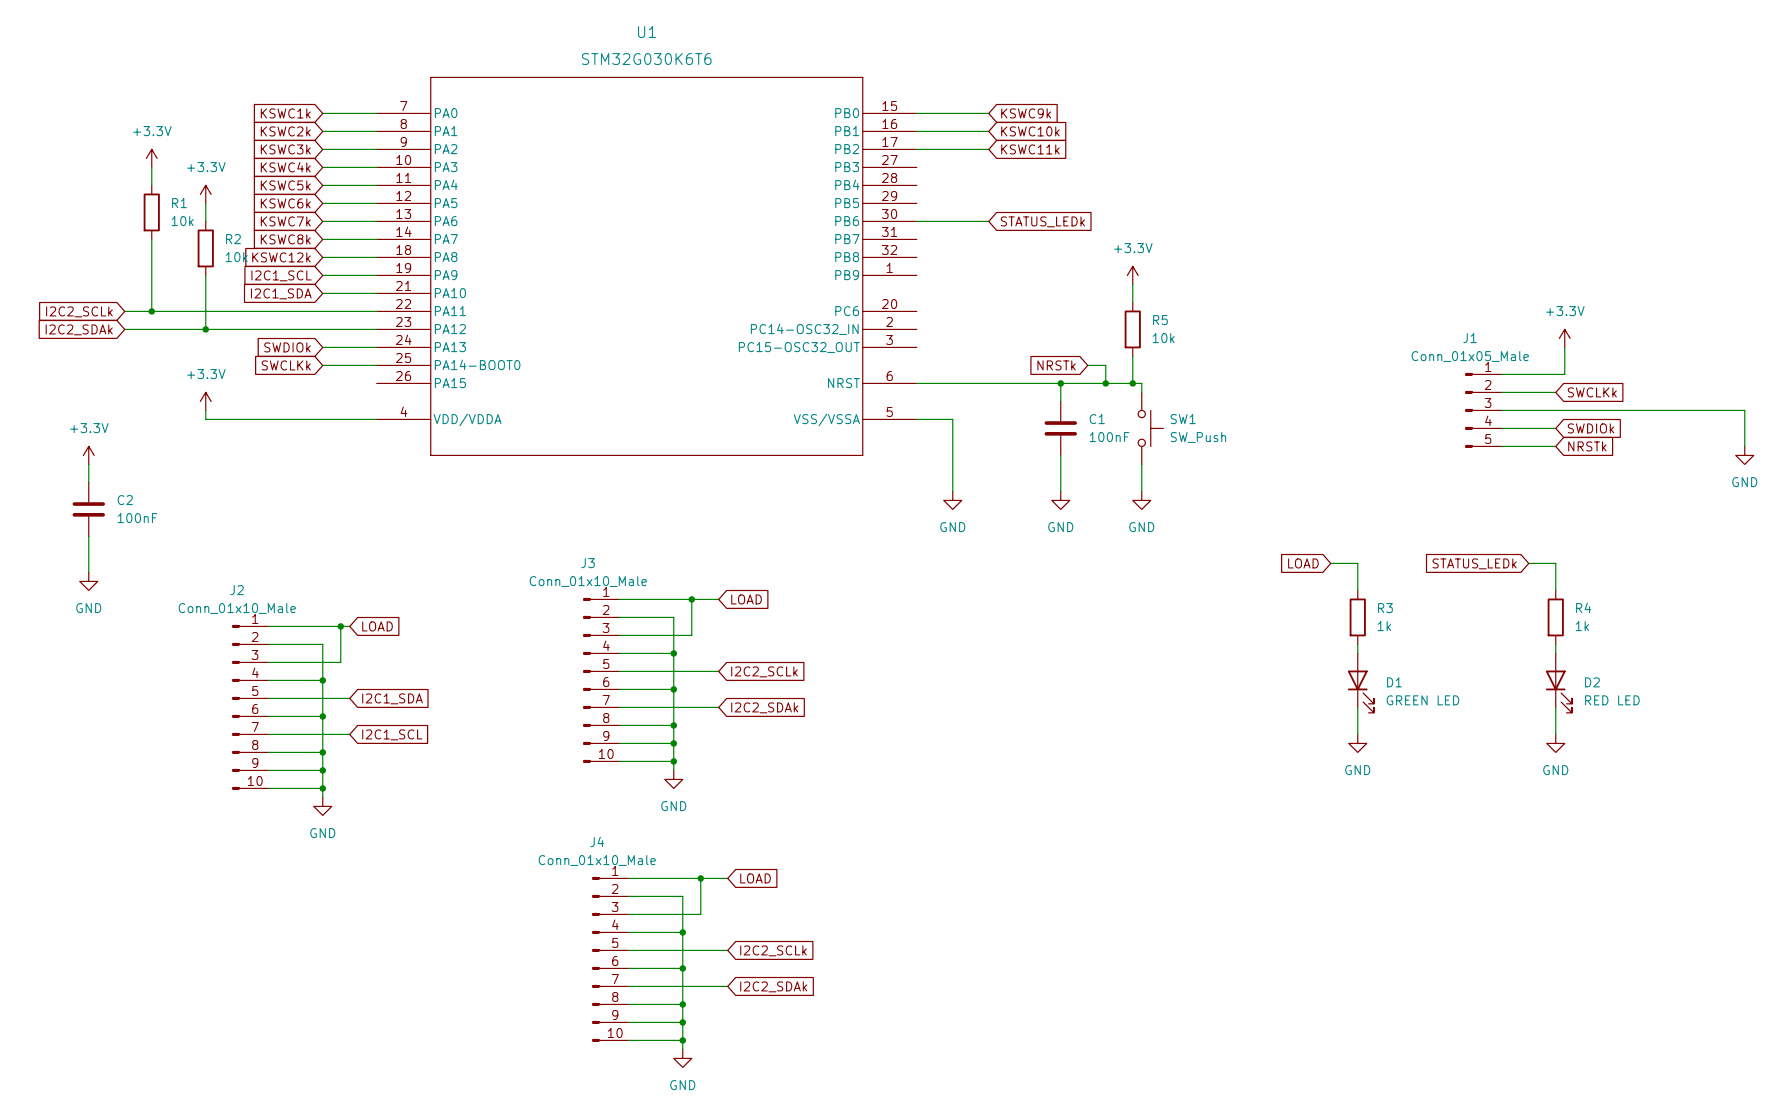
[picture p43: schematic key_stm32g030k6t6.kicad_sch]

Parts:
C1, C2: 100nF; C_0805_2012Metric_Pad1.18x1.45mm_HandSolder
D1: GREEN LED; LED_0805_2012Metric_Pad1.15x1.40mm_HandSolder
D2: RED LED; LED_0805_2012Metric_Pad1.15x1.40mm_HandSolder
J1: Conn_01x05_Male; PinSocket_1x05_P2.54mm_Vertical
J2: Conn_01x10_Male; IDC-Header_2x05_P2.54mm_Horizontal
J3, J4: Conn_01x10_Male; IDC-Header_2x05_P2.54mm_Vertical
R1, R2, R5: 10k; R_0805_2012Metric_Pad1.20x1.40mm_HandSolder
R3, R4: 1k; R_0805_2012Metric_Pad1.20x1.40mm_HandSolder
SW1: SW_Push; ROCPU Switches TP10721645
U1: STM32G030K6T6; LQFP-32

Connections:
+3.3V: C2.1, J1.1, R1.1, R2.1, R5.1, U1.4 (VDD/VDDA)
GND: C1.2, C2.2, D1.1 (K), D2.1 (K), J1.3, J2.2, J2.4, J2.6, J2.8, J2.9, J2.10, J3.2, J3.4, J3.6, J3.8, J3.9, J3.10, J4.2, J4.4, J4.6, J4.8, J4.9, J4.10, SW1.2, U1.5 (VSS/VSSA)
I2C1_SCL: J2.7, U1.19 (PA9)
I2C1_SDA: J2.5, U1.21 (PA10)
I2C2_SCLk: J3.5, J4.5, R1.2, U1.22 (PA11)
I2C2_SDAk: J3.7, J4.7, R2.2, U1.23 (PA12)
KSWC1k: U1.7 (PA0)
KSWC2k: U1.8 (PA1)
KSWC3k: U1.9 (PA2)
KSWC4k: U1.10 (PA3)
KSWC5k: U1.11 (PA4)
KSWC6k: U1.12 (PA5)
KSWC7k: U1.13 (PA6)
KSWC8k: U1.14 (PA7)
KSWC9k: U1.15 (PB0)
KSWC10k: U1.16 (PB1)
KSWC11k: U1.17 (PB2)
KSWC12k: U1.18 (PA8)
LOAD: J2.1, J2.3, J3.1, J3.3, J4.1, J4.3, R3.1
NRSTk: C1.1, J1.5, R5.2, SW1.1, U1.6 (NRST)
unnamed: D1.2 (A), R3.2
unnamed: D2.2 (A), R4.2
STATUS_LEDk: R4.1, U1.30 (PB6)
SWCLKk: J1.2, U1.25 (PA14-BOOT0)
SWDIOk: J1.4, U1.24 (PA13)
