torok-samuel/Digital-synthesizer-project/Keyboard/keyboard/keys.kicad_sch

## KiCad design Keyboard/keyboard/keys.kicad_sch (2023-05-13)

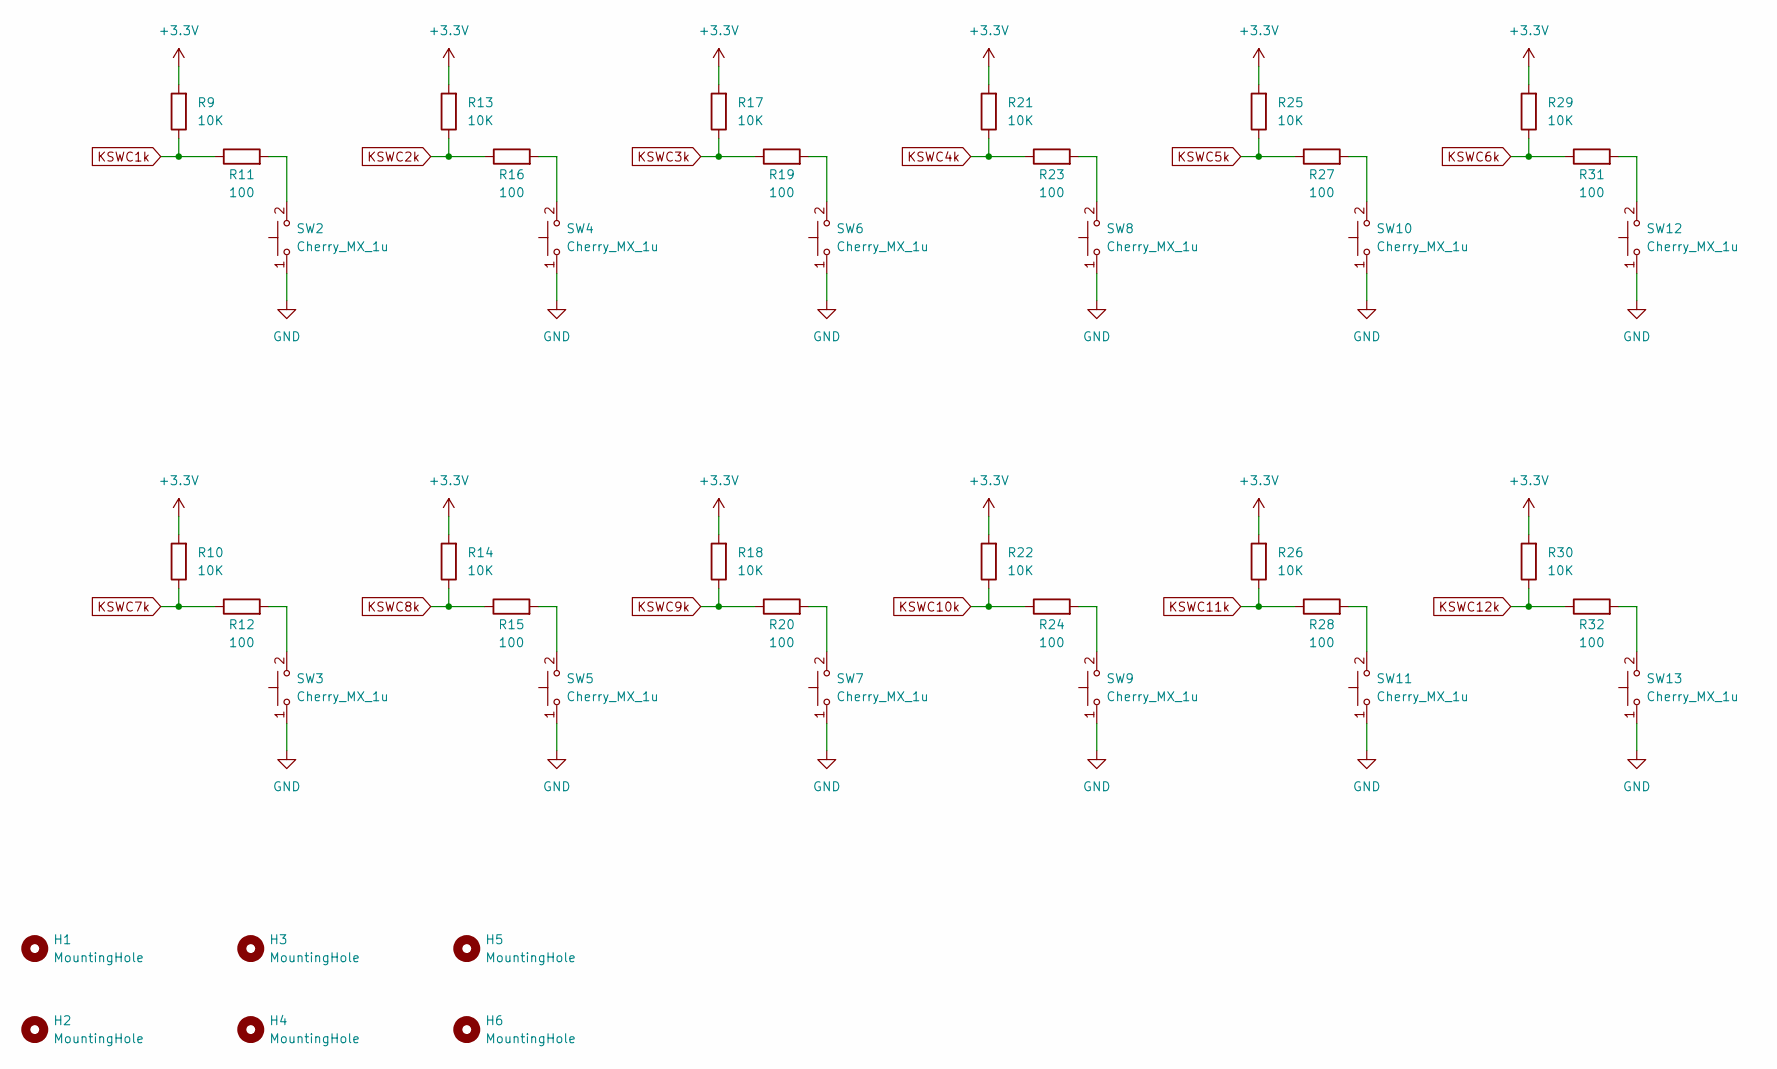
[picture p44: schematic keys.kicad_sch]

Parts:
H1, H2, H3, H4, H5, H6: MountingHole; MountingHole_3.2mm_M3_Pad_Via
R9, R10, R13, R14, R17, R18, R21, R22, R25, R26, R29, R30: 10K; R_0805_2012Metric_Pad1.20x1.40mm_HandSolder
R11, R12, R15, R16, R19, R20, R23, R24, R27, R28, R31, R32: 100; R_0805_2012Metric_Pad1.20x1.40mm_HandSolder
SW2, SW3, SW4, SW5, SW6, SW7, SW8, SW9, SW10, SW11, SW12, SW13: Cherry_MX_1u; SW_Cherry_MX_PCB_1.00u

Connections:
+3.3V: R9.2, R10.2, R13.2, R14.2, R17.2, R18.2, R21.2, R22.2, R25.2, R26.2, R29.2, R30.2
GND: SW2.1, SW3.1, SW4.1, SW5.1, SW6.1, SW7.1, SW8.1, SW9.1, SW10.1, SW11.1, SW12.1, SW13.1
KSWC1k: R9.1, R11.1
KSWC2k: R13.1, R16.1
KSWC3k: R17.1, R19.1
KSWC4k: R21.1, R23.1
KSWC5k: R25.1, R27.1
KSWC6k: R29.1, R31.1
KSWC7k: R10.1, R12.1
KSWC8k: R14.1, R15.1
KSWC9k: R18.1, R20.1
KSWC10k: R22.1, R24.1
KSWC11k: R26.1, R28.1
KSWC12k: R30.1, R32.1
unnamed: R11.2, SW2.2
unnamed: R12.2, SW3.2
unnamed: R15.2, SW5.2
unnamed: R16.2, SW4.2
unnamed: R19.2, SW6.2
unnamed: R20.2, SW7.2
unnamed: R23.2, SW8.2
unnamed: R24.2, SW9.2
unnamed: R27.2, SW10.2
unnamed: R28.2, SW11.2
unnamed: R31.2, SW12.2
unnamed: R32.2, SW13.2
