torok-samuel/Digital-synthesizer-project/software_slidepot/Core/Src/main.c

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
/* Includes ------------------------------------------------------------------*/
#include "main.h"

/* USER CODE BEGIN Includes */
#include <stdbool.h>
#include "math.h"

#include "digitalsynth_slide_i2c.h"
#include "digitalsynth_slide_butt.h"
/* USER CODE END Includes */

/* USER CODE BEGIN PD */

//WS2812b defines
#define MAX_LED 25                 //25
#define USE_BRIGHTNESS 0
#define PI 3.14159265
#define WS2812B_RST_TIME 20     //50us<

//I2C defines
#define TXSIZE 12
#define RXSIZE  3
#define TOGGLEDELAY     1000        //1s -   num/ms/s
#define BUTTDELAY       10          //10ms - num/ms/s


//Button defines
#define ROWSIZE 5
#define COLSIZE 5

//adc
#define ADC_BUF_LEN 2*8
    
    
/* USER CODE END PD */

ADC_HandleTypeDef hadc1;
DMA_HandleTypeDef hdma_adc1;

I2C_HandleTypeDef hi2c1;

TIM_HandleTypeDef htim14;
TIM_HandleTypeDef htim17;
DMA_HandleTypeDef hdma_tim17_ch1;

/* USER CODE BEGIN PV */

//WS2812b global variables
uint8_t LED_Data[MAX_LED][4];
uint8_t LED_Mod[MAX_LED][4];    //for brightness
int datasentflag=0;
  
uint8_t green = 0;
uint8_t red = 0;
uint8_t blue = 0;

uint16_t pwmData[(24*MAX_LED)+WS2812B_RST_TIME];

//I2C global variables
uint8_t RxData[RXSIZE];
uint8_t rxcount = 0;
int countAddr = 0;
uI2CSlidePotControls sCont;
uint32_t u32LastToggleTick = 0;
uint32_t u32LastButtTick = 0;
HAL_StatusTypeDef status;

//reseting i2c
uint8_t u8ErrorFlag = 0;
uint32_t u32ErrorTick = 0;

//adc
uint8_t arru8adc_buf[ADC_BUF_LEN];
uint8_t * pu8adc_bufcurr;
/* USER CODE END PV */

void SystemClock_Config(void);
static void MX_GPIO_Init(void);
static void MX_DMA_Init(void);
static void MX_ADC1_Init(void);
static void MX_I2C1_Init(void);
static void MX_TIM17_Init(void);
static void MX_TIM14_Init(void);
/* USER CODE BEGIN PFP */
void HAL_TIM_PWM_PulseFinishedCallback(TIM_HandleTypeDef *htim);
void send(uint8_t Green, uint8_t Red, uint8_t Blue);
void Set_LED(int LEDnum, int Red, int Green, int Blue);
void Set_Brightness(int brightness);
void WS2812_Send (void);
void i2c_reset(I2C_HandleTypeDef *hi2c);
/* USER CODE END PFP */

/**
  * @brief  The application entry point.
  * @retval int
  */
int main(void)
{
  /* MCU Configuration--------------------------------------------------------*/

  /* Reset of all peripherals, Initializes the Flash interface and the Systick. */
  HAL_Init();

  /* Configure the system clock */
  SystemClock_Config();

  /* Initialize all configured peripherals */
  MX_GPIO_Init();
  MX_DMA_Init();
  MX_ADC1_Init();
  MX_I2C1_Init();
  MX_TIM17_Init();
  MX_TIM14_Init();
  /* USER CODE BEGIN 2 */

  Set_LED(1, 0, 0, 1);

  //TODO BRIGHTNESS
  //Set_Brightness(20);
  WS2812_Send();
  
  for(int i = 0; i < 12; i++)
    sCont.au8I2CSlidePotByteAccess[i] = 0;
  

  
  
  /* USER CODE END 2 */

  /* Infinite loop */
  /* USER CODE BEGIN WHILE */
  
  //adc dma
  HAL_ADC_Start_DMA(&hadc1, (uint32_t*)arru8adc_buf, ADC_BUF_LEN);
  
  HAL_TIM_Base_Start_IT(&htim14);
  u32LastToggleTick = HAL_GetTick();
  u32LastButtTick = HAL_GetTick();
  while (1)
  {
    /* USER CODE END WHILE */

    /* USER CODE BEGIN 3 */
    //I2C communication
    status = HAL_I2C_Slave_Transmit(&hi2c1, sCont.au8I2CSlidePotByteAccess, TXSIZE,100);
    
    //if the line is busy, reset
    if( (status != HAL_OK) & (u8ErrorFlag==0) ){
      u8ErrorFlag = 1;
      u32ErrorTick = HAL_GetTick();
    }
    if( ( status != HAL_OK ) & ( HAL_GetTick() > (u32ErrorTick+250) ) & (u8ErrorFlag==1) ){
      i2c_reset(&hi2c1);
      u8ErrorFlag = 0;
    }
    
    //toggle status led
    while ((HAL_GetTick() - u32LastToggleTick) > TOGGLEDELAY){
      HAL_GPIO_TogglePin(GPIOC, GPIO_PIN_15);
      u32LastToggleTick = HAL_GetTick();
    }

    
    if ((HAL_GetTick() - u32LastButtTick) > BUTTDELAY){
      switch(sCont.sI2CSlidePotControl.u2ButtWaveform1){
        case 0:
          Set_LED(0, 0, 0, 0);
          break;
        case 1:
          Set_LED(0, 1, 0, 0);
          break;
        case 2:
          Set_LED(0, 0, 1, 0);
          break;
        case 3:
          Set_LED(0, 0, 0, 1);
          break;
        default:
          Set_LED(0, 0, 0, 0);        
      }
      WS2812_Send();
      u32LastButtTick = HAL_GetTick();
    }    
    
  }
  /* USER CODE END 3 */
}

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
/* USER CODE BEGIN 4 */

void HAL_TIM_PWM_PulseFinishedCallback(TIM_HandleTypeDef *htim){
  HAL_TIMEx_PWMN_Stop_DMA(&htim17, TIM_CHANNEL_1);
  datasentflag=1;  
}

#pragma optimize=none
void send(uint8_t Green, uint8_t Red, uint8_t Blue){
  
  //lol
  uint32_t data1 = 0;
  uint32_t data3 = 0;
  
  uint32_t data = (Green<<16) | (Red<<8) | Blue;
    
  uint16_t pwmData2[92];
  int indx = 0;
  
  //data1 
  for(int i=23; i>=0;i--){
    if(data1&(1<<i))
      pwmData2[indx] = 13;          //12.8
    else
      pwmData2[indx] = 6;           //6.4
    
    indx++;
  }
    
  //62.5ns steps, 
  for(int i=23; i>=0;i--){
    if(data&(1<<i))
      pwmData2[indx] = 13;          //12.8
    else
      pwmData2[indx] = 6;           //6.4
    
    indx++;
  }
  
  //data3
  for(int i=23; i>=0;i--){
    if(data3&(1<<i))
      pwmData2[indx] = 13;          //12.8
    else
      pwmData2[indx] = 6;           //6.4
    
    indx++;
  }
  
  for (int i=0; i<20; i++){
    pwmData2[indx] = 0;
    indx++;
  }
  
  HAL_TIMEx_PWMN_Start_DMA(&htim17, TIM_CHANNEL_1, (uint32_t *)pwmData2, indx);
  while (!datasentflag){};
  datasentflag = 0;
}

void Set_LED(int LEDnum, int Red, int Green, int Blue){
  LED_Data[LEDnum][0] = LEDnum;
  LED_Data[LEDnum][1] = Green;
  LED_Data[LEDnum][2] = Red;
  LED_Data[LEDnum][3] = Blue;
}

void Set_Brightness(int brightness)
{
#if USE_BRIGHTNESS
  if(brightness > 45)
    brightness = 45;
  for(int i = 0; i < MAX_LED; i++){
    LED_Mod[i][0] = LED_Data[i][0];
    for(int j = 1; j < 4; j++){
      float angle = 90*brightness;      //in degrees
      angle = angle * PI / 180;         //in rad
      LED_Mod[i][j] = (LED_Data[i][j]/(tan(angle)));
    }
  }
#endif
}

#pragma optimize=none
void WS2812_Send (void)
{
	uint32_t indx=0;
	uint32_t color;


	for (int i= 0; i<MAX_LED; i++)
	{
#if USE_BRIGHTNESS
		color = ((LED_Mod[i][1]<<16) | (LED_Mod[i][2]<<8) | (LED_Mod[i][3]));
#else
		color = ((LED_Data[i][1]<<16) | (LED_Data[i][2]<<8) | (LED_Data[i][3]));
#endif

		for (int i=23; i>=0; i--)
		{
			if (color&(1<<i))
			{
				pwmData[indx] = 13;  //12.8
			}

			else pwmData[indx] = 6;  //6.4

			indx++;
		}

	}

	for (int u=0; u<WS2812B_RST_TIME; u++)
	{
		pwmData[indx] = 0;
		indx++;
	}
        HAL_TIMEx_PWMN_Start_DMA(&htim17, TIM_CHANNEL_1, (uint32_t *)pwmData, indx);
	while (!datasentflag){};
	datasentflag = 0;
}

void i2c_reset(I2C_HandleTypeDef *hi2c){
  SET_BIT(hi2c->Instance->CR1, I2C_CR1_SWRST);
  HAL_Delay( 10 );
  CLEAR_BIT(hi2c->Instance->CR1, I2C_CR1_SWRST);
  MX_I2C1_Init();
}

//adc double buffering
void HAL_ADC_ConvHalfCpltCallback(ADC_HandleTypeDef* hadc){
  sCont.sI2CSlidePotControl.u8SlidePot[0] = arru8adc_buf[0];
  sCont.sI2CSlidePotControl.u8SlidePot[1] = arru8adc_buf[1];
  sCont.sI2CSlidePotControl.u8SlidePot[2] = arru8adc_buf[2];
  sCont.sI2CSlidePotControl.u8SlidePot[3] = arru8adc_buf[3];
  sCont.sI2CSlidePotControl.u8SlidePot[4] = arru8adc_buf[4];
  sCont.sI2CSlidePotControl.u8SlidePot[5] = arru8adc_buf[5];
  sCont.sI2CSlidePotControl.u8SlidePot[6] = arru8adc_buf[6];
  sCont.sI2CSlidePotControl.u8SlidePot[7] = arru8adc_buf[7];
}

void HAL_ADC_ConvCpltCallback(ADC_HandleTypeDef* hadc){
  sCont.sI2CSlidePotControl.u8SlidePot[0] = arru8adc_buf[8];
  sCont.sI2CSlidePotControl.u8SlidePot[1] = arru8adc_buf[9];
  sCont.sI2CSlidePotControl.u8SlidePot[2] = arru8adc_buf[10];
  sCont.sI2CSlidePotControl.u8SlidePot[3] = arru8adc_buf[11];
  sCont.sI2CSlidePotControl.u8SlidePot[4] = arru8adc_buf[12];
  sCont.sI2CSlidePotControl.u8SlidePot[5] = arru8adc_buf[13];
  sCont.sI2CSlidePotControl.u8SlidePot[6] = arru8adc_buf[14];
  sCont.sI2CSlidePotControl.u8SlidePot[7] = arru8adc_buf[15];
}

/* USER CODE END 4 */
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
