torok-samuel/Digital-synthesizer-project/software_slidepot/software_slidepot.ioc

Mcu.UserName=STM32G030K6Tx
PA0.Signal=ADC1_IN0
PA1.Signal=ADC1_IN1
PA10.Signal=I2C1_SDA
PA13.Signal=SYS_SWDIO
PA14-BOOT0.Signal=SYS_SWCLK
PA15.GPIO_Label=R1
PA15.Signal=GPIO_Input
PA2.Signal=ADC1_IN2
PA3.Signal=ADC1_IN3
PA4.Signal=ADC1_IN4
PA5.Signal=ADC1_IN5
PA6.Signal=ADC1_IN6
PA7.Signal=ADC1_IN7
PA8.GPIO_Label=R5
PA8.Signal=GPIO_Input
PA9.Signal=I2C1_SCL
PB3.GPIO_Label=C1
PB3.Signal=GPIO_Output
PB4.GPIO_Label=C2
PB4.Signal=GPIO_Output
PB5.GPIO_Label=C3
PB5.Signal=GPIO_Output
PB7.GPIO_Label=LEDS
PB7.Signal=TIM17_CH1N
PB8.GPIO_Label=C4
PB8.Signal=GPIO_Output
PB9.GPIO_Label=C5
PB9.Signal=GPIO_Output
PC6.GPIO_Label=R4
PC6.Signal=GPIO_Input
