torok-samuel/Digital-synthesizer-project/software/Core/Src/main.c

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
/* Includes ------------------------------------------------------------------*/
#include "main.h"

/* USER CODE BEGIN Includes */
#include <math.h>
#include <stdio.h>
#include <string.h>

//project headers
#include "digitalsynth_main_i2c.h"
//#include "samples.h"
#include "digitalsynth_dsp.h"

/* USER CODE END Includes */

/* USER CODE BEGIN PD */
#define BUFFER_SIZE 256;

#define TICKDELAY       10        //10ms - num/ms/s
#define ONEBITTIMEI2C   1000/48000        //1 bit time for i2c

#define SLIDEPOT_ADDR 0x12<<1
#define PLUGPOT_ADDR 0x13<<1
#define KEYPOT_ADDR 0x14<<1

#define SLIDEPOT_RXSIZE 12
#define PLUGPOT_RXSIZE 13
#define KEY_RXSIZE 2
/* USER CODE END PD */

I2C_HandleTypeDef hi2c1;

I2S_HandleTypeDef hi2s1;
DMA_HandleTypeDef hdma_spi1_tx;

TIM_HandleTypeDef htim6;

UART_HandleTypeDef huart1;
UART_HandleTypeDef huart3;

PCD_HandleTypeDef hpcd_USB_OTG_FS;

/* USER CODE BEGIN PV */

//HAL_StatusTypeDef status;
//hi2c1->Instance->SR1&

//PCM1753 SPI setup
//R16-0x10FF, R18-0x1200, 0x1300, 0x1404, 0x1600
const uint16_t SPI_SETUP_REG[] = {
0x10FF, //R16
0x11FF, //R17
0x1200, //R18
0x1300, //R19
0x1405,         //R20, LEFT - 0X1405, I2S - 0x1404, RIGHT - 0x1400
0x1600  //R22
};

//variables
//I2c
HAL_StatusTypeDef status;
uint8_t u8TimerI2C_counter;
uint16_t slaveADDR;
uint8_t * RxData;
uI2CMainControls ui2cControl;
uint8_t i2cRxSize;

uint32_t u32LastReadTick = 0;
//dsp
int32_t arri32AudioBuffer2[2048];
uint16_t u16WaveformNum = 0;
uint8_t u8Waveform = 0;
uint32_t u32AudioAmp = 0;
uint8_t u8WaveformFlag = 0;
uint8_t u8Range = 4;
uint8_t u8PButton = 0;


/* USER CODE END PV */

void SystemClock_Config(void);
static void MX_GPIO_Init(void);
static void MX_DMA_Init(void);
static void MX_I2C1_Init(void);
static void MX_I2S1_Init(void);
static void MX_SPI2_Init(void);
static void MX_USART1_UART_Init(void);
static void MX_USB_OTG_FS_PCD_Init(void);
static void MX_USART3_UART_Init(void);
static void MX_TIM6_Init(void);
/* USER CODE BEGIN PFP */
void ll_spi_setup();
void ll_send_data();
void HAL_I2S_TxHalfCpltCallback(I2S_HandleTypeDef *hi2s1);
void HAL_I2S_TxCpltCallback(I2S_HandleTypeDef *hi2s1);
void i2c_1bitcycle();
void reset_i2c(I2C_HandleTypeDef *hi2c);
void i2c_rst2();
/* USER CODE END PFP */

/**
  * @brief  The application entry point.
  * @retval int
  */
int main(void)
{
  /* MCU Configuration--------------------------------------------------------*/

  /* Reset of all peripherals, Initializes the Flash interface and the Systick. */
  HAL_Init();

  /* Configure the system clock */
  SystemClock_Config();

  /* Initialize all configured peripherals */
  MX_GPIO_Init();
  MX_DMA_Init();
  MX_I2C1_Init();
  MX_I2S1_Init();
  MX_SPI2_Init();
  MX_USART1_UART_Init();
  MX_USB_OTG_FS_PCD_Init();
  MX_USART3_UART_Init();
  MX_TIM6_Init();
  /* USER CODE BEGIN 2 */
  

  //set nss high, no spi comm yet
  HAL_GPIO_WritePin(GPIOB, GPIO_PIN_12, GPIO_PIN_SET);
  //spi setup
  ll_spi_setup();
  
  //i2s dma tx start
  u8Range = 4;
  //u8Waveform = ui2cControl.sI2CMainControl.u2ButtWaveform1;
  //u8PButton = ui2cControl.sI2CMainControl.u8TestKey1;
  u8Waveform = 1;
  u8PButton = 1;
  u32AudioAmp = 0x7FFFFFFF;
  singen_def(u32AudioAmp);
  sawgen_def(u32AudioAmp);
  trigen_def(u32AudioAmp);
  sqrgen_def(u32AudioAmp);
  dsp2(u8Range, u8PButton, u8Waveform, u32AudioAmp, arri32AudioBuffer2);
  //status = HAL_I2S_Transmit_DMA(&hi2s1, (uint16_t*)arri32AudioBuffer2, 2048);
  
  //dsp_blitbspline(u8Range, u8PButton, u8Waveform, u32AudioAmp, arri32AudioBuffer2);
  status = HAL_I2S_Transmit_DMA(&hi2s1, (uint16_t*)arri32AudioBuffer2, 2048);
  
  
  //I2C timer
  u8TimerI2C_counter = 0;
  //HAL_TIM_Base_Start_IT(&htim6);
  
  u32LastReadTick = HAL_GetTick();

  /* USER CODE END 2 */

  /* Infinite loop */
  /* USER CODE BEGIN WHILE */
  while (1)
  {
    if ((HAL_GetTick() - u32LastReadTick) > TICKDELAY){
      switch(u8TimerI2C_counter){
      case 0:
        //SlidePot
        RxData = &ui2cControl.au8I2CMainByteAccess[0];
        slaveADDR = SLIDEPOT_ADDR;
        i2cRxSize = SLIDEPOT_RXSIZE;
        break;
      case 1:
        //Plugpot
        RxData = &ui2cControl.au8I2CMainByteAccess[12];
        slaveADDR = PLUGPOT_ADDR;
        i2cRxSize = PLUGPOT_RXSIZE;      
        break;
      case 2:
        //Keyboard
        RxData = &ui2cControl.au8I2CMainByteAccess[25];
        slaveADDR = KEYPOT_ADDR;
        i2cRxSize = KEY_RXSIZE;  
        break;
      default:
        //SlidePot
        RxData = &ui2cControl.au8I2CMainByteAccess[0];
        slaveADDR = SLIDEPOT_ADDR;
        i2cRxSize = SLIDEPOT_RXSIZE;  
        break;
      }
      status = HAL_I2C_Master_Receive(&hi2c1, slaveADDR, RxData, i2cRxSize, 30);
      if(u8TimerI2C_counter >= 2){
        u8TimerI2C_counter = 0;
      }
      else{
        u8TimerI2C_counter++;
      }
    u32LastReadTick = HAL_GetTick();
    }

    /* USER CODE END WHILE */

    /* USER CODE BEGIN 3 */
  }
  /* USER CODE END 3 */
}

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
/* USER CODE BEGIN 4 */
void ll_spi_setup(){
  //HAL_Delay(10);
  unsigned int SPI_SETUP_SIZE = sizeof(SPI_SETUP_REG)/sizeof(SPI_SETUP_REG[0]);
  //spi enable
  LL_SPI_Enable(SPI2);
  //send datas
  ll_send_data(SPI_SETUP_REG, SPI_SETUP_SIZE);
  
  //nss soft??

  
}

void ll_send_data(uint16_t* data, unsigned int size){
  //*********
  //SOURCES
  //https://hackaday.com/2022/10/24/bare-metal-stm32-setting-up-and-using-spi/
  //https://usermanual.wiki/Document/Reference20manualF446RE.1190689300/view
  //http://www.disca.upv.es/aperles/arm_cortex_m3/llibre/st/STM32F439xx_User_Manual/group__spi__ll__em__write__read.html
  //*********
  //sending "size" number of datas
  for(uint16_t i=0; i<size; i++)
  {  
    //set nss low to start communication
    HAL_GPIO_WritePin(GPIOB, GPIO_PIN_12, GPIO_PIN_RESET);

    //wait while transfer register is empty
    while(!(SPI2->SR & LL_SPI_SR_TXE));
    //Write data (8-16 bits) into SPI_DR
    //SPI2->DR = data[i];
    LL_SPI_TransmitData16(SPI2, data[i]);
  
    //wait while transfer register is empty
    while(!(SPI2->SR & LL_SPI_SR_TXE));
    //Wait for SPI_SR_BSY (status register: bus busy) to become false.
    while((SPI2->SR & LL_SPI_SR_BSY)); 
    //nss low, end of spi comm
    HAL_Delay(2);
    HAL_GPIO_WritePin(GPIOB, GPIO_PIN_12, GPIO_PIN_SET);
    HAL_Delay(10);
  }
  //Clear overrun flag????
  HAL_Delay(10);
  
  
  //other ideas, mainly trash
  //while(LL_SPI_ReadReg(hi2s1.Instance->SR, LL_SPI_SR_TXE));
  //Write data (8-16 bits) into SPI_DR
  //LL_SPI_TransmitData16(hi2s1.Instance, data);
  
}

void HAL_I2S_TxHalfCpltCallback(I2S_HandleTypeDef *hi2s1){ 
  dsp2(u8Range, u8PButton, u8Waveform, u32AudioAmp, arri32AudioBuffer2);
  //dsp_blitbspline(u8Range, u8PButton, u8Waveform, u32AudioAmp, arri32AudioBuffer2);
}

void HAL_I2S_TxCpltCallback(I2S_HandleTypeDef *hi2s1){
  dsp2(u8Range, u8PButton, u8Waveform, u32AudioAmp, &arri32AudioBuffer2[1024]);
  //dsp_blitbspline(u8Range, u8PButton, u8Waveform, u32AudioAmp, &arri32AudioBuffer2[1024]);
}

void i2c_1bitcycle(){
  unsigned u32CycleReadTick = 0;
  //SCL=0
  HAL_GPIO_WritePin(GPIOB, GPIO_PIN_6, GPIO_PIN_RESET);
  //wait 1 i2c bit time
  u32CycleReadTick = HAL_GetTick();
  while((HAL_GetTick() - u32CycleReadTick) > 1);
  //SCL=1
  HAL_GPIO_WritePin(GPIOB, GPIO_PIN_6, GPIO_PIN_SET);
  //wait 1 i2c bit time
  u32CycleReadTick = HAL_GetTick();
  while((HAL_GetTick() - u32CycleReadTick) > 1);
}


void reset_i2c(I2C_HandleTypeDef *hi2c){
  GPIO_InitTypeDef GPIO_InitStruct = {0};
  __HAL_RCC_GPIOB_CLK_ENABLE();
  
  //SCL
  HAL_GPIO_WritePin( GPIOB, GPIO_PIN_6, GPIO_PIN_SET );
  GPIO_InitStruct.Pin = GPIO_PIN_6;
  GPIO_InitStruct.Mode = GPIO_MODE_OUTPUT_OD;
  GPIO_InitStruct.Pull = GPIO_NOPULL;
  //GPIO_InitStruct.Alternate = ;
  HAL_GPIO_Init(GPIOB, &GPIO_InitStruct);
  
  //SDA
  HAL_GPIO_WritePin( GPIOB, GPIO_PIN_7, GPIO_PIN_SET );
  GPIO_InitStruct.Pin = GPIO_PIN_7;
  GPIO_InitStruct.Mode = GPIO_MODE_OUTPUT_OD;
  GPIO_InitStruct.Pull = GPIO_NOPULL;
  HAL_GPIO_Init(GPIOB, &GPIO_InitStruct);
  
  i2c_1bitcycle();
  
  uint32_t u32ClockCycles = 0;
  while(!((HAL_GPIO_ReadPin(GPIOB, GPIO_PIN_7) == GPIO_PIN_SET))){
  //while(READ_BIT(hi2c->Instance->SR2, I2C_SR2_BUSY)){
      i2c_1bitcycle();
      u32ClockCycles++;
      if( u32ClockCycles > 8 )
      {
        //TODO: hibakezelés
        break;
      }
  }
  
  // Start: SDA falledg while SCL High 
  HAL_GPIO_WritePin(GPIOB, GPIO_PIN_7, GPIO_PIN_RESET);
  HAL_Delay(1);
  //Stop: SDA risedg while SCL High 
  HAL_GPIO_WritePin(GPIOB, GPIO_PIN_7, GPIO_PIN_SET);
  HAL_Delay(1);
  
  SET_BIT(hi2c->Instance->CR1, I2C_CR1_SWRST);
  HAL_Delay( 10 );
  CLEAR_BIT(hi2c->Instance->CR1, I2C_CR1_SWRST);
  
  MX_GPIO_Init();
  MX_I2C1_Init();
}
//not working, the bitbanging...
void i2c_rst2()
{
  LL_GPIO_InitTypeDef GPIO_InitStruct = {0};
  uint8_t u8Cycles;
 
  /**I2C1 GPIO Configuration
  PB6   ------> I2C1_SCL
  PB7   ------> I2C1_SDA
  */
  GPIO_InitStruct.Pin = GPIO_PIN_6|GPIO_PIN_7;
  GPIO_InitStruct.Mode = LL_GPIO_MODE_OUTPUT;
  GPIO_InitStruct.Speed = LL_GPIO_SPEED_FREQ_VERY_HIGH;
  GPIO_InitStruct.OutputType = LL_GPIO_OUTPUT_OPENDRAIN;
  GPIO_InitStruct.Pull = LL_GPIO_PULL_NO;
  GPIO_InitStruct.Alternate = LL_GPIO_AF_4;
  LL_GPIO_Init(GPIOB, &GPIO_InitStruct);
 
  HAL_Delay( 1u );
  if( LL_GPIO_IsInputPinSet( GPIOB, LL_GPIO_PIN_6 ) )  // SCL == 1
  {
    LL_GPIO_ResetOutputPin(GPIOB, LL_GPIO_PIN_6);  // SCL = 0
    HAL_Delay( 1u );
  }
  LL_GPIO_SetOutputPin(GPIOB, LL_GPIO_PIN_7);  // SDA = 1
  HAL_Delay( 1u );
 
  for( u8Cycles = 0u; u8Cycles < 9u; u8Cycles++ )
  {
    // If the slave released SDA
    if( LL_GPIO_IsInputPinSet( GPIOB, LL_GPIO_PIN_7 ) )  // SDA == 1
    {
      break;
    }
    else  // slave currently pulls the SDA line
    {
      // Generate one SCL cycle
      LL_GPIO_SetOutputPin(GPIOB, LL_GPIO_PIN_6);  // SCL = 1
      HAL_Delay( 1u );
      LL_GPIO_ResetOutputPin(GPIOB, LL_GPIO_PIN_6);  // SCL = 0
      HAL_Delay( 1u );
    }
  }
 
  // Generate stop condition
  LL_GPIO_ResetOutputPin(GPIOB, LL_GPIO_PIN_7);  // SDA = 0
  HAL_Delay( 1u );
  LL_GPIO_SetOutputPin(GPIOB, LL_GPIO_PIN_6);  // SCL = 1
  HAL_Delay( 1u );
  LL_GPIO_SetOutputPin(GPIOB, LL_GPIO_PIN_7);  // SDA = 1
  HAL_Delay( 1u );
  
  //MX_GPIO_Init();
  //MX_I2C1_Init();
}
/* USER CODE END 4 */
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
