torok-samuel/Digital-synthesizer-project/software_keyboard/Core/Inc/main.h

#define SW1_Pin GPIO_PIN_0
#define SW1_GPIO_Port GPIOA
#define SW2_Pin GPIO_PIN_1
#define SW2_GPIO_Port GPIOA
#define SW3_Pin GPIO_PIN_2
#define SW3_GPIO_Port GPIOA
#define SW4_Pin GPIO_PIN_3
#define SW4_GPIO_Port GPIOA
#define SW5_Pin GPIO_PIN_4
#define SW5_GPIO_Port GPIOA
#define SW6_Pin GPIO_PIN_5
#define SW6_GPIO_Port GPIOA
#define SW7_Pin GPIO_PIN_6
#define SW7_GPIO_Port GPIOA
#define SW8_Pin GPIO_PIN_7
#define SW8_GPIO_Port GPIOA
#define SW9_Pin GPIO_PIN_0
#define SW9_GPIO_Port GPIOB
#define SW10_Pin GPIO_PIN_1
#define SW10_GPIO_Port GPIOB
#define SW11_Pin GPIO_PIN_2
#define SW11_GPIO_Port GPIOB
#define SW12_Pin GPIO_PIN_8
#define SW12_GPIO_Port GPIOA
#define STATUS_LED_Pin GPIO_PIN_6
#define STATUS_LED_GPIO_Port GPIOB
