torok-samuel/Digital-synthesizer-project/software_slidepot/Core/Inc/digitalsynth_slide_butt.h

#ifndef __DIGITALSYNTH_SLIDE_BUTT_H
#define __DIGITALSYNTH_SLIDE_BUTT_H

#include <stdint.h>
#include <stdbool.h>


//func
void getNewState();
void setButtonState();
void refreshOldState();
void HAL_TIM_PeriodElapsedCallback(TIM_HandleTypeDef *htim);

#endif /* __DIGITALSYNTH_SLIDE_I2C_H */
