torok-samuel/Digital-synthesizer-project/(commit log)

2023-04-24 forgot other 2 projects
    [LEDS_WS2812B.kicad_sch, Pot.butt_pcb.kicad_pcb, Pot.butt_pcb.kicad_sch, Switches.kicad_sch, key_stm32g030k6t6.kicad_sch, keyboard.kicad_pcb, keyboard.kicad_sch, keys.kicad_sch]
2023-04-25 main func schematics fixed
    [chargerm.kicad_sch, dac_conv.kicad_sch, dcdc_convs.kicad_sch, main_func.kicad_sch, midi_jacks.kicad_sch, stm32f446.kicad_sch, untitled.kicad_sch, usb_c.kicad_sch]
2023-04-26 fixing keyboard and pot project schematics
    [LEDS_WS2812B.kicad_sch, Pot.butt_pcb.kicad_sch, chargerm.kicad_sch, dac_conv.kicad_sch, dcdc.kicad_sch, dcdc_convs.kicad_sch, key_stm32g030k6t6.kicad_sch, keyboard.kicad_sch]
2023-04-28 main_func pcb done
    [Pot.butt_pcb.kicad_sch, chargerm.kicad_sch, dac_conv.kicad_sch, dcdc_convs.kicad_sch, key_stm32g030k6t6.kicad_sch, keyboard.kicad_sch, main_func.kicad_pcb, main_func.kicad_sch]
2023-04-30 Pot.but_pcb in progress
    [Pot.butt_pcb.kicad_pcb, Pot.butt_pcb.kicad_sch, Switches.kicad_sch, main_func.kicad_pcb, main_func.kicad_sch, midi_jacks.kicad_sch, plugin_potentiometer.kicad_sch, plugpot_stm32g030k6t6.kicad_sch]
2023-05-01 Pot.butt_pcb done
    [Pot.butt_pcb.kicad_pcb, slidepot_stm32g030k6t6.kicad_sch]
2023-05-02 PCB designs done v1
    [key_stm32g030k6t6.kicad_sch, keyboard.kicad_pcb, keyboard.kicad_sch]
2023-05-08 pcb design fixing
    [Pot.butt_pcb.kicad_pcb, Pot.butt_pcb.kicad_sch, Switches.kicad_sch, chargerm.kicad_sch, dac_conv.kicad_sch, key_stm32g030k6t6.kicad_sch, keyboard.kicad_pcb, keyboard.kicad_sch]
2023-05-08 pcb mounting hole change
    [Pot.butt_pcb.kicad_pcb, keyboard.kicad_pcb, main_func.kicad_pcb]
2023-05-13 gerber files generated
    [Pot.butt_pcb-B_Cu.gbr, Pot.butt_pcb-B_Mask.gbr, Pot.butt_pcb-B_Paste.gbr, Pot.butt_pcb-B_Silkscreen.gbr, Pot.butt_pcb-Edge_Cuts.gbr, Pot.butt_pcb-F_Cu.gbr, Pot.butt_pcb-F_Mask.gbr, Pot.butt_pcb-F_Paste.gbr]
2023-09-14 Software added
    [main_func.csv]
2023-10-30 Freecad files added
    [BlackKey-Body.stl, BlackKey.FCStd, KeyPlate-Body.stl, KeyPlate.FCStd, PotKeyPlate-Body.stl, PotKeyPlate.FCStd, WhiteKey-Body.stl, WhiteKey.FCStd]
2023-10-30 CLEANUP DONE Bitbang reset failed for 250ms error => slave reset
    [digitalsynth_dsp.c, digitalsynth_dsp.h, digitalsynth_key_i2c.h, digitalsynth_keyit.c, digitalsynth_main_i2c.c, digitalsynth_main_i2c.h, digitalsynth_slide_butt.c, digitalsynth_slide_i2c.h]
2023-10-30 Forgot WhiteKey3
    [WhiteKey3-Body.stl, WhiteKey3.FCStd]
2023-11-07 freecad files fixed
    [KeyPlate-Body.stl, KeyPlate.FCStd, PotKeyPlate-Body.stl, PotKeyPlate.FCStd]
2023-11-30 blit implementation in stm32
    [KeyPlate-Body.stl, KeyPlate.FCStd, PotKeyPlate-Body.stl, PotKeyPlate.FCStd]
